squidlydeadly/projet-5-credits/Documents/Rapports/Rapport concepte/fichiers/echeancier1.JPG

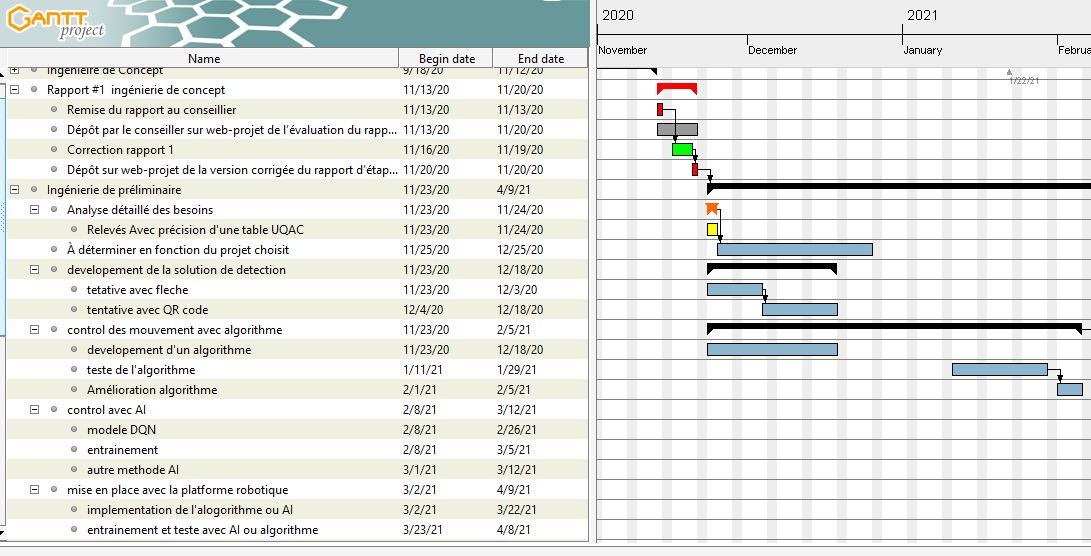
Documents/Rapports/Rapport concepte/fichiers/echeancier1.JPG
