squidlydeadly/projet-5-credits/Documents/Rapports/Rapport concepte/fichiers/echeancier.JPG

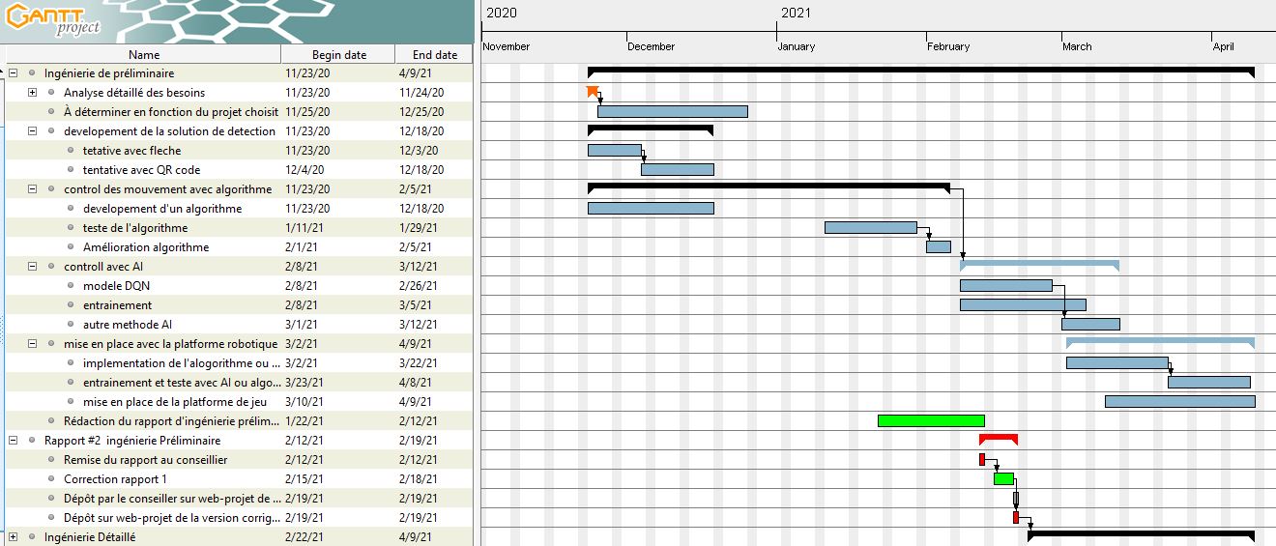
Documents/Rapports/Rapport concepte/fichiers/echeancier.JPG
