squidlydeadly/projet-5-credits/Documents/Estimations/estimation_concept.pdf

Achat de matériel | qte. | prix unitaire | total VAN($)
Plateforme robotique | 4.00 | 40.00 | 160.00
Camera | 1.00 | 150.00 | 150.00
Autres capteurs | 1.00 | 100.00 | 100.00
Impression des pièces | 4.00 | 25.00 | 100.00
Parcours | 1.00 | 200.00 | 200.00
Ordinateur serveur | 1.00 | 1500.00 | 1500.00
ESP32 | 4.00 | 15.00 | 60.00
Drive H-bridge | 4.00 | 5.00 | 20.00
servomoteur frappeur | 4.00 | 10.00 | 40.00
contrôleurs sans fil | 2.00 | 65.00 | 130.00
Pile LiPo | 4.00 | 25.00 | 100.00
quincaillerie | 1.00 | 200.00 | 200.00
support à caméra | 1.00 | 50.00 | 50.00
Router/commutateur de réseau | 1.00 | 100.00 | 100.00
| Sous total ($) | | 2910.00
Achat de logiciel et services | qte. | prix unitaire | total ($)
Éditeur de texte | 1 | 0 | 0
Open source M.L. API | 1 | 0 | 0
Simulateur de robotique | 1 | 0 | 0
| sous total ($) | | 0
Main d'œuvre et ing. | heures | taux horaire | total ($)
Recherche et documentation | 150 | 60 | 9000
Conception | 100 | 60 | 6000
Programmation et implémentation | 370 | 60 | 22200
Tests et améliorations | 100 | 60 | 6000
Fabrication des robots | 25 | 60 | 1500
Total des heures | 745
| sous total ($) | | 44700
| Grand total ($) | | 47610.00
Estimation de concepte | IA serveur local
