squidlydeadly/projet-5-credits/Documents/Rapports/Rapport concepte/fichiers/robot.pdf

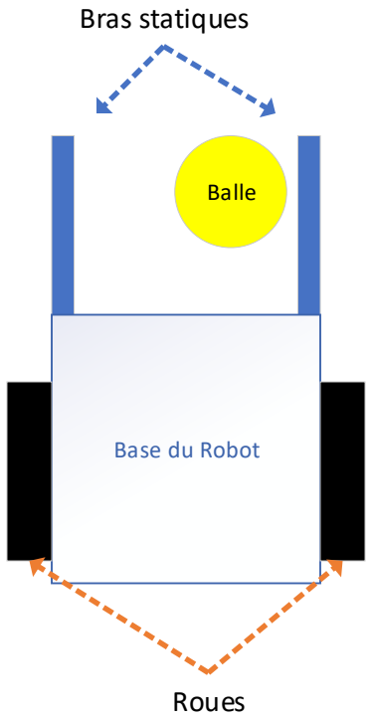
[picture p15: figure]
Base du Robot; Balle; Bras statiques; Roues
