squidlydeadly/projet-5-credits/Documents/Gantt/Échéanciers_détaillé.pdf

ID | Task Name | Duration | Start
1 | Proposition de services | 10 days | Thu 9/17/20
7 | Ingénieire de Concept | 40 days | Fri 9/18/20
26 Rapport #1 ingénierie de | concept | 6 days | Fri 11/13/20
31 | Ingénierie préliminaire | 86 days? | Mon 11/23/20
47 Rapport #2 ingénierie | Préliminaire | 6 days | Fri 2/12/21
52 | Ingénierie Détaillé | 31 days? | Mon 2/22/21
53 | Vision et controle | 41 days | Mon 2/8/21
54 Développement de | l'algorithme de vision sous sa forme actuelle | 26.5 days | Mon 2/8/21
55 | Monter le serveur MQTT | 6 days | Wed 3/3/21
56 Lier le contrôle des | robots avec le serveur | 3 days | Thu 3/11/21
57 Implémentation de | l'algorithme de vision | 4 days | Tue 3/16/21
58 Lier la vision avec la prise | de décision | 5 days | Sun 3/21/21
59 Rafiner l'algorithme de | vision | 8 days | Thu 3/25/21
60 Conception et réglage du | compensateur PID | 6 days | Thu 3/25/21
61 Dépoiement sur le Nvidia | Jeston | 4 days | Wed 3/31/21
13 | 16 | 19 | 22 | 25 | 28 | 3 | 6 | 9 | 12 | 15 | 18 | 21 | 24 | 27 | 30 | 2 | 5 | 8 | 11 | 14 | 17 | 20 | 23 | 26 | 29
March 2021 | April 2021

Task
Split
Milestone
Summary
Project Summary
Inactive Task
Inactive Milestone

Inactive Summary
Manual Task
Duration-only
Manual Summary Rollup
Manual Summary
Start-only
Finish-only

External Tasks
External Milestone
Deadline
Progress
Manual Progress

Page 1

Project: Project1
Date: Mon 4/5/21

62 | Parcours | 51 days | Fri 1/22/21
63 Achat et reception des | pièces du parcours | 21 days | Mon 3/1/21
64 Conception des pièces | imprimés pour le parcours | 20 days | Fri 1/22/21
65 Impression des pieces | imprimés 3D | 26.24 days | Fri 2/19/21
66 | Assemblage du parcours | 13 days | Tue 3/16/21
67 | Transport | 7 days | Thu 3/25/21
68 Achate de la valise de | transport | 2 days | Thu 3/25/21
69 Acquisition et | découpage de la mousse de trasnport | 1 day | Sat 3/27/21
70 Installation du support | à tige la valise de transport | 2 days | Thu 4/1/21
71 | Robots | 38 days | Thu 2/11/21
72 Programmation des | microcontroleurs | 23 days | Thu 2/18/21
73 Conception des pièces de | robot | 12 days | Wed 2/17/21
74 Impression des pièces de | robots | 2 days | Fri 3/5/21
75 | Assemblage des robots | 1 day | Sun 4/4/21

Project: Project1 Date: Mon 4/5/21

13 | 16 | 19 | 22 | 25 | 28 | 3 | 6 | 9 | 12 | 15 | 18 | 21 | 24 | 27 | 30 | 2 | 5 | 8 | 11 | 14 | 17 | 20 | 23 | 26 | 29

Task
Split
Milestone
Summary
Project Summary
Inactive Task
Inactive Milestone

Inactive Summary
Manual Task
Duration-only
Manual Summary Rollup
Manual Summary
Start-only
Finish-only

External Tasks
External Milestone
Deadline
Progress
Manual Progress

Page 2

76 Tester les robots | assemblés | 1 day | Mon 4/5/21
77 | Piles | 38 days | Thu 2/11/21
78 Évaluation de la pile à | acheter | 10 days | Thu 2/11/21
79 Achat des piles et | chargeurs | 26 days | Thu 2/25/21
80 Rédaction de la | procédure de recharge sécuritaire des piles | 4 days | Wed 3/31/21
81 Tester l'ensemble des | composantes | 2 days | Sat 4/3/21
82 Rapport #3 ingénierie | Détaillée | 7 days | Fri 3/26/21
83 Rédaction du rapport | détaillé | 24 days | Wed 3/3/21
84 Remise du rapport au | conseillier | 1 day | Fri 3/26/21
85 | Correction rapport 3 | 4 days | Mon 3/29/21
86 Dépôt par le conseiller | sur web-projet de l’évaluation du rapport d’étape 3; ingénierie | 1 day | Fri 4/2/21
13 | 16 | 19 | 22 | 25 | 28 | 3 | 6 | 9 | 12 | 15 | 18 | 21 | 24 | 27 | 30 | 2 | 5 | 8 | 11 | 14 | 17 | 20 | 23 | 26 | 29

Task
Split
Milestone
Summary
Project Summary
Inactive Task
Inactive Milestone

Inactive Summary
Manual Task
Duration-only
Manual Summary Rollup
Manual Summary
Start-only
Finish-only

External Tasks
External Milestone
Deadline
Progress
Manual Progress

Page 3

Project: Project1
Date: Mon 4/5/21

87 Dépôt sur web-projet de | la version corrigée du rapport d’étape #3 | 1 day | Fri 4/2/21
88 | Présentation du projet | 15 days | Fri 4/9/21
89 Préparation de la | présentation | 11 days | Mon 4/5/21
90 Péresentation devant les | conseilliers | 1 day | Sat 4/17/21
91 Dépot sur web-projet du | résumé de projet | 1 day | Fri 4/9/21
92 Présentations publiques des | projets devant jury | 1 day | Tue 4/20/21
93 Rencontre du | comité-aviseur – revue des évaluations de projets | 1 day | Thu 4/29/21
13 | 16 | 19 | 22 | 25 | 28 | 3 | 6 | 9 | 12 | 15 | 18 | 21 | 24 | 27 | 30 | 2 | 5 | 8 | 11 | 14 | 17 | 20 | 23 | 26 | 29

Task
Split
Milestone
Summary
Project Summary
Inactive Task
Inactive Milestone

Inactive Summary
Manual Task
Duration-only
Manual Summary Rollup
Manual Summary
Start-only
Finish-only

External Tasks
External Milestone
Deadline
Progress
Manual Progress

Page 4

Project: Project1
Date: Mon 4/5/21
