squidlydeadly/projet-5-credits/Documents/Estimations/comparaisonDesAlgo.pdf

Algorithme | Facilité d'implémentation relatives | Performances relatives | Total
Simple | 4 | 2 | 6
Q-learning en profondeur | 3 | 4 | 7
IA avancés | 1 | 5 | 6

Comparaison des Algorithmes
