squidlydeadly/projet-5-credits/Documents/Estimations/comparaisonDesAlgo2.pdf

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
Simple | Q-learning en profondeur | IA avancés

## Comparaison des algorithmes

Facilité d'implémentation relatives Performances relatives
