squidlydeadly/projet-5-credits/Documents/Estimations/matrice-de-descision-1.pdf

Gestion de projet général
Respet des échéanciers | 5 | 2 | 10 | 4 | 20 | 5 | 25
cout d'acquisition | 3 | 3 | 9 | 2 | 6 | 5 | 15
Cout d'utilisation | 2 | 5 | 10 | 5 | 10 | 3 | 6

Santé-sécurité et environnement
sécurité machine | 5 | 3 | 15 | 5 | 25 | 5 | 25
Transportabilité (sst) | 5 | 4 | 20 | 4 | 20 | 5 | 25
Environnement (piles, achats) | 4 | 3 | 12 | 4 | 16 | 4 | 16

Informatique et réseaux
dépendance au réseau | 4 | 5 | 20 | 3 | 12 | 1 | 4
dépendance au service | 4 | 5 | 20 | 5 | 20 | 1 | 4
possibilité de co-opération | 2 | 2 | 4 | 5 | 10 | 5 | 10
Possibilité d'expansion | 2 | 2 | 4 | 5 | 10 | 5 | 10
fiabilité réseau | 5 | 5 | 25 | 4 | 20 | 3 | 15
sécurité réseau | 4 | 5 | 20 | 3 | 12 | 2 | 8
capacité de calcul | 4 | 2 | 8 | 4 | 16 | 5 | 20

Utilisation en présentation
respet des dimensions | 3 | 1 | 3 | 5 | 15 | 5 | 15
Temps de déploiement (en présentation) | 5 | 5 | 25 | 4 | 20 | 4 | 20
facilité de déploiement | 4 | 5 | 20 | 3 | 12 | 3 | 12
Total | | | 225 | | 244 | | 230

### Solution

Aspect analysé | Ponderation (1 - 5) | Edge | Local | Cloud
Cote 1-5 | Total | Cote 1-5 | Total | Cote 1-5 | Total
