squidlydeadly/projet-5-credits/$_10.jpg

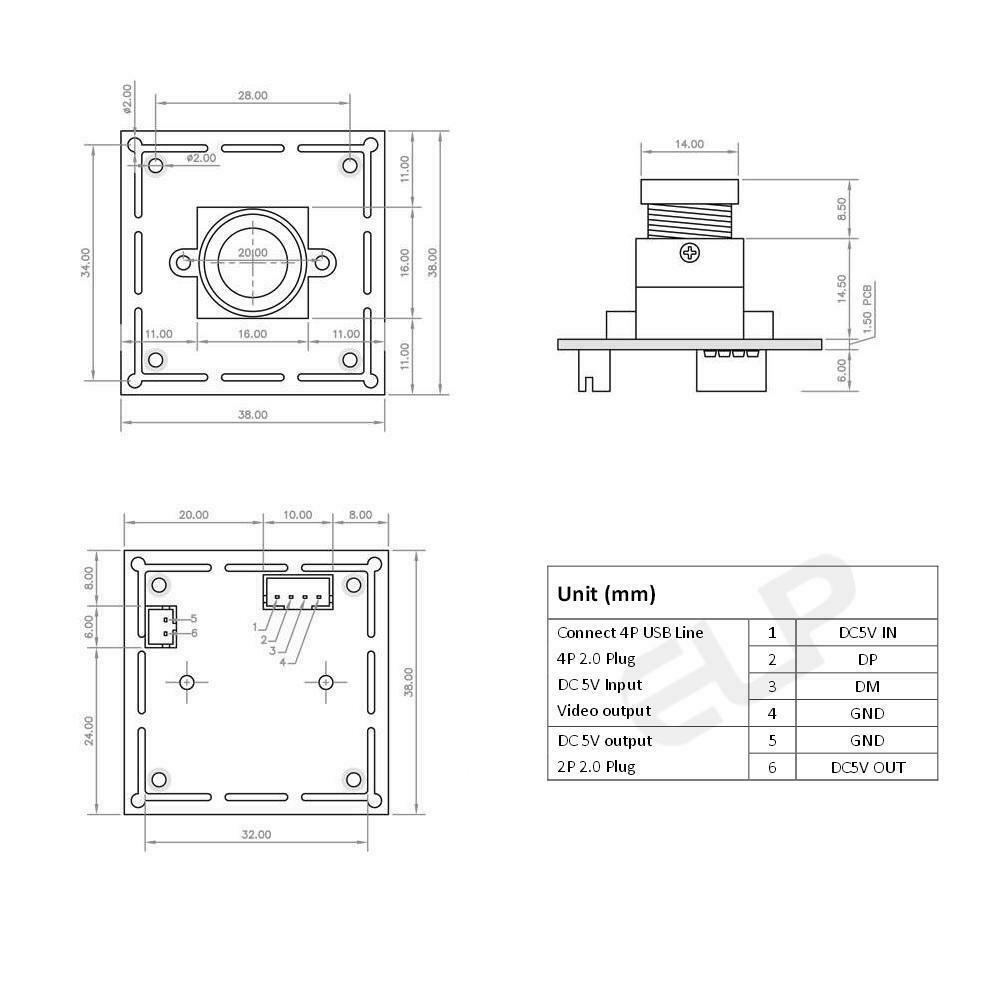
$_10.jpg
