squidlydeadly/projet-5-credits/CAD_and_drawing/img/cam.png

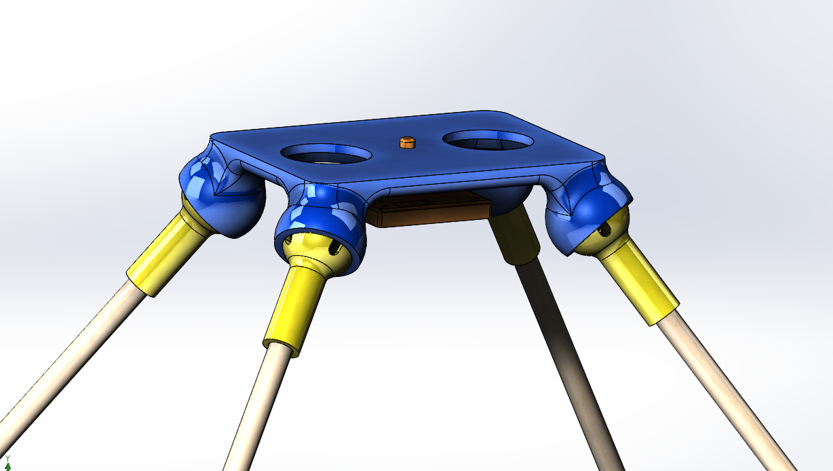
CAD_and_drawing/img/cam.png
