squidlydeadly/projet-5-credits/CAD_and_drawing/img/corner.png

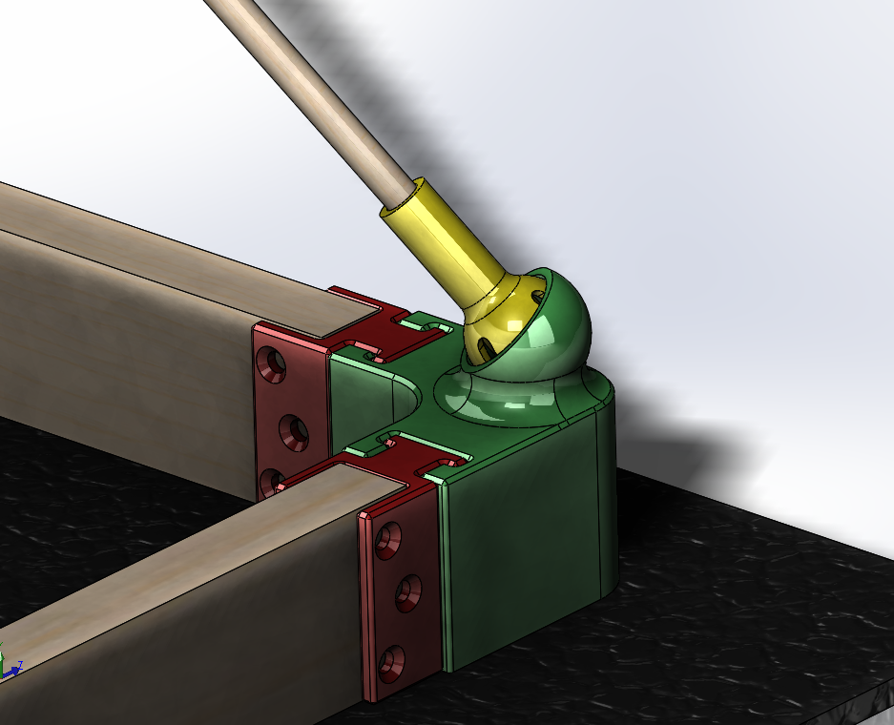
CAD_and_drawing/img/corner.png
