squidlydeadly/projet-5-credits/CAD_and_drawing/img/goal.png

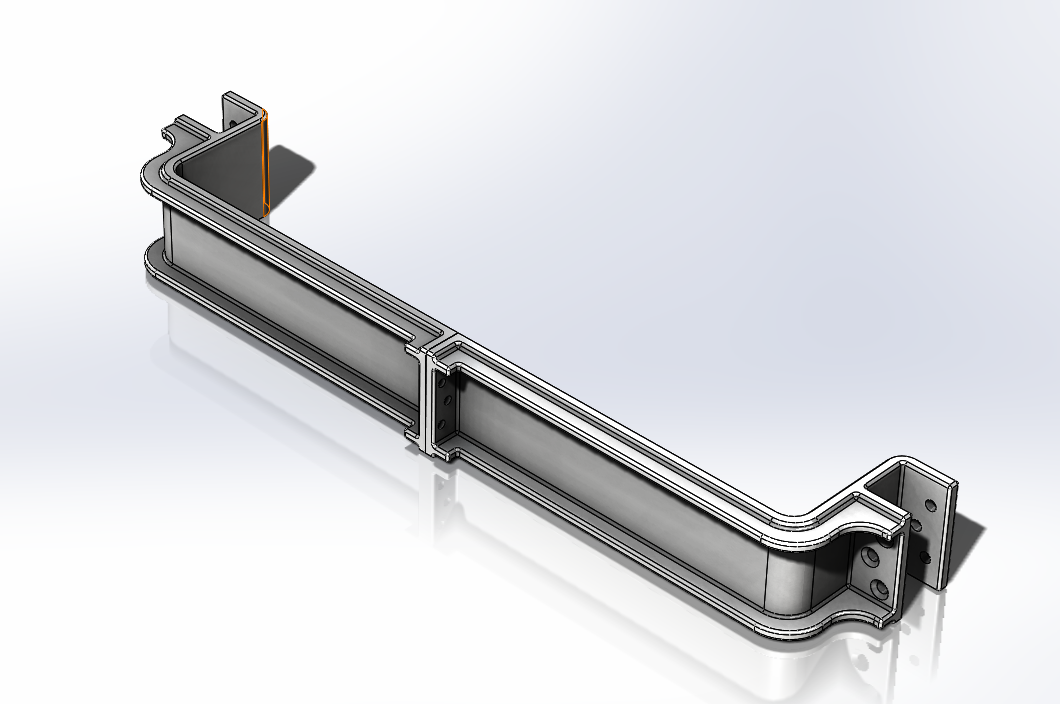
CAD_and_drawing/img/goal.png
