squidlydeadly/projet-5-credits/CAD_and_drawing/img/robot_CAD.png

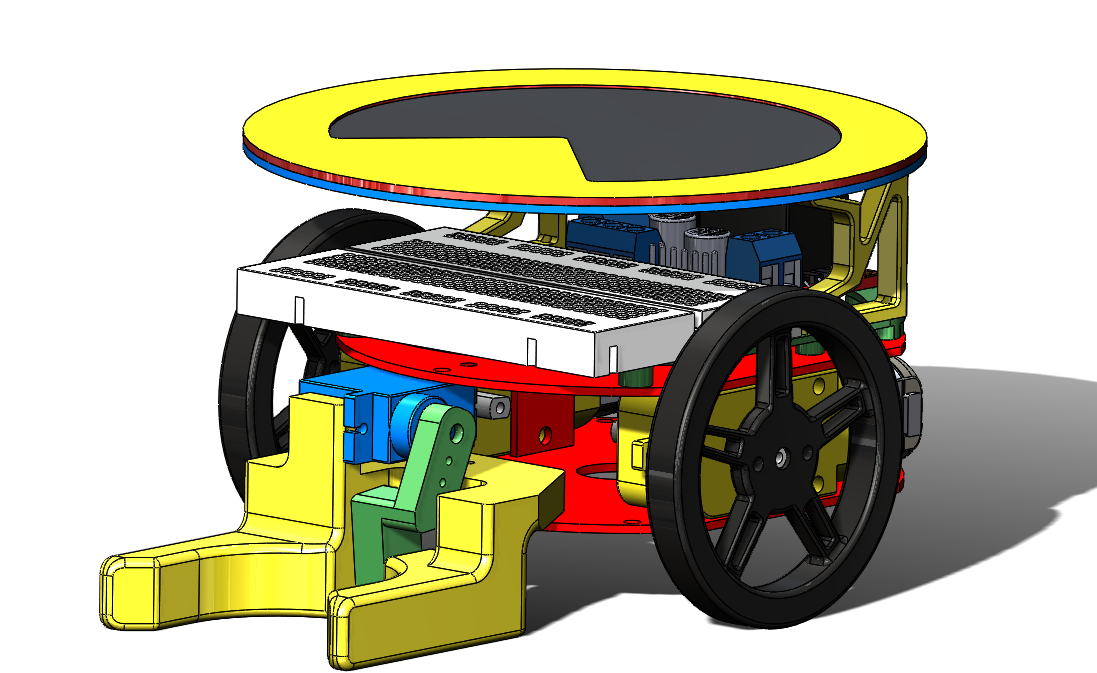
CAD_and_drawing/img/robot_CAD.png
