squidlydeadly/projet-5-credits/CAD_and_drawing/img/Screenshot 2021-03-29 090037.png

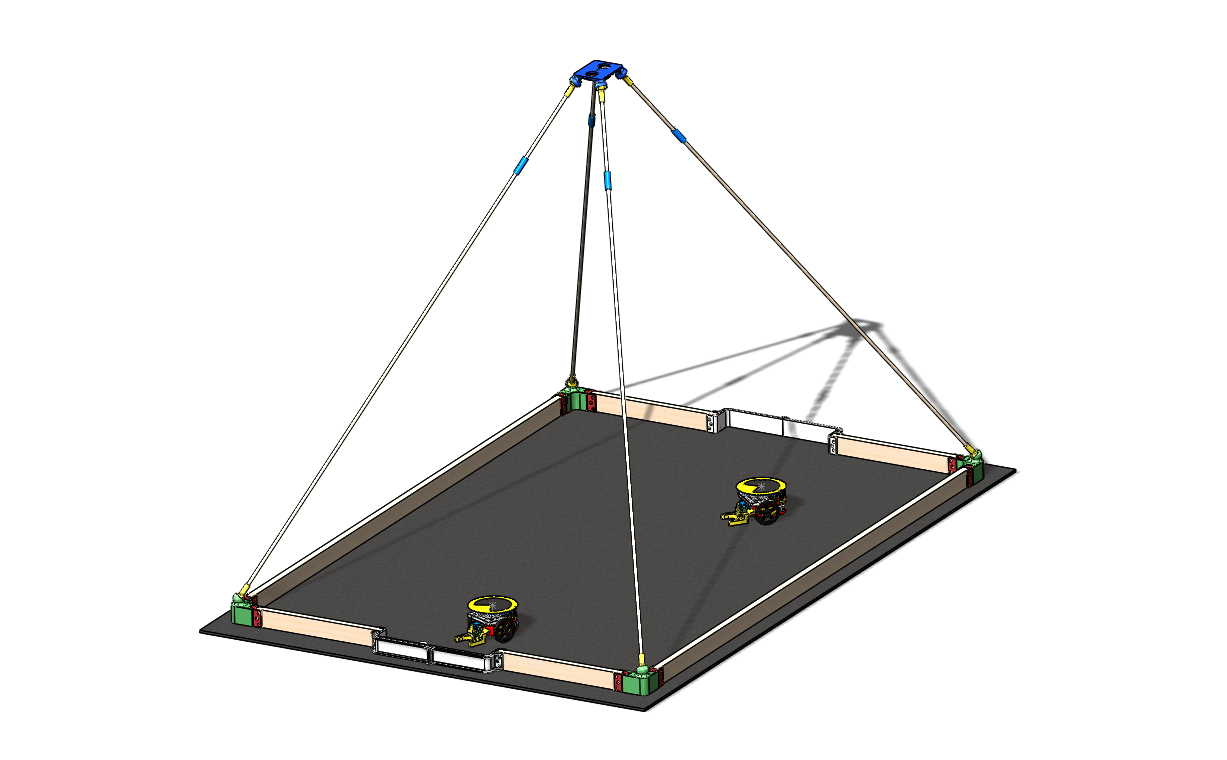
CAD_and_drawing/img/Screenshot 2021-03-29 090037.png
