squidlydeadly/projet-5-credits/CAD_and_drawing/img/Screenshot 2021-03-29 091518.png

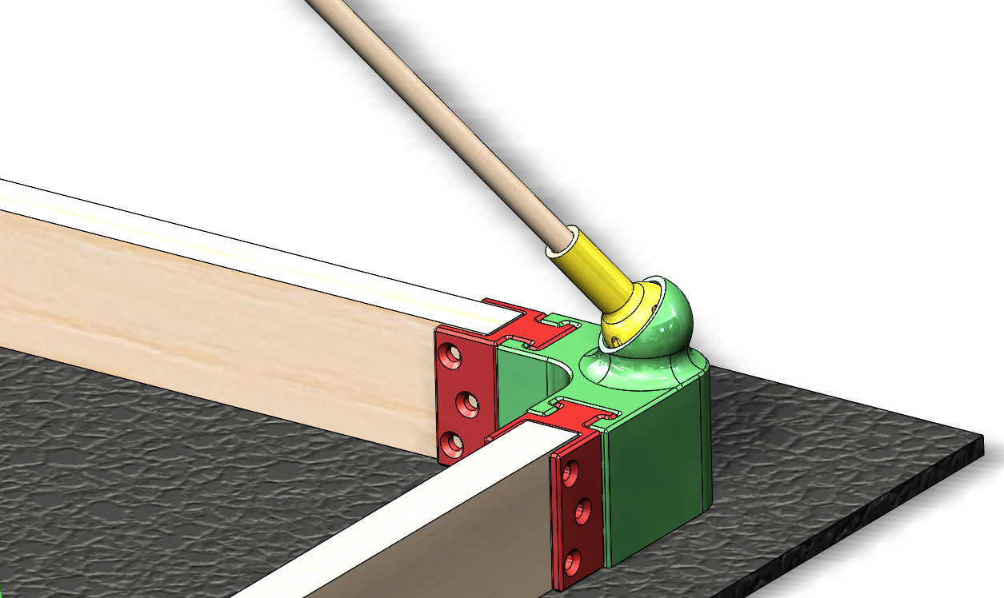
CAD_and_drawing/img/Screenshot 2021-03-29 091518.png
