squidlydeadly/projet-5-credits/CAD_and_drawing/img/Screenshot 2021-03-31 142544.png

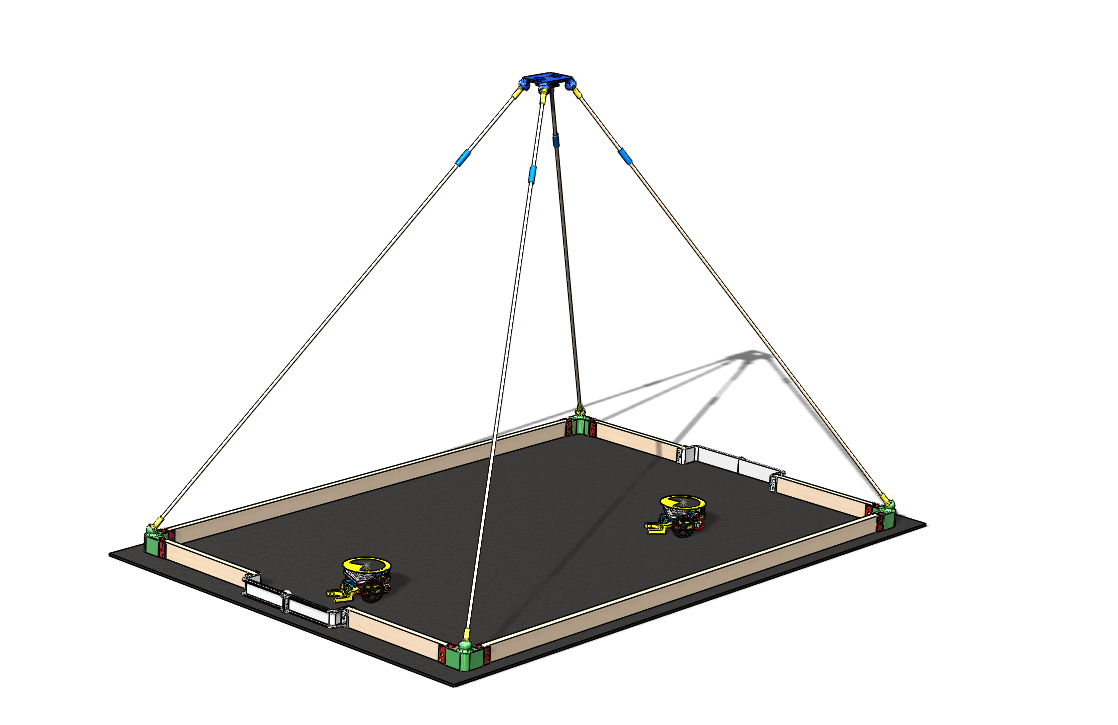
CAD_and_drawing/img/Screenshot 2021-03-31 142544.png
