squidlydeadly/projet-5-credits/CAD_and_drawing/img/terrsin.png

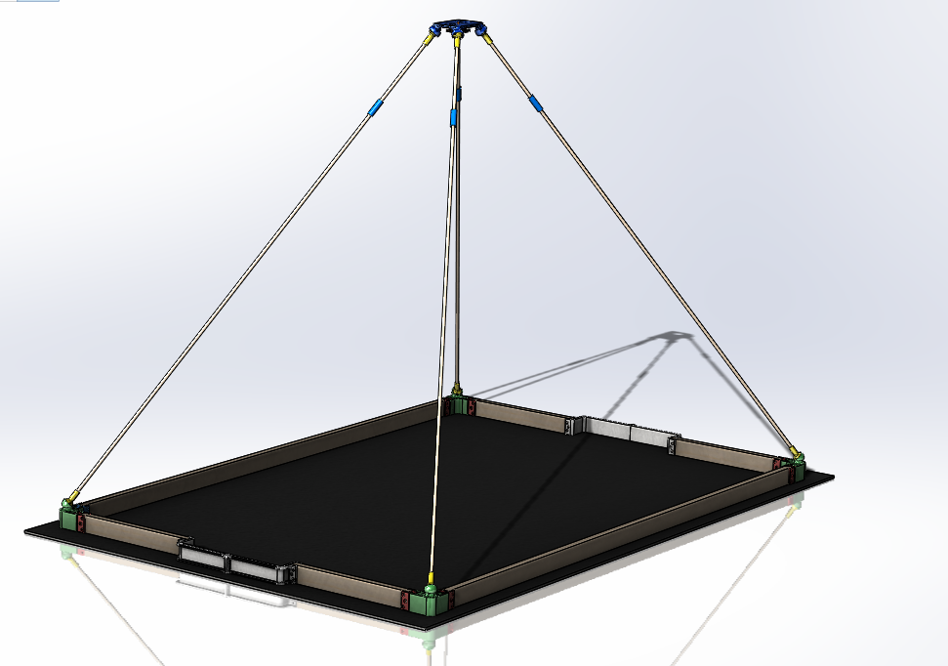
CAD_and_drawing/img/terrsin.png
