squidlydeadly/projet-5-credits/CAD_and_drawing/ROBOT/Assem1.PNG

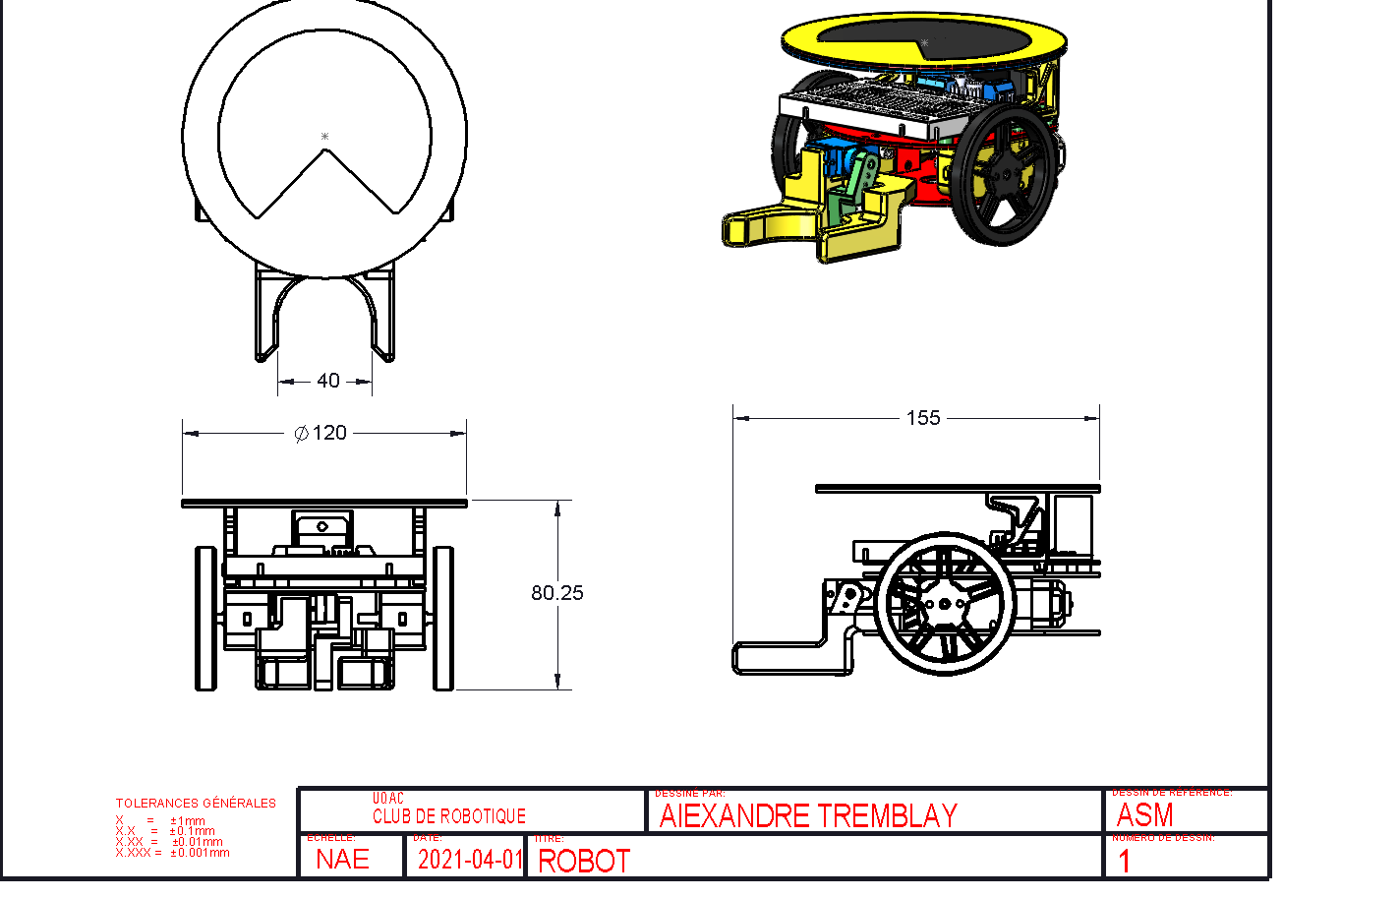
CAD_and_drawing/ROBOT/Assem1.PNG
