squidlydeadly/projet-5-credits/CAD_and_drawing/ROBOT/robot.png

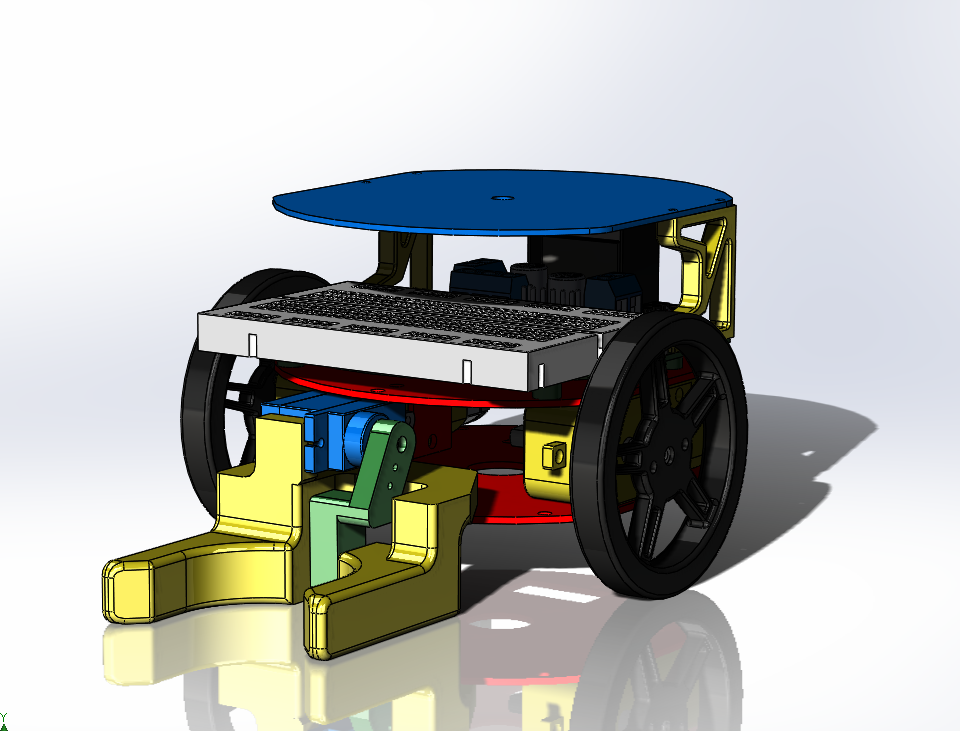
CAD_and_drawing/ROBOT/robot.png
