squidlydeadly/projet-5-credits/CAD_and_drawing/ROBOT/Screenshot 2020-12-28 092606.png

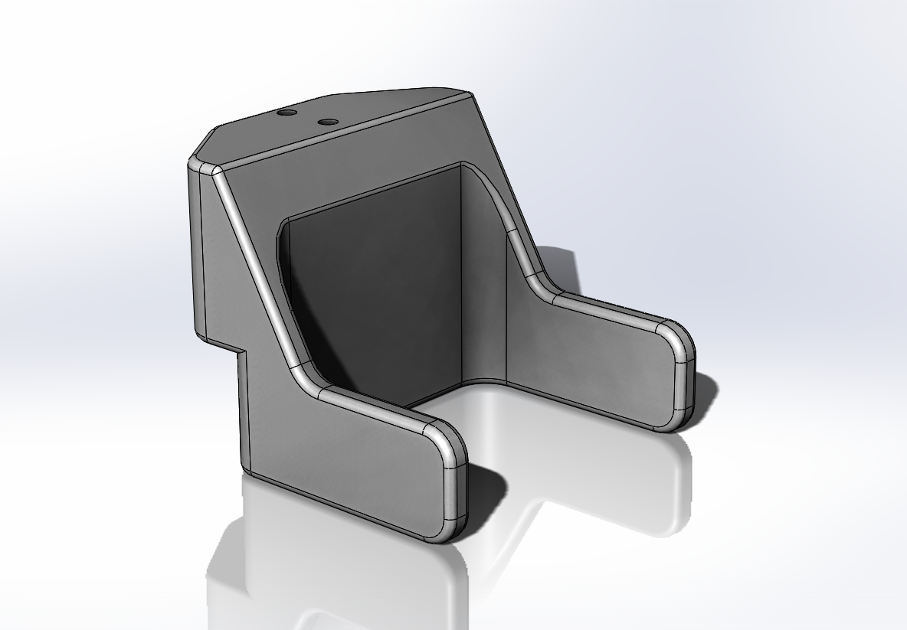
CAD_and_drawing/ROBOT/Screenshot 2020-12-28 092606.png
