squidlydeadly/projet-5-credits/CAD_and_drawing/ROBOT/Screenshot 2021-02-18 114827.png

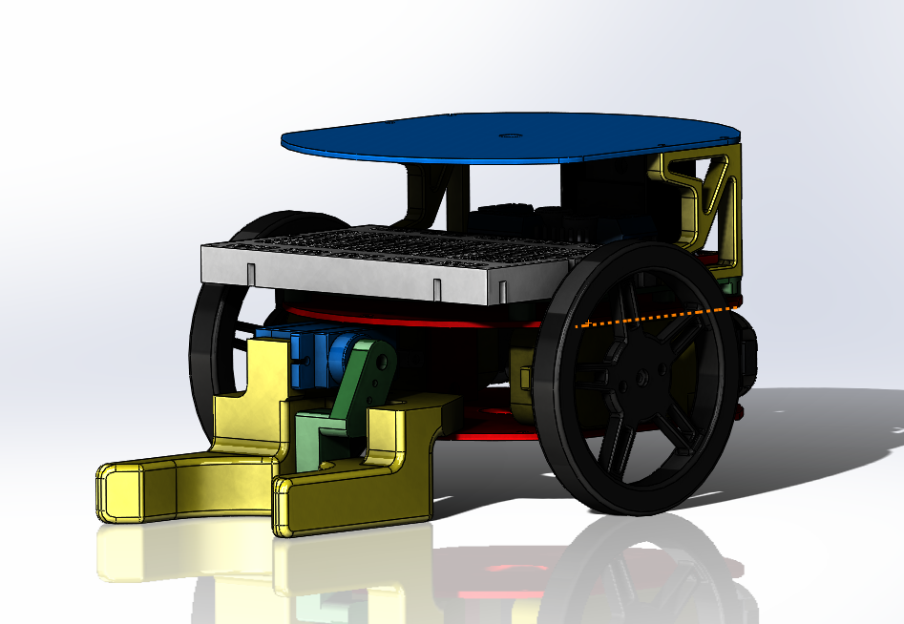
CAD_and_drawing/ROBOT/Screenshot 2021-02-18 114827.png
