squidlydeadly/projet-5-credits/CAD_and_drawing/ROBOT/Screenshot 2021-02-18 115133.png

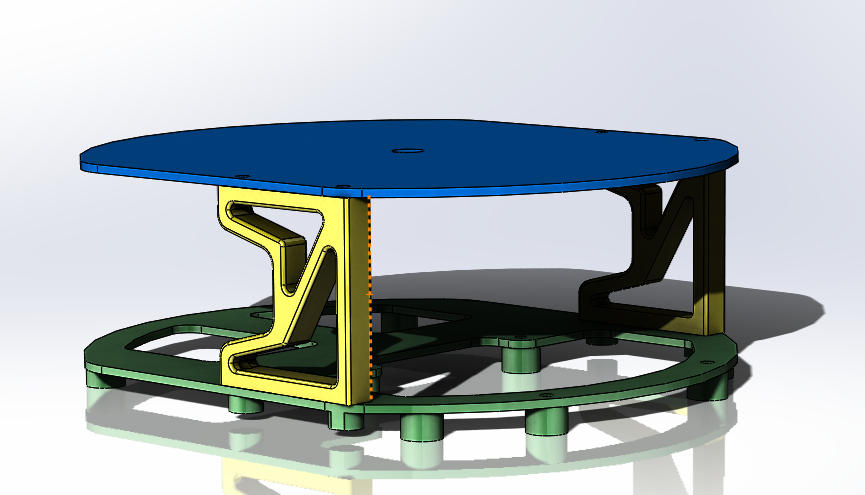
CAD_and_drawing/ROBOT/Screenshot 2021-02-18 115133.png
