squidlydeadly/projet-5-credits/CAD_and_drawing/ROBOT/support.png

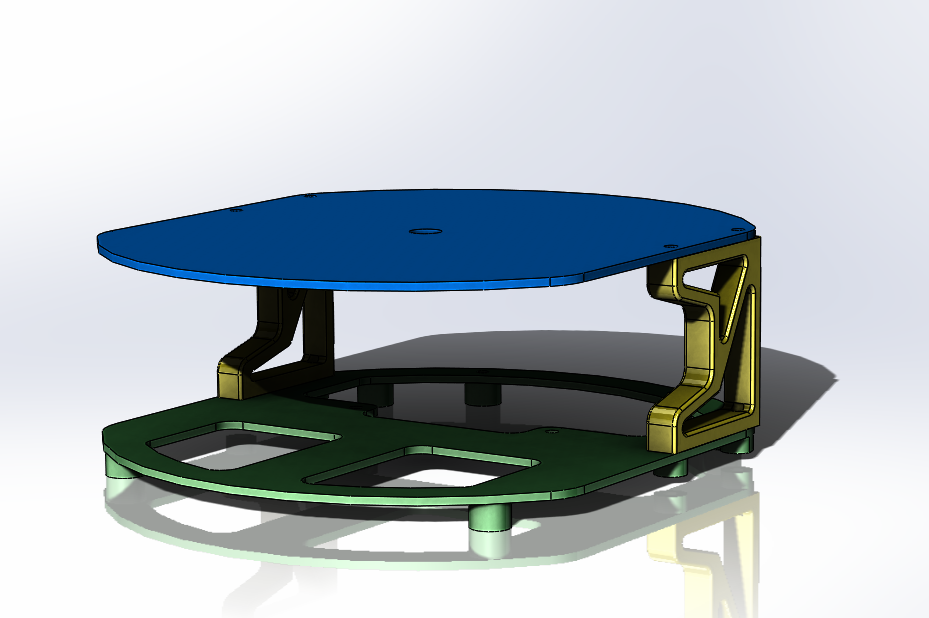
CAD_and_drawing/ROBOT/support.png
