squidlydeadly/projet-5-credits/CAD_and_drawing/TERRAIN/TERRAIN.PNG

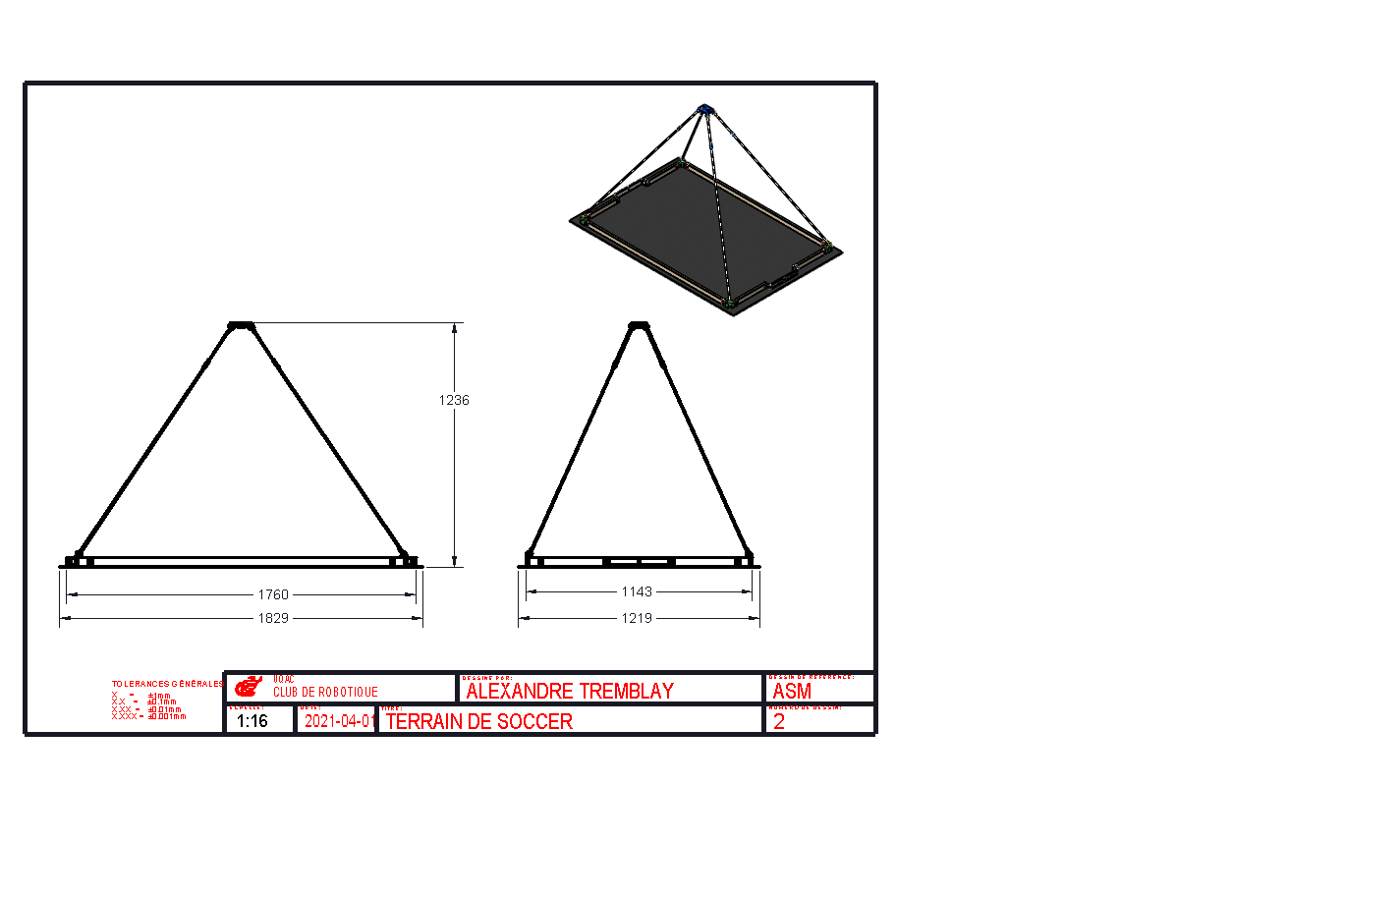
CAD_and_drawing/TERRAIN/TERRAIN.PNG
