squidlydeadly/projet-5-credits/Documents/Gantt/Projet1.jpg

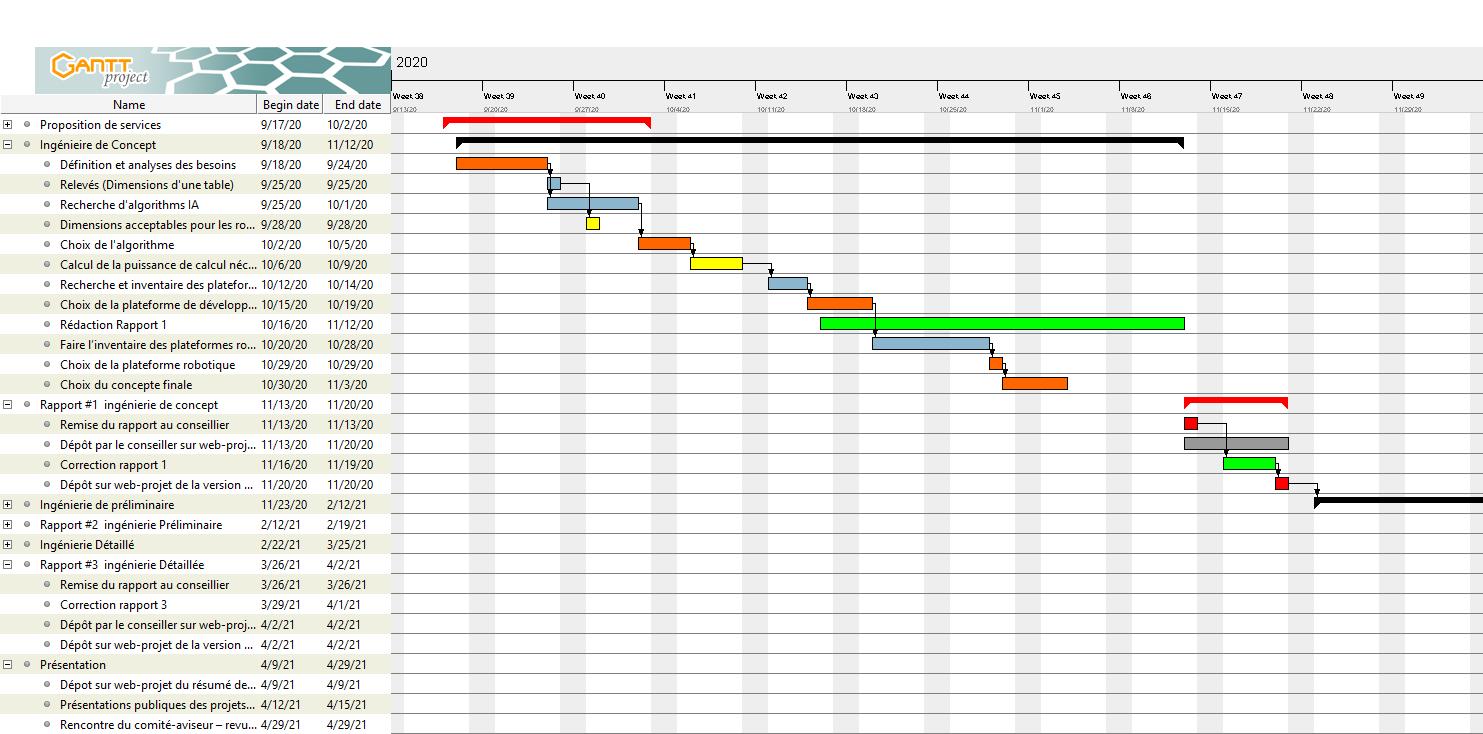
Documents/Gantt/Projet1.jpg
