squidlydeadly/projet-5-credits/Documents/Gantt/Projet2.jpg

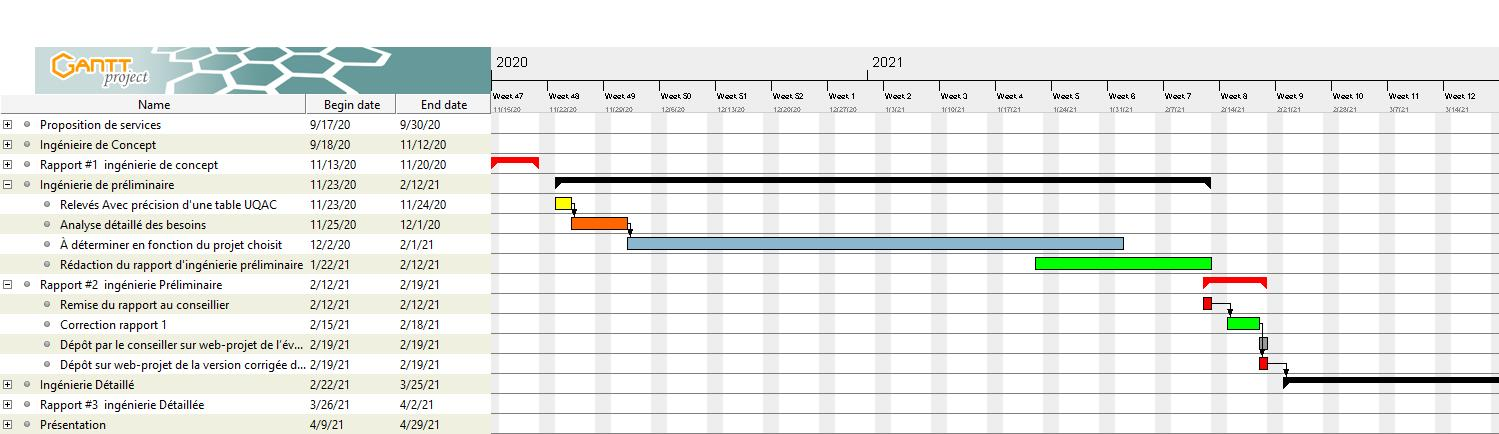
Documents/Gantt/Projet2.jpg
