squidlydeadly/projet-5-credits/Documents/Gantt/Projet3.jpg

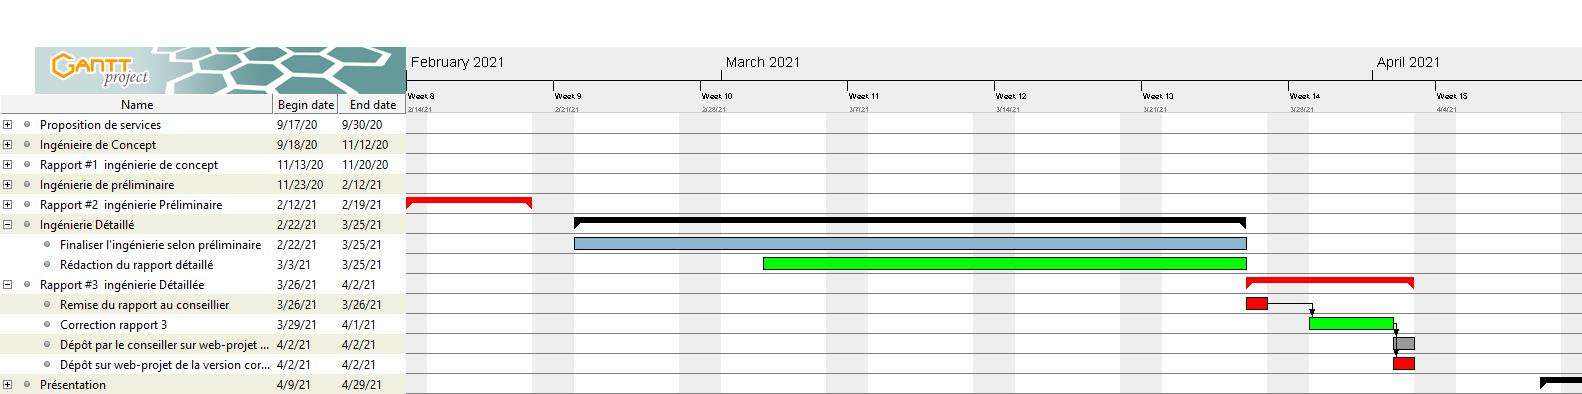
Documents/Gantt/Projet3.jpg
