squidlydeadly/projet-5-credits/Documents/Gantt/Projet4.jpg

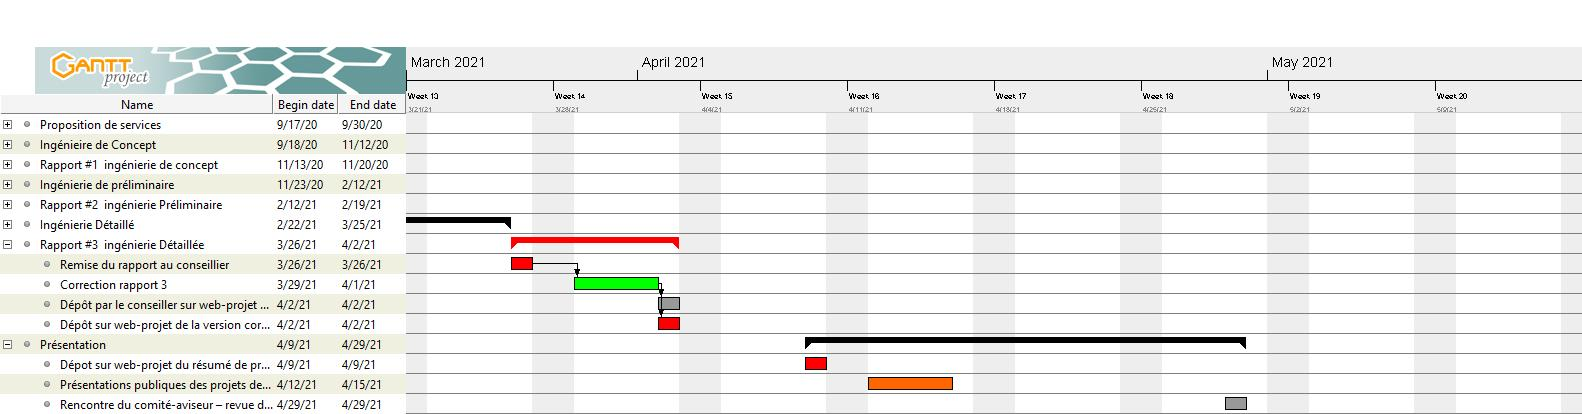
Documents/Gantt/Projet4.jpg
