squidlydeadly/projet-5-credits/Documents/Rapports/Rapport concepte/fichiers/echeancier2.JPG

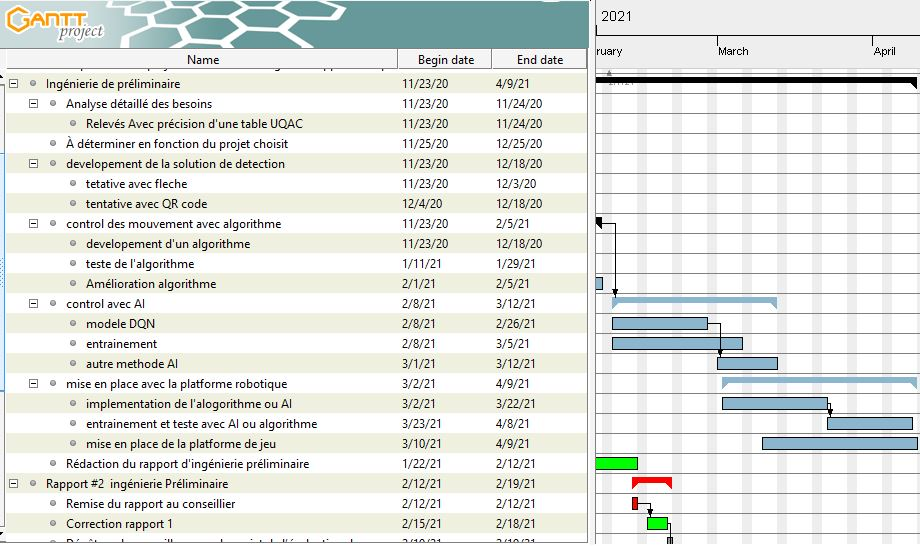
Documents/Rapports/Rapport concepte/fichiers/echeancier2.JPG
