squidlydeadly/projet-5-credits/Documents/Rapports/Rapport concepte/fichiers/images estimations/cloud.PNG

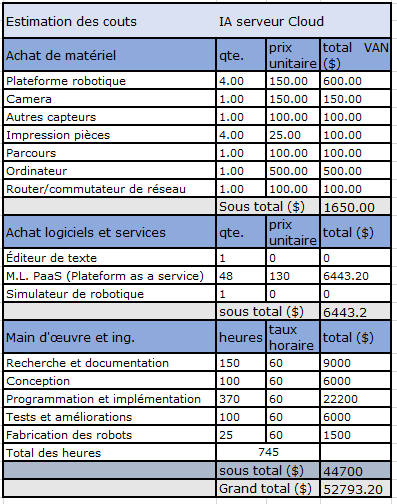
Documents/Rapports/Rapport concepte/fichiers/images estimations/cloud.PNG
