squidlydeadly/projet-5-credits/Documents/Rapports/Rapport concepte/fichiers/images estimations/embarque.PNG

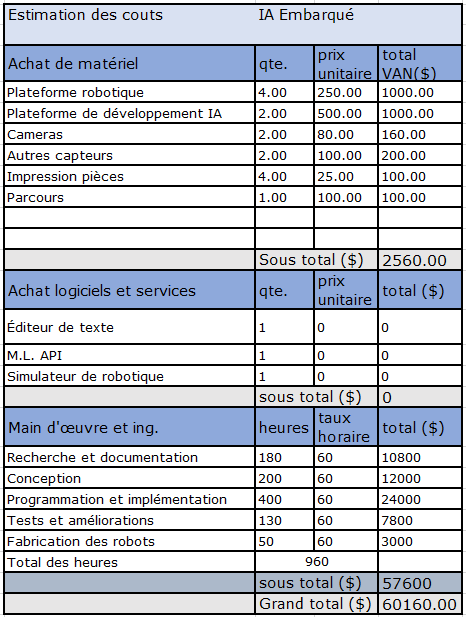
Documents/Rapports/Rapport concepte/fichiers/images estimations/embarque.PNG
