squidlydeadly/projet-5-credits/Documents/Rapports/Rapport concepte/fichiers/images estimations/Estimation final.JPG

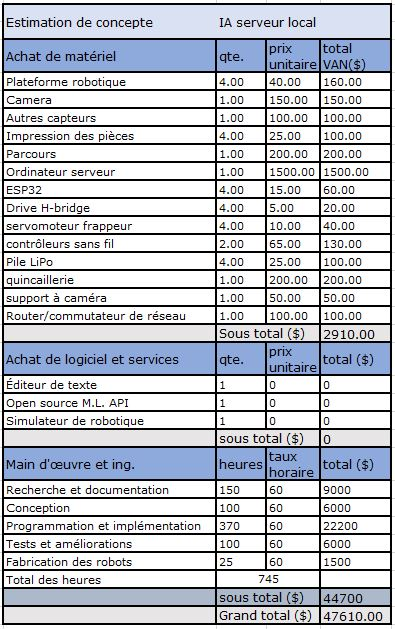
Documents/Rapports/Rapport concepte/fichiers/images estimations/Estimation final.JPG
