squidlydeadly/projet-5-credits/Documents/Rapports/Rapport concepte/fichiers/images estimations/local.PNG

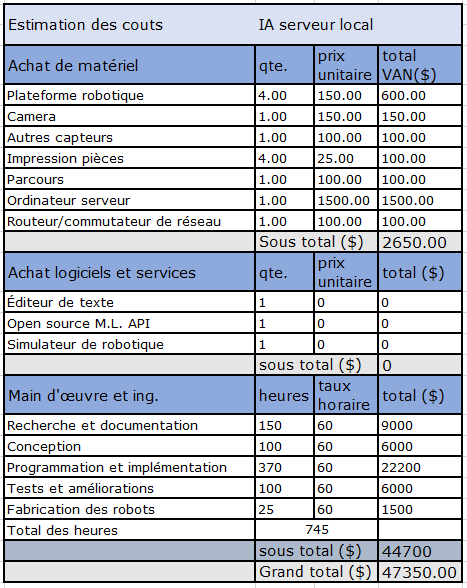
Documents/Rapports/Rapport concepte/fichiers/images estimations/local.PNG
