squidlydeadly/projet-5-credits/Documents/Rapports/Rapport concepte/fichiers/Matrices de décisions/solution.JPG

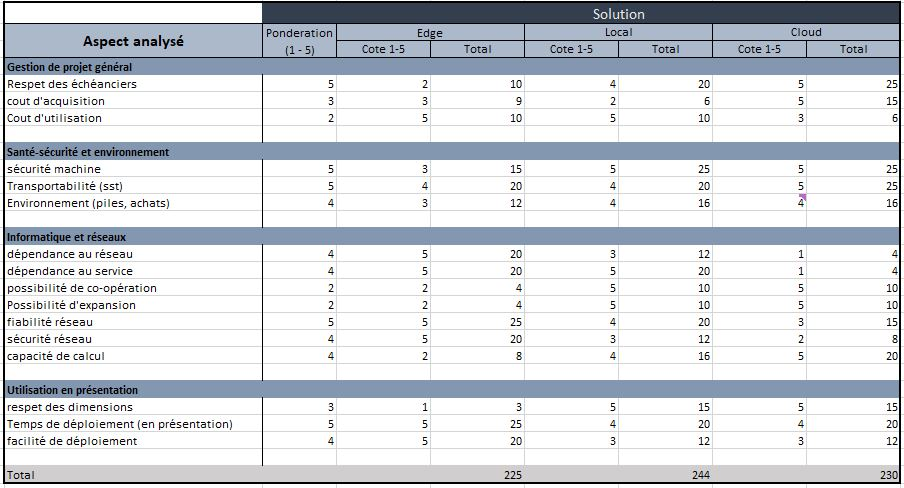
Documents/Rapports/Rapport concepte/fichiers/Matrices de décisions/solution.JPG
