squidlydeadly/projet-5-credits/Documents/Rapports/Rapport concepte/fichiers/mcu.JPG

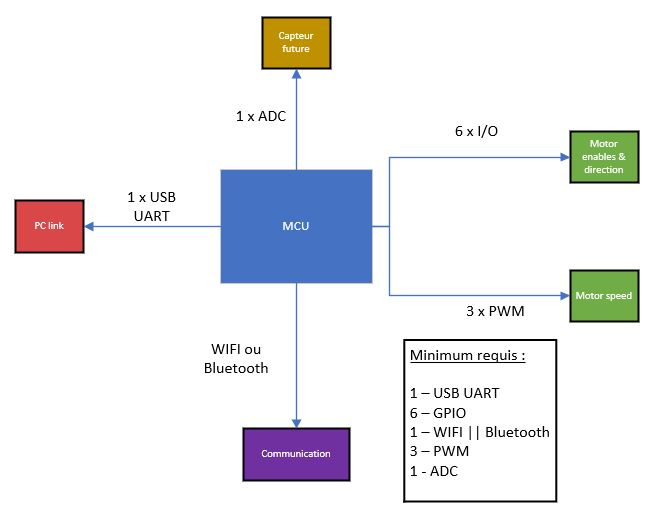
Documents/Rapports/Rapport concepte/fichiers/mcu.JPG
