squidlydeadly/projet-5-credits/Documents/Rapports/Rapport concepte/fichiers/schemas/cloud.JPG

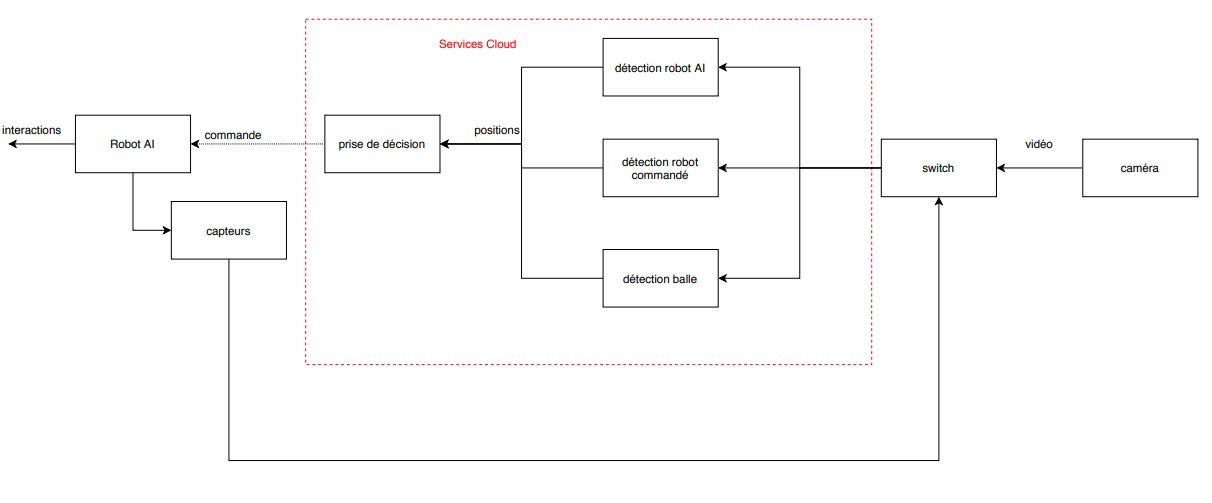
Documents/Rapports/Rapport concepte/fichiers/schemas/cloud.JPG
