squidlydeadly/projet-5-credits/Documents/Rapports/Rapport concepte/fichiers/schemas/edge.JPG

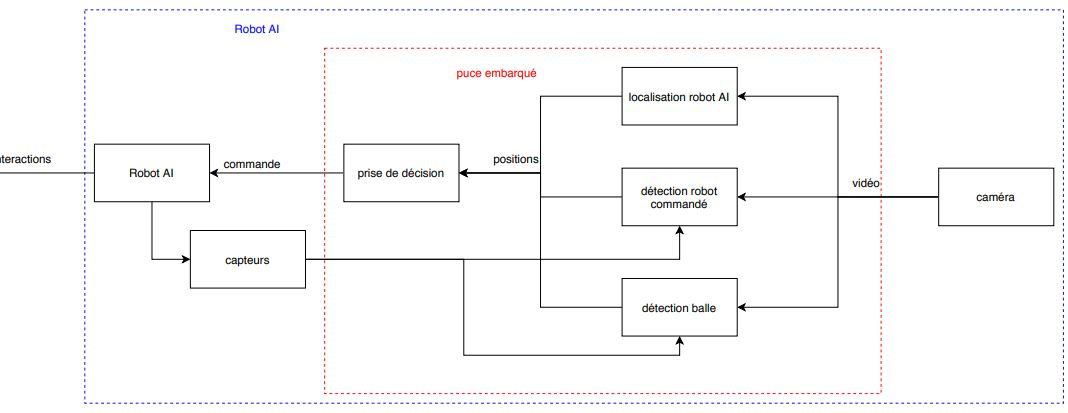
Documents/Rapports/Rapport concepte/fichiers/schemas/edge.JPG
