squidlydeadly/projet-5-credits/Documents/Rapports/Rapport concepte/fichiers/schemas/local.JPG

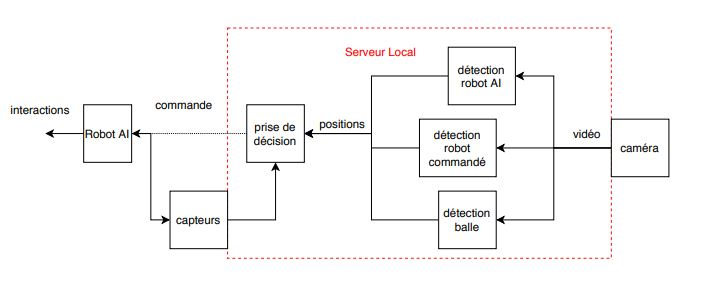
Documents/Rapports/Rapport concepte/fichiers/schemas/local.JPG
