squidlydeadly/projet-5-credits/Gestion/Factures/Alexandre Tremblay/2021_03_08 08_55.jpg

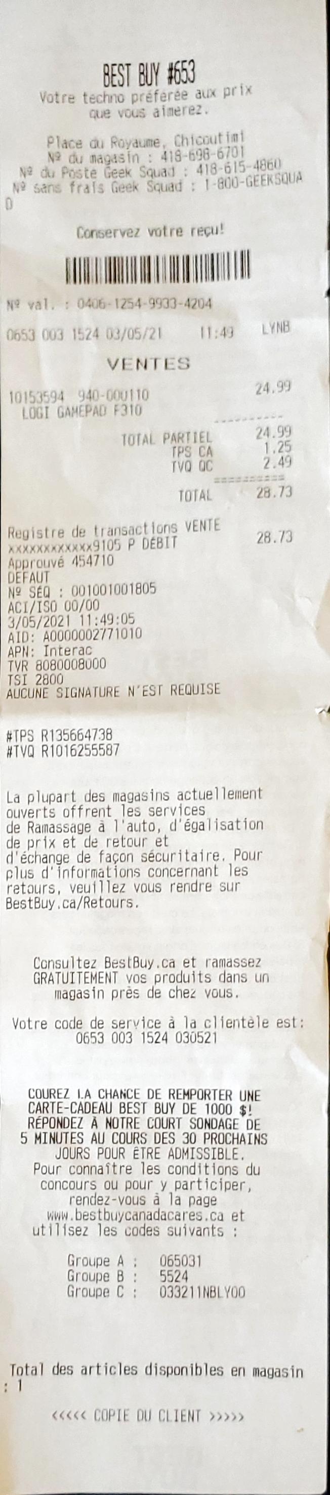
Gestion/Factures/Alexandre Tremblay/2021_03_08 08_55.jpg
