squidlydeadly/projet-5-credits/PCB/PCB_PCB_2021-03-02_13-19-38_2021-03-27_08-49-23.png

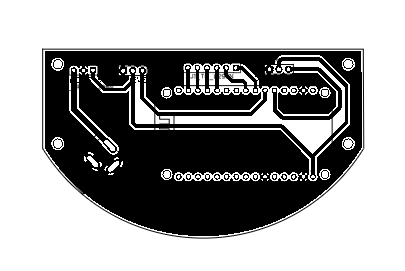
PCB/PCB_PCB_2021-03-02_13-19-38_2021-03-27_08-49-23.png
