squidlydeadly/projet-5-credits/PCB/Screenshot 2021-03-27 084953.png

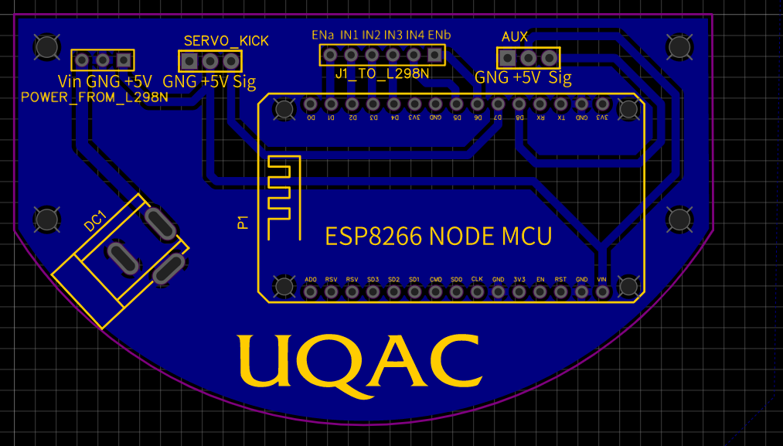
PCB/Screenshot 2021-03-27 084953.png
