squidlydeadly/projet-5-credits/PCB/Screenshot 2021-03-31 143029.png

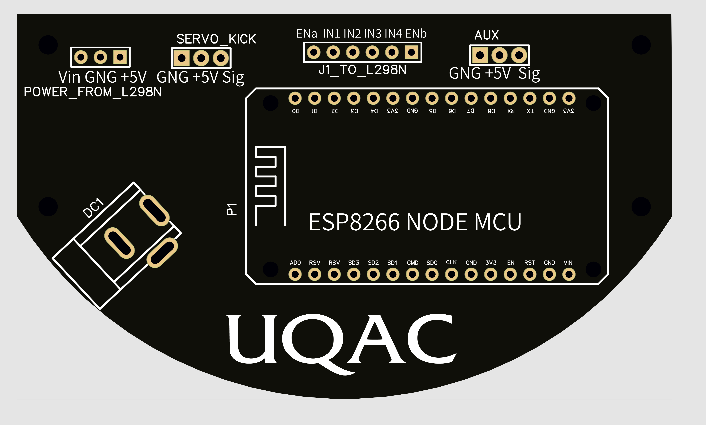
PCB/Screenshot 2021-03-31 143029.png
