squidlydeadly/projet-5-credits/PCB/Screenshot 2021-03-31 143052.png

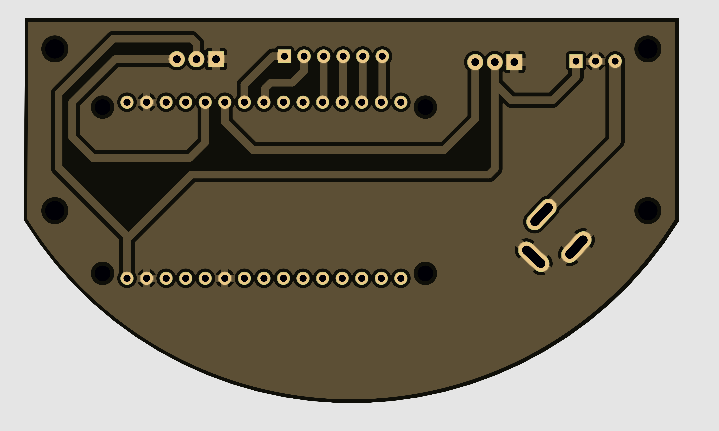
PCB/Screenshot 2021-03-31 143052.png
