squidlydeadly/projet-5-credits/PCB/Screenshot 2021-04-01 092254.png

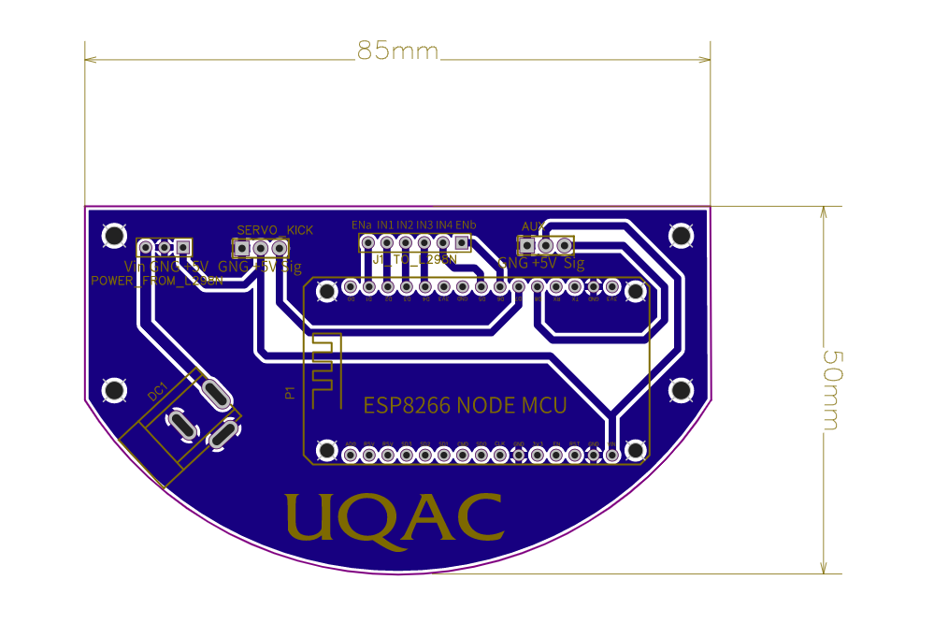
PCB/Screenshot 2021-04-01 092254.png
