squidlydeadly/projet-5-credits/Documents/Estimations/Estimations_architecture.xlsx

Sheet: Sheet1
 |  |  |  | nombres de robots total | 4
Estimation des couts | IA Embarqué
 |  |  |  | mois de vie | 48
Achat de matériel | qte. | prix unitaire | total VAN($)
Plateforme robotique | 4.00 | 250.00 | 1000.00
Plateforme de développement IA | 2.00 | 500.00 | 1000.00
Cameras | 2.00 | 80.00 | 160.00
Autres capteurs | 2.00 | 100.00 | 200.00
Impression pièces | 4.00 | 25.00 | 100.00
Parcours | 1.00 | 100.00 | 100.00
 | Sous total ($) |  | 2560.00
Achat logiciels et services | qte. | prix unitaire | total ($)
Éditeur de texte | 1 | 0 | 0
M.L. API | 1 | 0 | 0
Simulateur de robotique | 1 | 0 | 0
 | sous total ($) |  | 0
Main d'œuvre et ing. | heures | taux horaire | total ($)
Recherche et documentation | 180 | 60 | 10800
Conception | 200 | 60 | 12000
Programmation et implémentation | 400 | 60 | 24000
Tests et améliorations | 130 | 60 | 7800
Fabrication des robots | 50 | 60 | 3000 | temps en conception ++ et ++ cout par robot AI
Total des heures | 960
 | sous total ($) |  | 57600
 | Grand total ($) |  | 60160.00
Estimation des couts | IA serveur local
Achat de matériel | qte. | prix unitaire | total VAN($)
Plateforme robotique | 4.00 | 150.00 | 600.00
Camera | 1.00 | 150.00 | 150.00
Autres capteurs | 1.00 | 100.00 | 100.00
Impression pièces | 4.00 | 25.00 | 100.00
Parcours | 1.00 | 100.00 | 100.00
Ordinateur serveur | 1.00 | 1500.00 | 1500.00
Router/commutateur de réseau | 1.00 | 100.00 | 100.00
 | Sous total ($) |  | 2650.00
Achat logiciels et services | qte. | prix unitaire | total ($)
Éditeur de texte | 1 | 0 | 0
Open source M.L. API | 1 | 0 | 0
Simulateur de robotique | 1 | 0 | 0
 | sous total ($) |  | 0
Main d'œuvre et ing. | heures | taux horaire | total ($) | prix à l'achat ++ mais plus standard avec n plus grand
Recherche et documentation | 150 | 60 | 9000
Conception | 100 | 60 | 6000
Programmation et implémentation | 370 | 60 | 22200
Tests et améliorations | 100 | 60 | 6000
Fabrication des robots | 25 | 60 | 1500
Total des heures | 745
 | sous total ($) |  | 44700
 | Grand total ($) |  | 47350.00
Estimation des couts | IA serveur Cloud
Achat de matériel | qte. | prix unitaire | total VAN ($)
Plateforme robotique | 4.00 | 150.00 | 600.00
Camera | 1.00 | 150.00 | 150.00
Autres capteurs | 1.00 | 100.00 | 100.00
Impression pièces | 4.00 | 25.00 | 100.00
Parcours | 1.00 | 100.00 | 100.00
Ordinateur | 1.00 | 500.00 | 500.00
Router/commutateur de réseau | 1.00 | 100.00 | 100.00
 | Sous total ($) |  | 1650.00
Achat logiciels et services | qte. | prix unitaire | total ($)
Éditeur de texte | 1 | 0 | 0
M.L. PaaS (Plateform as a service) | 48 | 130 | 8730.97 | Trouver le prix PAAS/mois
Simulateur de robotique | 1 | 0 | 0
 | sous total ($) |  | 8730.968727 | pas chere à L'acquisition mais chere ++ au long term
Main d'œuvre et ing. | heures | taux horaire | total ($)
Recherche et documentation | 150 | 60 | 9000
Conception | 100 | 60 | 6000
Programmation et implémentation | 370 | 60 | 22200
Tests et améliorations | 100 | 60 | 6000
Fabrication des robots | 25 | 60 | 1500 | apres 8 mois local est plus rentable
Total des heures | 745
 | sous total ($) |  | 44700
 | Grand total ($) |  | 55080.97
 |  |  |  | VAN | #VALUE!
Estimation de concepte | IA serveur local
Achat de matériel | qte. | prix unitaire | total VAN($)
Plateforme robotique | 4.00 | 40.00 | 160.00
Camera | 1.00 | 150.00 | 150.00
Autres capteurs | 1.00 | 100.00 | 100.00
Impression des pièces | 4.00 | 25.00 | 100.00
Parcours | 1.00 | 200.00 | 200.00
Ordinateur serveur | 1.00 | 1500.00 | 1500.00
ESP32 | 4.00 | 15.00 | 60.00
Drive H-bridge | 4.00 | 5.00 | 20.00
servomoteur frappeur | 4.00 | 10.00 | 40.00
contrôleurs sans fil | 2.00 | 65.00 | 130.00
Pile LiPo | 4.00 | 25.00 | 100.00
quincaillerie | 1.00 | 200.00 | 200.00
support à caméra | 1.00 | 50.00 | 50.00
Router/commutateur de réseau | 1.00 | 100.00 | 100.00
 | Sous total ($) |  | 2910.00
Achat de logiciel et services | qte. | prix unitaire | total ($)
Éditeur de texte | 1 | 0 | 0
Open source M.L. API | 1 | 0 | 0
Simulateur de robotique | 1 | 0 | 0
 | sous total ($) |  | 0
Main d'œuvre et ing. | heures | taux horaire | total ($)
Recherche et documentation | 150 | 60 | 9000
Conception | 100 | 60 | 6000
Programmation et implémentation | 370 | 60 | 22200
Tests et améliorations | 100 | 60 | 6000
Fabrication des robots | 25 | 60 | 1500
Total des heures | 745
 | sous total ($) |  | 44700
 | Grand total ($) |  | 47610.00

Sheet: Sheet2
VAN cloud
 | 0 | 1 | 2 | 3 | 4 | 5 | 6 | 7 | 8 | 9 | 10 | 11 | 12 | 13 | 14 | 15 | 16 | 17 | 18 | 19 | 20 | 21 | 22 | 23 | 24 | 25 | 26 | 27 | 28 | 29 | 30 | 31 | 32 | 33 | 34 | 35 | 36 | 37 | 38 | 39 | 40 | 41 | 42 | 43 | 44 | 45 | 46 | 47 | 48
 | -8730.97 | -130 | -130 | -130 | -130 | -130 | -130 | -130 | -130 | -130 | -130 | -130 | -130 | -130 | -130 | -130 | -130 | -130 | -130 | -130 | -130 | -130 | -130 | -130 | -130 | -130 | -130 | -130 | -130 | -130 | -130 | -130 | -130 | -130 | -130 | -130 | -130 | -130 | -130 | -130 | -130 | -130 | -130 | -130 | -130 | -130 | -130 | -130 | -130
 | 1650.00
VAN | -$8730.97
 | -$8730.97
