squidlydeadly/projet-5-credits/CAD_and_drawing/fabriquation piece.xlsx

Sheet: impression
impression pieces
part No. | des. | note | color | qte. | état
corner | a chaque coins | layer 0.3 , mat ABS | blk | 4 | fabriqué
camera_holder | au dessus au centre | layer 0.3 , mat ABS | blk | 1 | à imprimer
ball_end | au bout des tige | layer 0.3 , mat ABS | blk | 8 | fabriqué
plank_end | au bout des planche | layer 0.3 , mat ABS | blk | 8 | fabriqué
5-16_TO5-16_adapt | entre les goujon | layer 0.3 , mat ABS | blk | 4 | Standby
1-4_TO5-16_adapt | entre les goujon | layer 0.3 , mat ABS | blk | 8 | Standby
Goal | but du terrain | carbon fiber | blk | 4 | a imprimer
BALL_END_5_16 | à chaque coin | layer 0.3, mat ABS | blk | 8 | à imprimer

Sheet: decoupe
decoupe pieces bois
part No. | des. | note | color | qte. | etat
plaque 1 | planche en longueur | mat bois contreplaqué 3/4 40mm X 1535mm |  | 2 | fabrique
paque 2 | planche en largeur | mat bois contreplaqué 3/4 40mm X 340mm |  | 4 | fabrique
tige | tige au 4 coins en deux section 8 goujont | mat bois tige 1/4 long 1445mm aprox, essaiyé au plus long et reduire selon la camera |  | 8 | a decoupé au bonne longue
