squidlydeadly/projet-5-credits/Documents/Estimations/Coût2.xlsx

concepte |  |  |  | préliminaire
Achat de materiel | Qte. | Prix/unit | Prix | Achat de materiel | Qte. | Prix/unit | Prix
Robots |  |  |  | Robots
Platforme robotique | 4 | 40.00 | 160.00 | Platforme robotique | 4 | 27.00 | 108.00
Camera | 1 | 150.00 | 150.00 | Camera ELP 2.1 mm | 1 | 68.00 | 68.00
 |  |  |  | PCB | 10 | 10.00 | 100.00
Pont en H | 4 | 5.00 | 20.00 | L298N motor Drive | 5 | 5.07 | 25.37
autre capteur vision | 1 | 100.00 | 100.00
Systeme de manutention de la balle | 4 | 40.00 | 160.00 | Systeme de manutention de la balle
 |  |  |  | Vis et écrous m2.5 mm | 1 | 16.10 | 16.10
 |  |  |  | servomoteurs MG90S | 10 | 4.69 | 46.90
Impression des pièces | 4 | 25.00 | 100.00 | PLA 1.75 mm noir 1 Kg | 1 | 35.65 | 35.65
 |  |  |  | Ensemble breadboards avec cables | 1 | 17.25 | 17.25
Piles Lipo | 4 | 25.00 | 100.00 | Piles Lipo | 4 | 25.00 | 100.00
Autres capteurs | 4 | 40.00 | 160.00
Microcontrolleur ESP32-S2 | 4 | 10.00 | 40.00 | Microcontrolleur ESP32-S2 | 4 | 11.75 | 47.00
 |  |  |  | Microcontrolleur ESP32-WROOM pack 4 | 1 | 43.98 | 43.98
 |  |  |  | Feather NRF52 MCU | 4 | 38.35 | 153.40
Sout-total Robots |  |  | 990.00 | Sout-total Robots |  |  | 761.65
Server local et ses composant | 1 | 1500.00 | 1500.00 | Server local et ses composant
 |  |  |  | Nvidia Jetson Xavier nx | 1 | 524.90 | 524.90
 |  |  |  | SSD samsung evo 970 250 GB | 1 | 91.98 | 91.98
routeur/commutateur | 1 | 100.00 | 100.00 | TP-Link AC1900 | 1 | 115.00 | 115.00
 |  |  |  | Câble connecteur RJ45 | 1 | 10.32 | 10.32
Manettes de controle | 2 | 80.00 | 160.00 | Manette de controle logitech F310 | 2 | 30.11 | 60.22
Sout-total Serveur et composantes |  |  | 1760.00 | Sout-total Serveur et composantes |  |  | 802.42
Terrain | 1 | 200.00 | 200.00 | Terrain
 |  |  |  | Balles de foosball pack 4 | 1 | 10.60 | 10.60
 |  |  |  | tapis de Yoga noir | 1 | 98.90 | 98.90
 |  |  |  | Bois de contour | 10 | 10.00 | 100.00
 |  |  |  | Ensemble d'éclairage | 1 | 100.00 | 100.00
 |  |  |  | Tiges de support pour caméra | 4 | 15.00 | 60.00
 |  |  |  | Valise de transport | 1 | 430.00 | 430.00
Sout-total Terrain |  |  | 200.00 | Sout-total Terrain |  |  | 799.50
Sous-total ($) Matériel |  |  | 2950.00 | Sous-total ($) Matériel |  |  | 2363.57
Achat de logiciel et outil informatique | Qte. | Prix/unit | Prix | Achat de logiciel et outil informatique | Qte. | Prix/unit | Prix
Logiciels | 1 | 0.00 | 0.00 | Logiciels | 1 | 0.00 | 0.00
Open source M.L. API | 1 | 0.00 | 0.00 | Google Colab premium | 2 | 14.00 | 28.00
Simulateur de robotique | 1 | 0.00 | 0.00 | Simulateur de robotique | 1 | 0.00 | 0.00
Sous-total ($) |  |  | 0.00 | Sous-total ($) |  |  | 28.00
Main d'oeuvre et ing. | Qte. | Prix/unit | Prix | Main d'oeuvre et ing. | Qte. | Prix/unit | Prix
Recherche et documentation | 150 | 60.00 | 9000.00 | Recherche et documentation | 150 | 60.00 | 9000.00
Conception | 100 | 60.00 | 6000.00 | Conception | 100 | 60.00 | 6000.00
Programation et implementation | 370 | 60.00 | 22200.00 | Programation et implementation | 370 | 60.00 | 22200.00
Test et amelioration | 100 | 60.00 | 6000.00 | Test et amelioration | 100 | 60.00 | 6000.00
Fabrication des robots | 25 | 60.00 | 1500.00 | Fabrication des robots | 25 | 60.00 | 1500.00
Sous-total des heures ($) |  |  | 44700.00 | Sous-total des heures ($) |  |  | 44700.00
Grand total |  |  | 47650.00 | Grand total |  |  | 47091.57
