squidlydeadly/projet-5-credits/Gestion/Factures/Alexandre Tremblay/facture Alexandre Tremblay.xlsx

Achat | Date | Comerce | Montant ($ CAD) | Statue | facture
Robot et micro controleur | 2020-11-04 | Digi-Key | 277.2 |  | faxture 1 | non remboursé et sans cheque
Télécommande logithec | 2020-12-20 | Bureau en Gros | 30.11 |  |  | non remboursé mais avec cheque
Piece pour Robots, 3D printer fillament, servo | 2021-01-04 | Amazon | 94.71 |  |  | remboursé
Vis et Bread Board | 2021-01-27 | Amazon | 28.98
frais importation Fedex | 2021-01-13 | Fedex | 25.41
esp8266 | 2021-03-05 | Amazon | 34.99
Télécommande logithec #2 | 2021-03-05 | Best Buy | 28.73
goujon bois
PCB | 2021-03-25 | JLCPCB | 31.96
 |  | total | 520.13
