squidlydeadly/projet-5-credits/Gestion/Estimations/Coût - Copy.xlsx

Achat de materiel | Qte. | Prix/unit | Prix
Platforme robotique | 4 | 120.00 | 480.00
Camera | 1 | 100.00 | 100.00
Systeme de manutention de la balle | 4 | 40.00 | 160.00
Autre capteur | 4 | 40.00 | 160.00
Microcontrolleur ESP32 | 4 | 10.00 | 40.00
Server local et ses composant | 1 | 1500.00 | 1500.00
Manette de controlle | 2 | 80.00 | 160.00
Terrain | 1 | 150.00 | 150.00
Sous-total ($) |  |  | 2750.00
Achat de logiciel et outil informatique | Qte. | Prix/unit | Prix
Logiciel d'inteligence artificiel | 1 | 0.00 | 0.00
Logiciel de simulation | 1 | 0.00 | 0.00
Logiciel instlaler sur le serveur | 1 | 0.00 | 0.00
Sous-total ($) |  |  | 0.00
Main d'oeuvre et ing. | Qte. | Prix/unit | Prix
Recherche et documentation | 150 | 60.00 | 9000.00
Conception | 100 | 60.00 | 6000.00
Programation et implementation | 370 | 60.00 | 22200.00
Test et amelioration | 100 | 60.00 | 6000.00
Fabrication des robots | 25 | 60.00 | 1500.00
Sous-total des heures ($) |  |  | 44700.00
Grand total |  |  | 47450.00
