squidlydeadly/projet-5-credits/CAD_and_drawing/ROBOT/Assem1.SLDASM

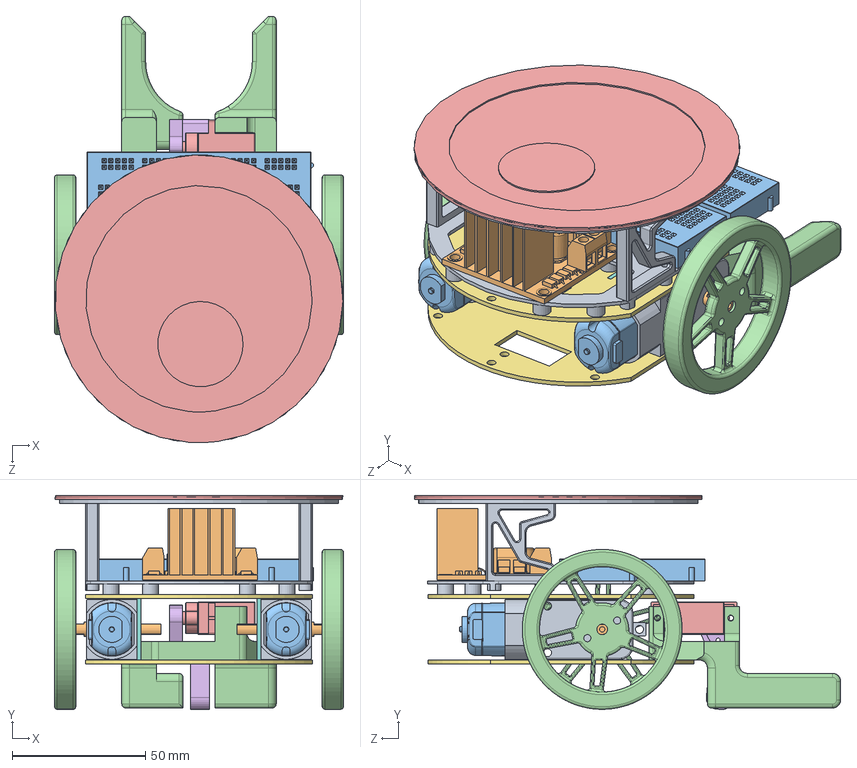
[picture p68: CAD file, 2021-04-10]
CAD_and_drawing/ROBOT/Assem1.SLDASM
108.4 x 80.3 x 160.0 mm
top_1
L298N Stepper Motor Driver (Red)
MiniBreadboard
Kick_manipulator_base
sg90
Kicker
plaque x 2
plaque_mot x 2
Gearbox x 2
output shaft x 2
motor x 2
wheel x 2
FORME_DESSUS
