squidlydeadly/projet-5-credits/CAD_and_drawing/PFE_ASS.SLDASM

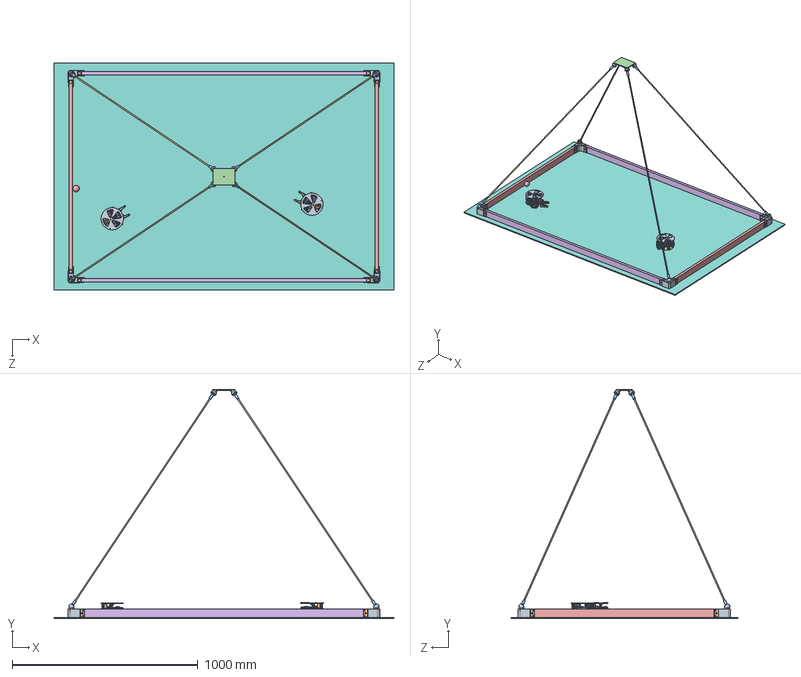
[picture p69: CAD file, 2021-03-08]
CAD_and_drawing/PFE_ASS.SLDASM
1828.8 x 1232.6 x 1219.2 mm
CORNER x 4
PLANK_END x 8
BALL_END x 8
CAMERA_HOLDER
PLANCHE_LARGEUR x 2
PLANCHE_LONGUEUR x 2
TIGE x 4
TAPIS
top_1 x 2
L298N Stepper Motor Driver (Red) x 2
MiniBreadboard x 2
Kick_manipulator_base x 2
sg90 x 2
Kicker x 2
plaque x 4
plaque_mot x 4
Gearbox x 4
output shaft x 4
motor x 4
wheel x 4
ball
