squidlydeadly/projet-5-credits/CAD_and_drawing/TERRAIN/TERRAIN.SLDASM

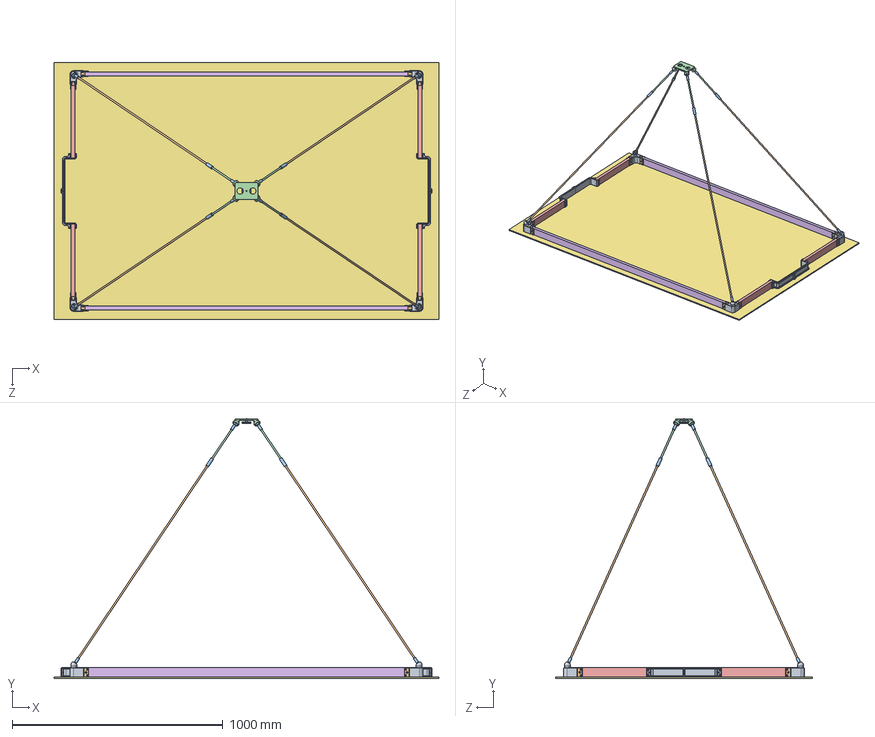
[picture p70: CAD file, 2021-04-09]
CAD_and_drawing/TERRAIN/TERRAIN.SLDASM
1828.8 x 1235.6 x 1219.2 mm
CORNER x 4
PLANK_END x 8
BALL_END x 8
CAMERA_HOLDER
PLANCHE_LARGEUR x 4
PLANCHE_LONGUEUR x 2
TAPIS
cam_holder
Goal x 2
goujont_5-16 x 4
5-16_TO_5-16-adapt x 4
goujont_5-16_court x 4
