squidlydeadly/projet-5-credits/CAD_and_drawing/ROBOT/Kick_manipulator.SLDASM

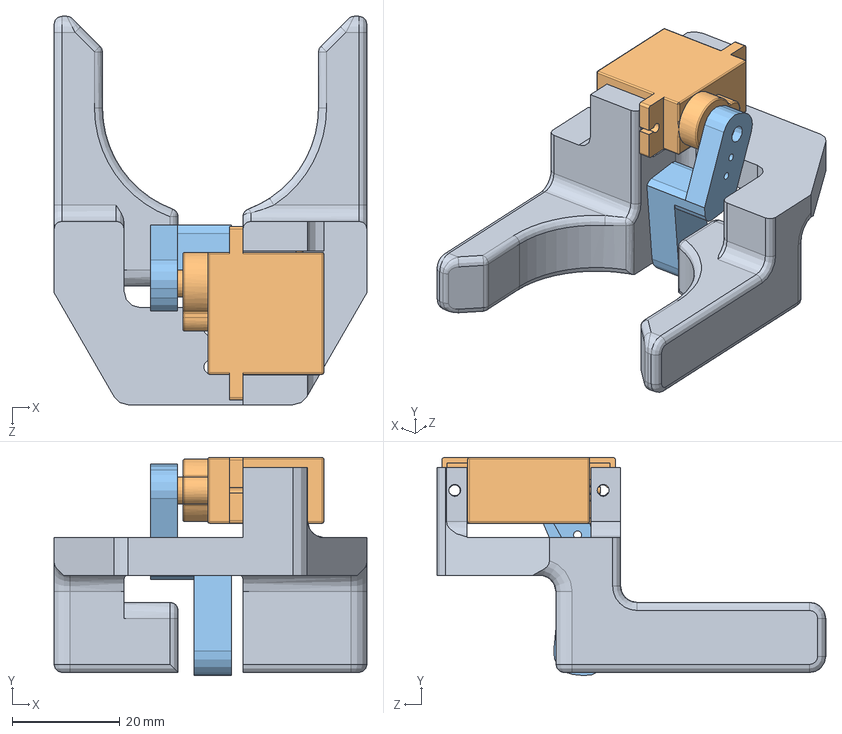
[picture p71: CAD file, 2021-03-17]
CAD_and_drawing/ROBOT/Kick_manipulator.SLDASM
58.0 x 40.4 x 72.0 mm
Kick_manipulator_base
sg90
Kicker
