squidlydeadly/projet-5-credits/CAD_and_drawing/ball.SLDPRT

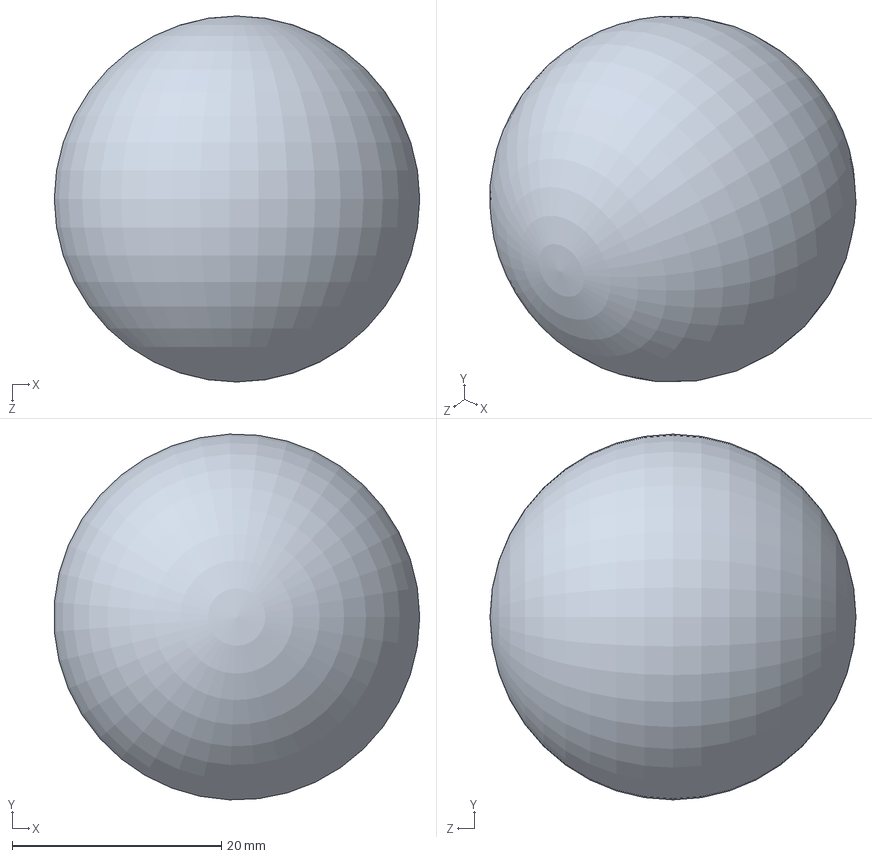
[picture p72: CAD file, 2021-03-08]
CAD_and_drawing/ball.SLDPRT
34.9 x 35.0 x 35.0 mm
