squidlydeadly/projet-5-credits/CAD_and_drawing/TERRAIN/PLANCHE_LONGUEUR.SLDPRT

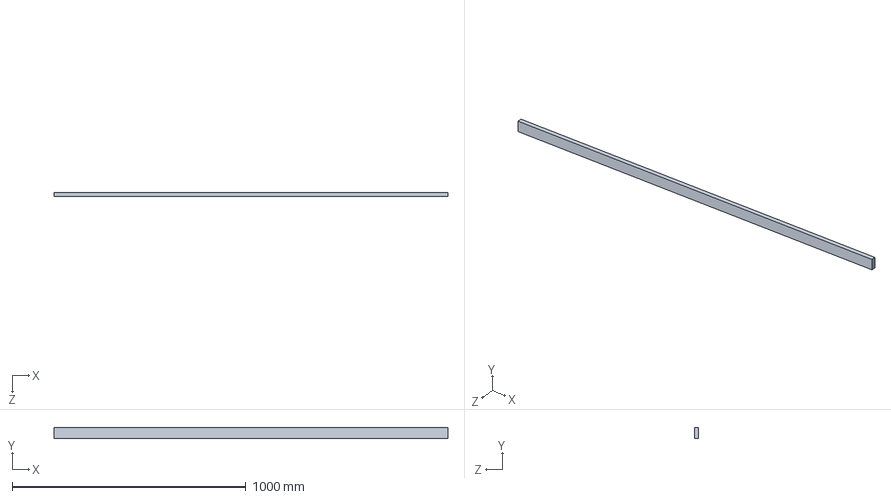
[picture p73: CAD file, 2021-04-09]
CAD_and_drawing/TERRAIN/PLANCHE_LONGUEUR.SLDPRT
1686.3 x 45.0 x 19.0 mm
