squidlydeadly/projet-5-credits/CAD_and_drawing/TERRAIN/STL/BALL_END_5_16.STL

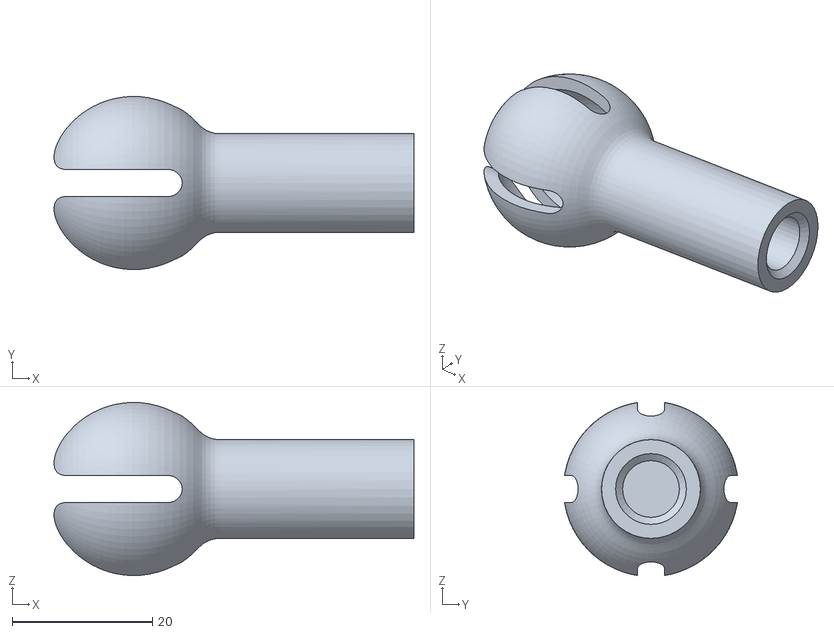
[picture p74: CAD file, 2021-03-19]
CAD_and_drawing/TERRAIN/STL/BALL_END_5_16.STL
51.4 x 24.7 x 24.7
