squidlydeadly/projet-5-credits/CAD_and_drawing/ROBOT/top_1.SLDPRT

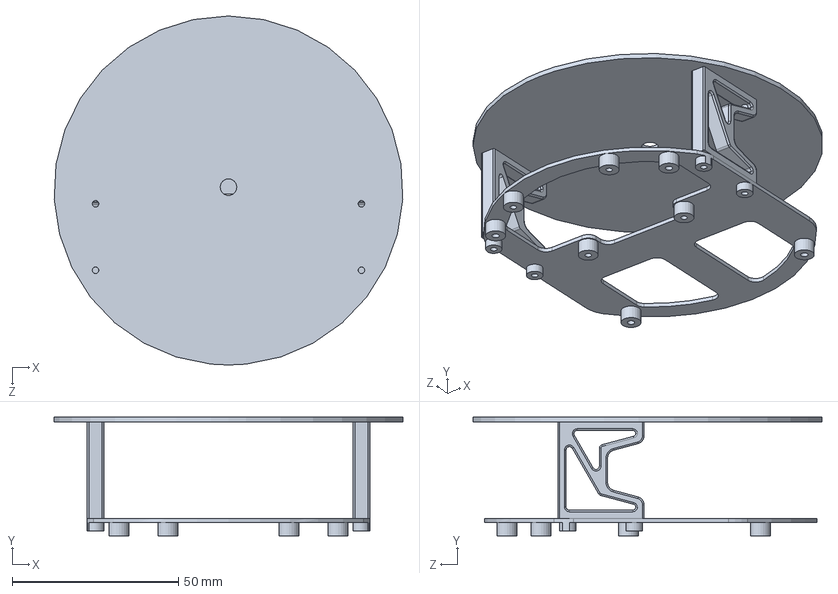
[picture p75: CAD file, 2021-04-09]
CAD_and_drawing/ROBOT/top_1.SLDPRT
104.9 x 35.8 x 105.0 mm
