squidlydeadly/projet-5-credits/CAD_and_drawing/TERRAIN/PLANCHE_LARGEUR.SLDPRT

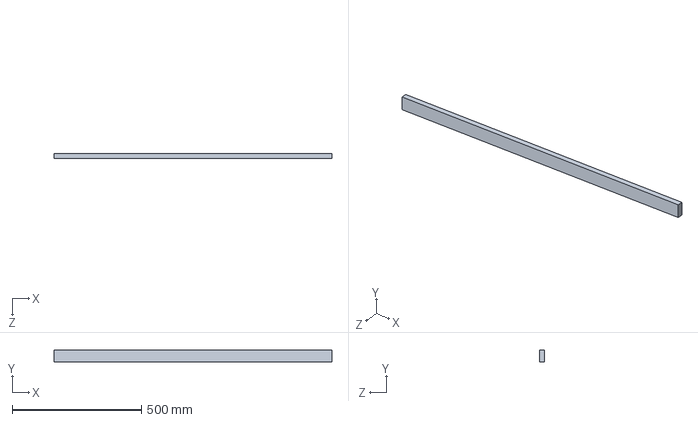
[picture p76: CAD file, 2021-04-09]
CAD_and_drawing/TERRAIN/PLANCHE_LARGEUR.SLDPRT
1076.7 x 45.0 x 19.0 mm
