squidlydeadly/projet-5-credits/CAD_and_drawing/Kick_manipulator_base.STL

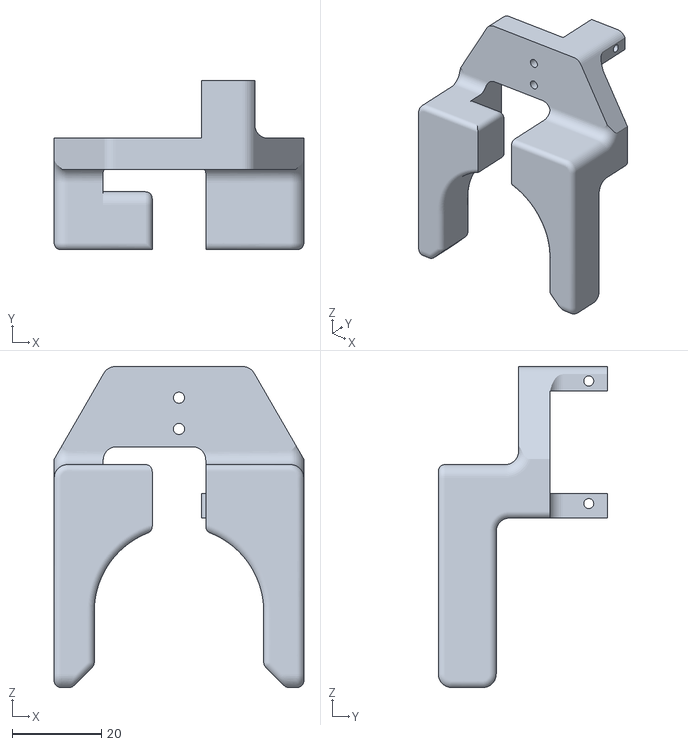
[picture p77: CAD file, 2021-01-28]
CAD_and_drawing/Kick_manipulator_base.STL
56.0 x 38.0 x 72.0
