squidlydeadly/projet-5-credits/CAD_and_drawing/ROBOT/FORME_DESSUS.SLDPRT

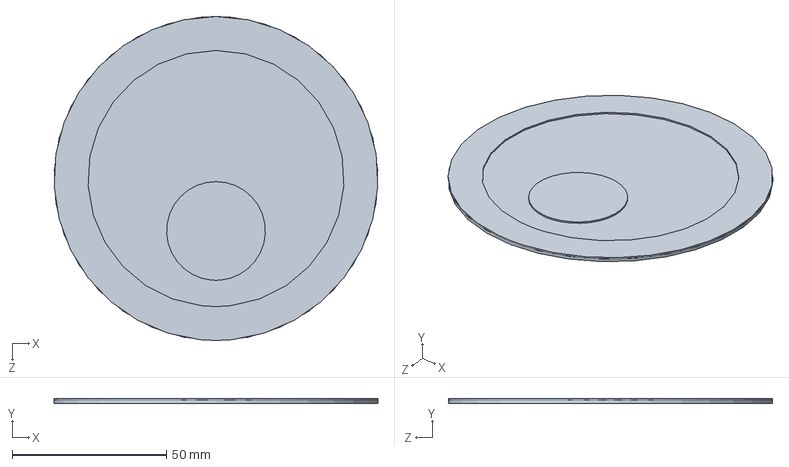
[picture p78: CAD file, 2021-04-09]
CAD_and_drawing/ROBOT/FORME_DESSUS.SLDPRT
104.9 x 1.50 x 105.0 mm
