squidlydeadly/projet-5-credits/CAD_and_drawing/ROBOT/top_backlight.SLDPRT

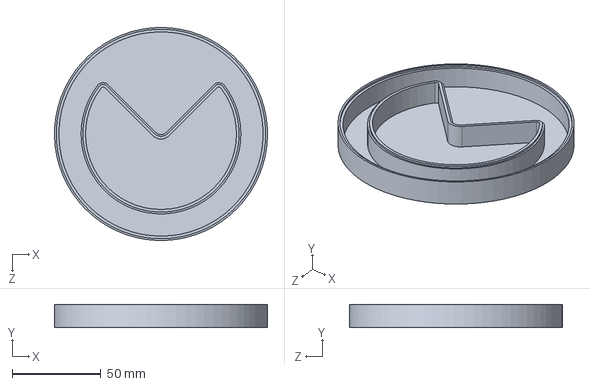
[picture p79: CAD file, 2021-03-21]
CAD_and_drawing/ROBOT/top_backlight.SLDPRT
120.0 x 13.0 x 120.0 mm
