squidlydeadly/projet-5-credits/CAD_and_drawing/TERRAIN/goujont_5-16_court.SLDPRT

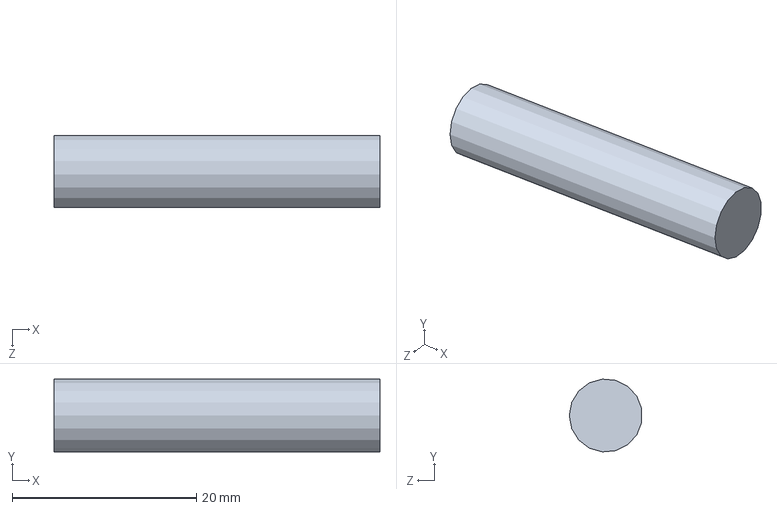
[picture p80: CAD file, 2021-03-28]
CAD_and_drawing/TERRAIN/goujont_5-16_court.SLDPRT
35.4 x 7.90 x 7.87 mm
