squidlydeadly/projet-5-credits/CAD_and_drawing/ROBOT/Gearbox.SLDPRT

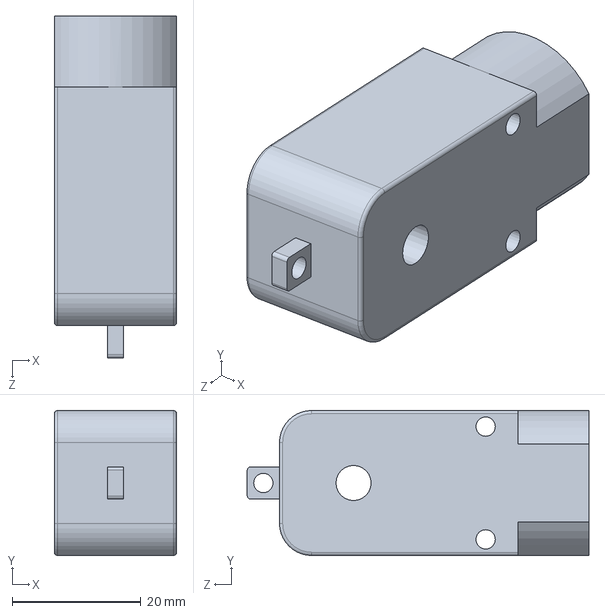
[picture p81: CAD file, 2021-03-17]
CAD_and_drawing/ROBOT/Gearbox.SLDPRT
19.0 x 22.5 x 53.0 mm
