squidlydeadly/projet-5-credits/CAD_and_drawing/TERRAIN/goujont_5-16.SLDPRT

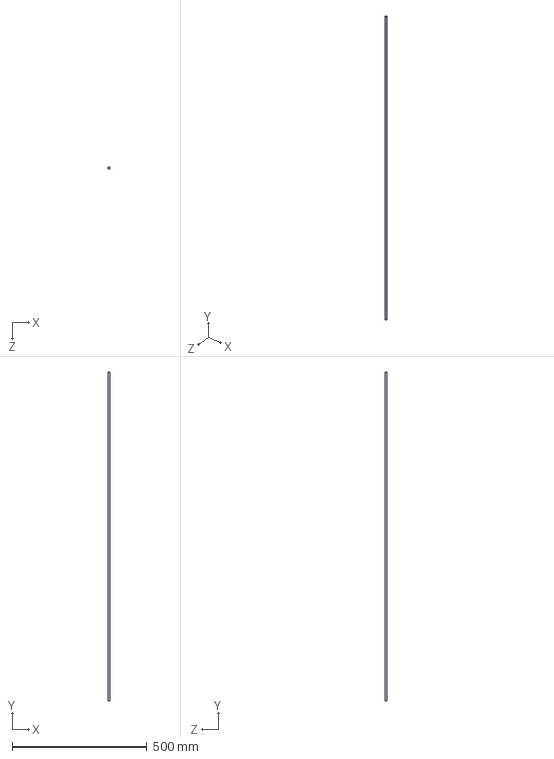
[picture p82: CAD file, 2021-03-28]
CAD_and_drawing/TERRAIN/goujont_5-16.SLDPRT
7.94 x 1219.2 x 7.94 mm
