squidlydeadly/projet-5-credits/CAD_and_drawing/ROBOT/output shaft.SLDPRT

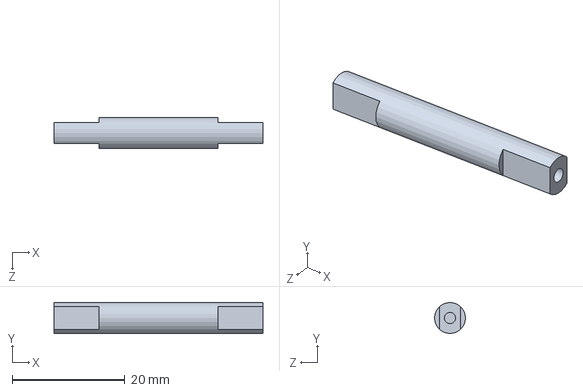
[picture p83: CAD file, 2021-03-17]
CAD_and_drawing/ROBOT/output shaft.SLDPRT
37.0 x 5.50 x 5.50 mm
