squidlydeadly/projet-5-credits/CAD_and_drawing/ROBOT/sg90.SLDPRT

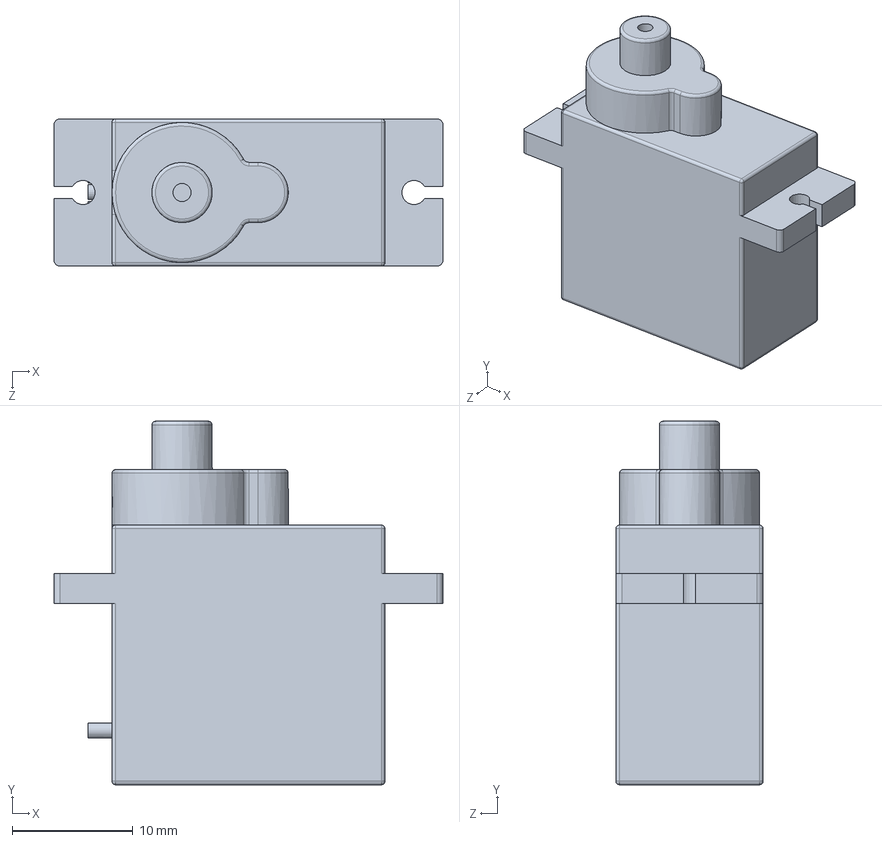
[picture p84: CAD file, 2021-03-17]
CAD_and_drawing/ROBOT/sg90.SLDPRT
32.2 x 30.1 x 12.2 mm
