squidlydeadly/projet-5-credits/CAD_and_drawing/TERRAIN/PLANK_END.SLDPRT

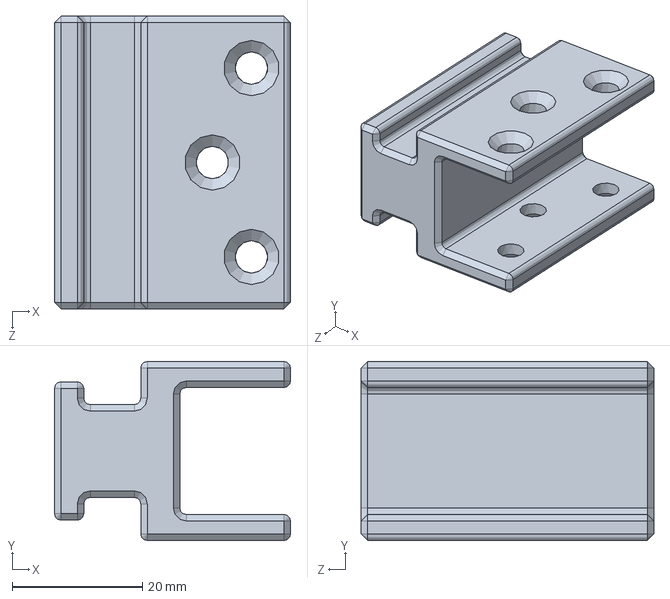
[picture p85: CAD file, 2021-03-19]
CAD_and_drawing/TERRAIN/PLANK_END.SLDPRT
36.2 x 27.5 x 45.0 mm
