squidlydeadly/projet-5-credits/CAD_and_drawing/ROBOT/plaque_mot.SLDPRT

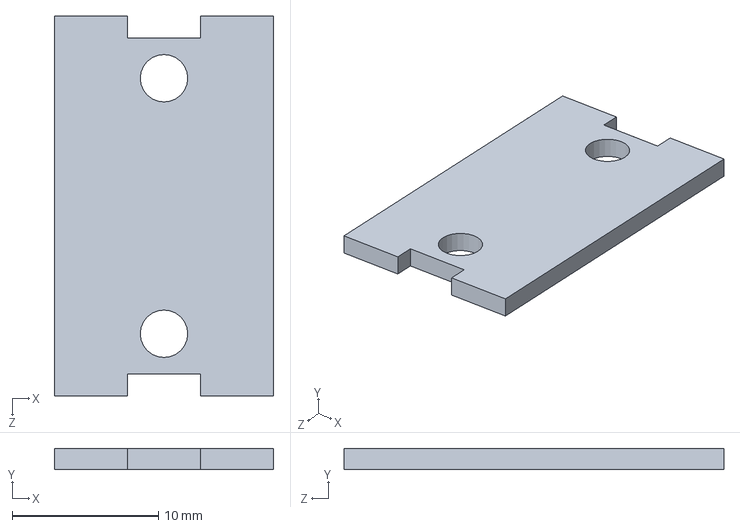
[picture p86: CAD file, 2021-03-17]
CAD_and_drawing/ROBOT/plaque_mot.SLDPRT
15.0 x 1.45 x 26.0 mm
