squidlydeadly/projet-5-credits/CAD_and_drawing/TERRAIN/5-16_TO_5-16-adapt.SLDPRT

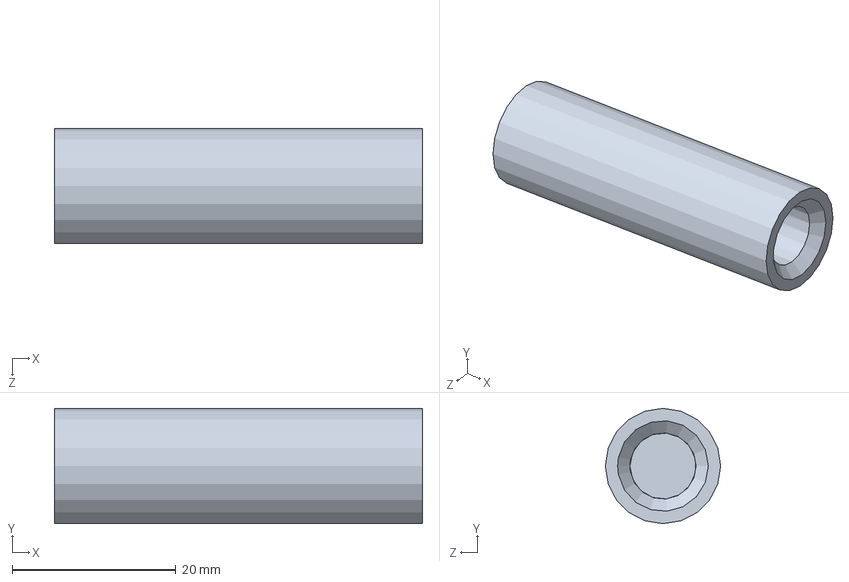
[picture p87: CAD file, 2021-03-19]
CAD_and_drawing/TERRAIN/5-16_TO_5-16-adapt.SLDPRT
45.0 x 14.1 x 14.1 mm
