squidlydeadly/projet-5-credits/CAD_and_drawing/TERRAIN/1-4_TO_5-16-adapt.SLDPRT

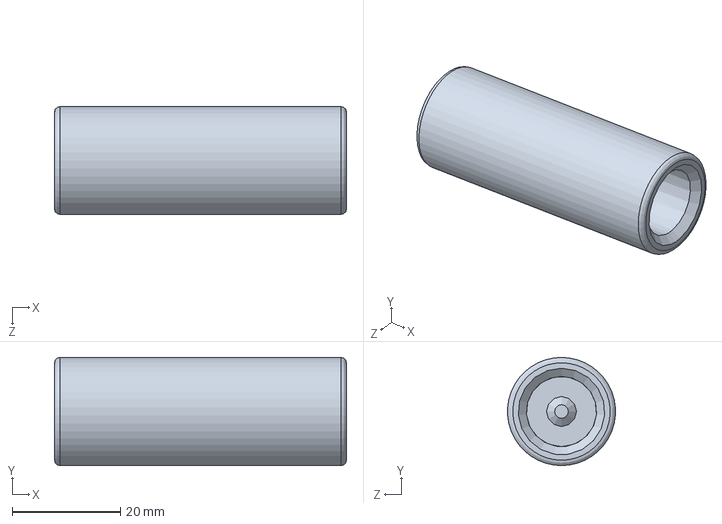
[picture p88: CAD file, 2021-03-19]
CAD_and_drawing/TERRAIN/1-4_TO_5-16-adapt.SLDPRT
54.0 x 20.0 x 19.9 mm
