squidlydeadly/projet-5-credits/CAD_and_drawing/ROBOT/Kick_manipulator_base.SLDPRT

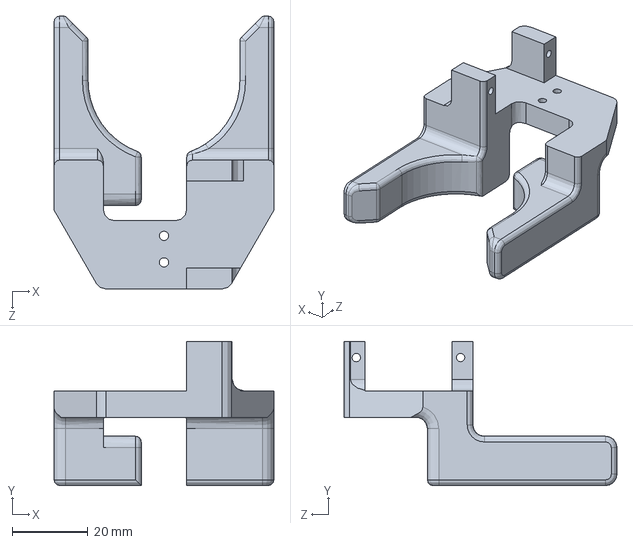
[picture p89: CAD file, 2021-03-07]
CAD_and_drawing/ROBOT/Kick_manipulator_base.SLDPRT
58.0 x 38.0 x 72.0 mm
