squidlydeadly/projet-5-credits/CAD_and_drawing/TERRAIN/cam_holder.SLDPRT

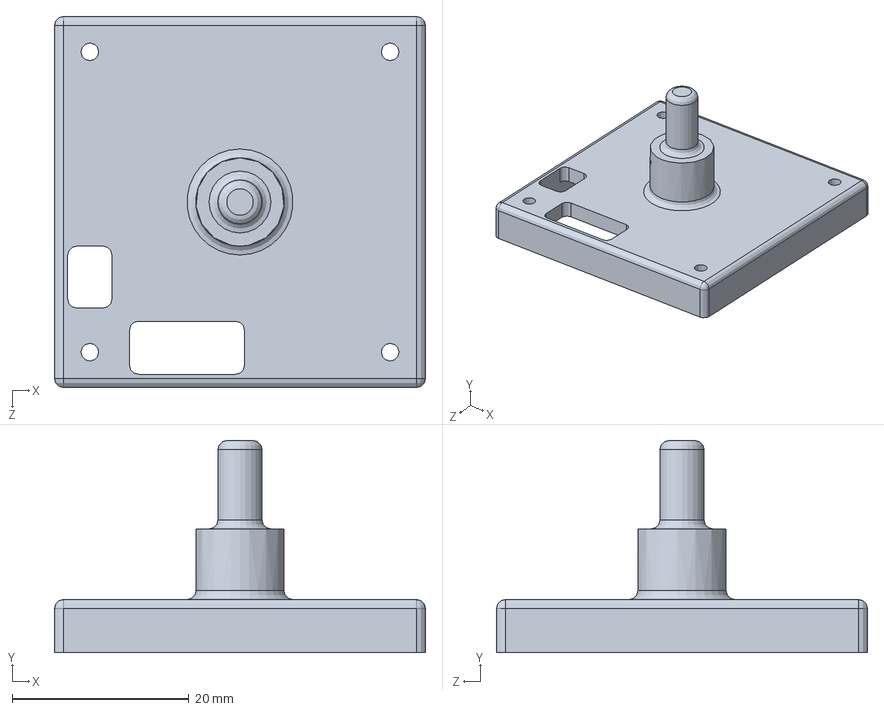
[picture p90: CAD file, 2021-03-19]
CAD_and_drawing/TERRAIN/cam_holder.SLDPRT
42.0 x 24.0 x 42.0 mm
