squidlydeadly/projet-5-credits/CAD_and_drawing/ROBOT/wheel.SLDPRT

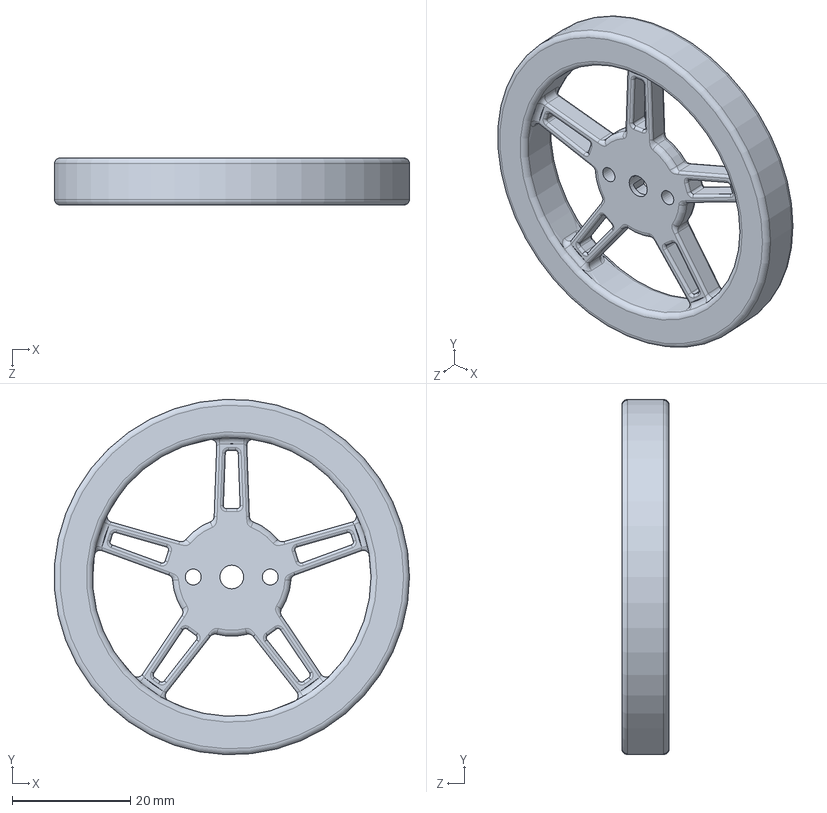
[picture p91: CAD file, 2021-02-19]
CAD_and_drawing/ROBOT/wheel.SLDPRT
59.9 x 60.0 x 8.00 mm
