squidlydeadly/projet-5-credits/CAD_and_drawing/TERRAIN/Goal.SLDPRT

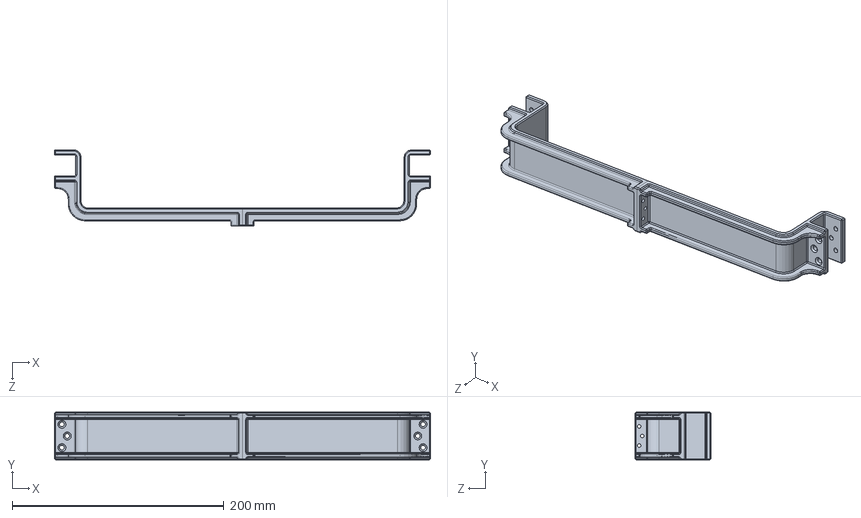
[picture p92: CAD file, 2021-03-19]
CAD_and_drawing/TERRAIN/Goal.SLDPRT
354.8 x 45.0 x 72.0 mm
