squidlydeadly/projet-5-credits/CAD_and_drawing/ROBOT/plaque.SLDPRT

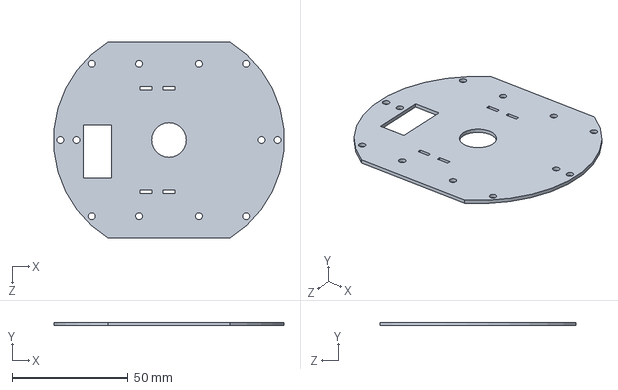
[picture p93: CAD file, 2021-02-19]
CAD_and_drawing/ROBOT/plaque.SLDPRT
99.6 x 1.50 x 85.0 mm
