squidlydeadly/projet-5-credits/CAD_and_drawing/TERRAIN/CAMERA_HOLDER.SLDPRT

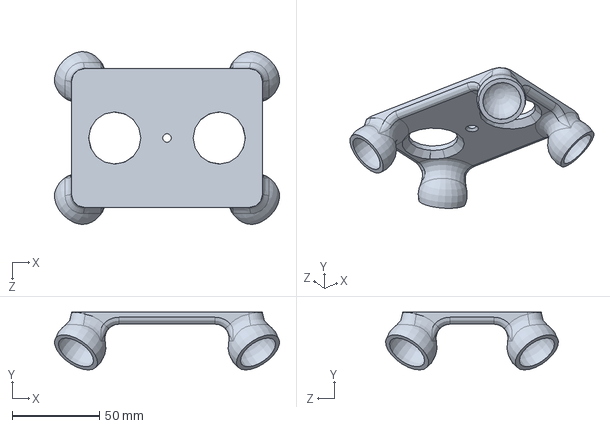
[picture p94: CAD file, 2021-03-18]
CAD_and_drawing/TERRAIN/CAMERA_HOLDER.SLDPRT
129.3 x 33.3 x 99.3 mm
