squidlydeadly/projet-5-credits/CAD_and_drawing/ROBOT/motor.SLDPRT

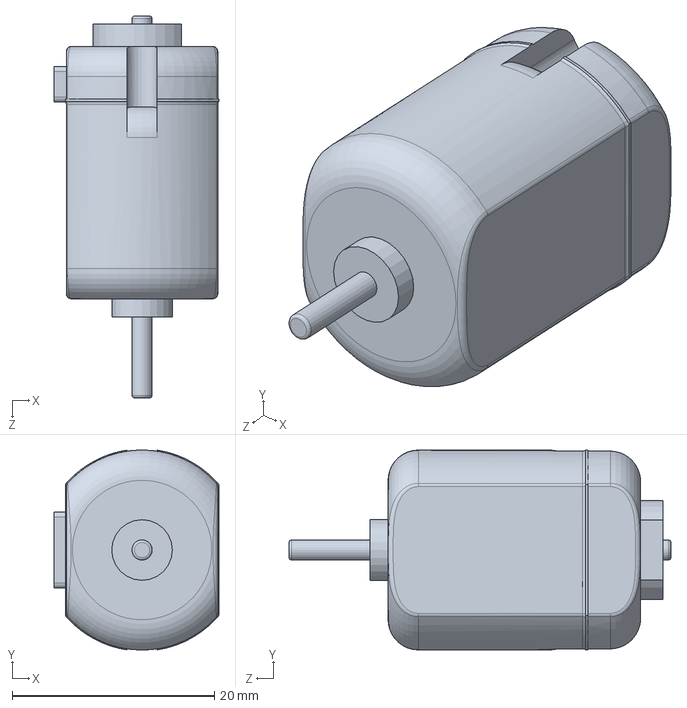
[picture p95: CAD file, 2021-02-19]
CAD_and_drawing/ROBOT/motor.SLDPRT
16.3 x 19.8 x 37.8 mm
