squidlydeadly/projet-5-credits/CAD_and_drawing/TERRAIN/CORNER.SLDPRT

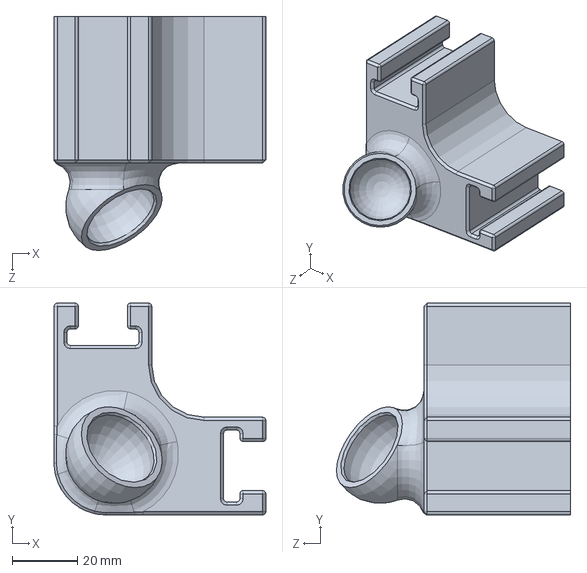
[picture p96: CAD file, 2021-03-13]
CAD_and_drawing/TERRAIN/CORNER.SLDPRT
65.0 x 65.0 x 71.8 mm
