squidlydeadly/projet-5-credits/CAD_and_drawing/ROBOT/DC Motor Gearbox.STEP

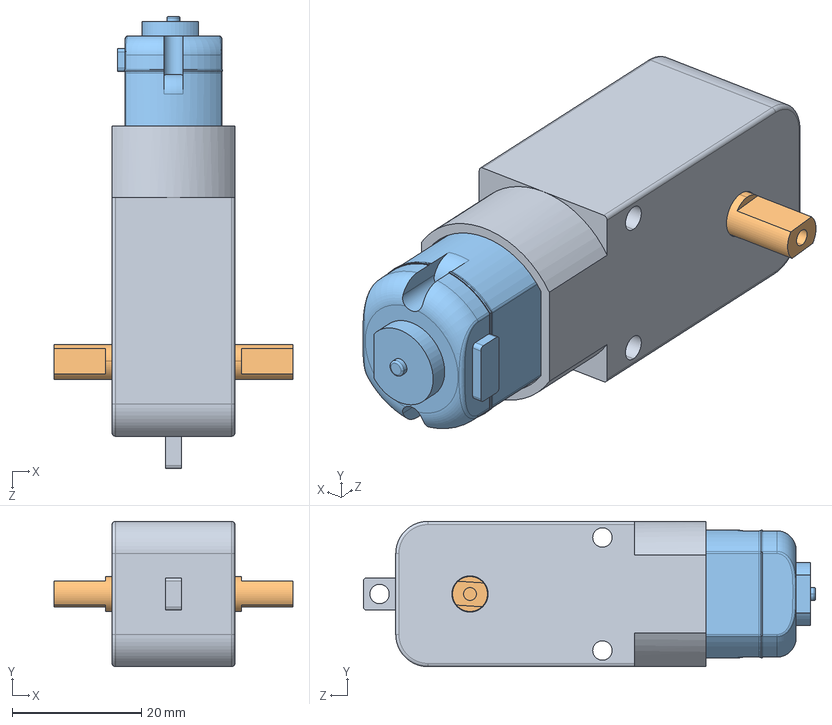
[picture p97: CAD file, 2021-02-19]
CAD_and_drawing/ROBOT/DC Motor Gearbox.STEP
37.0 x 22.5 x 70.0 mm
Gearbox
output shaft
motor
