squidlydeadly/projet-5-credits/CAD_and_drawing/TERRAIN/TIGE.SLDPRT

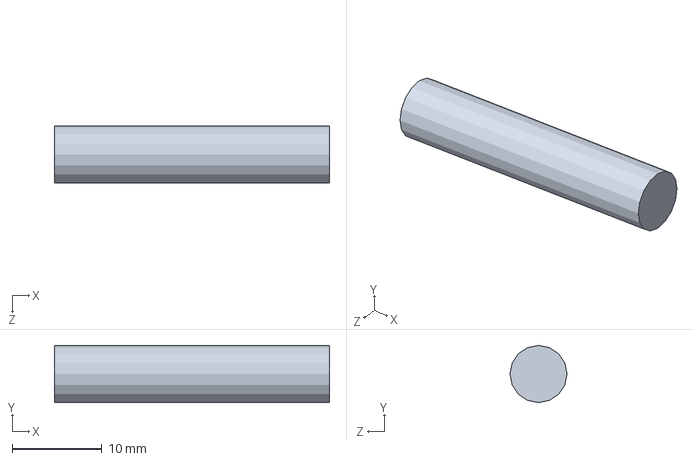
[picture p98: CAD file, 2021-03-10]
CAD_and_drawing/TERRAIN/TIGE.SLDPRT
30.6 x 6.35 x 6.35 mm
