squidlydeadly/projet-5-credits/CAD_and_drawing/ROBOT/Kicker.SLDPRT

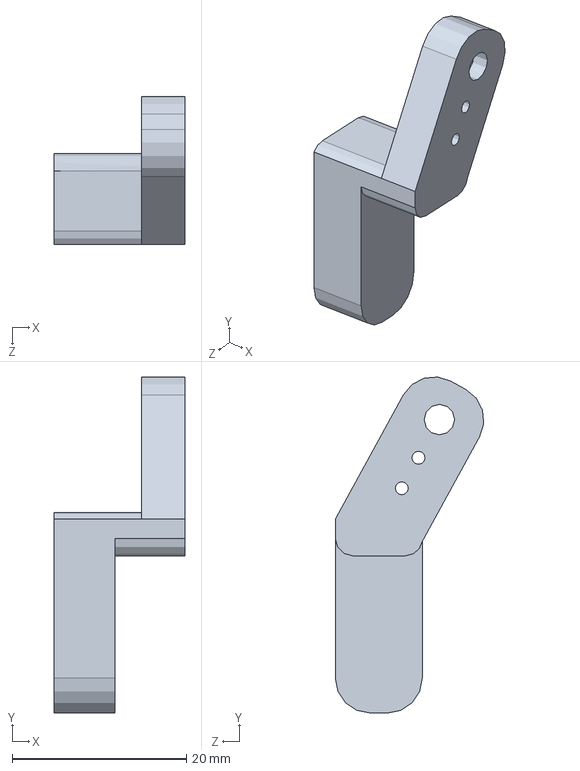
[picture p99: CAD file, 2021-01-28]
CAD_and_drawing/ROBOT/Kicker.SLDPRT
15.0 x 38.6 x 17.1 mm
