squidlydeadly/projet-5-credits/CAD_and_drawing/TERRAIN/ball_fit.SLDPRT

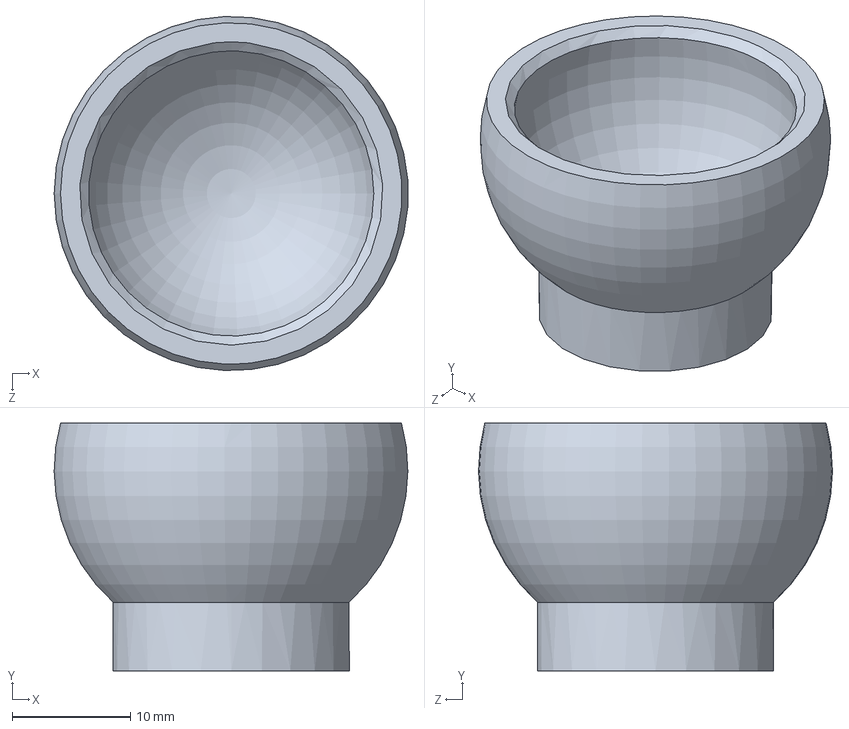
[picture p100: CAD file, 2021-03-08]
CAD_and_drawing/TERRAIN/ball_fit.SLDPRT
30.0 x 21.0 x 30.0 mm
