squidlydeadly/projet-5-credits/CAD_and_drawing/ROBOT/top_1+base.STL

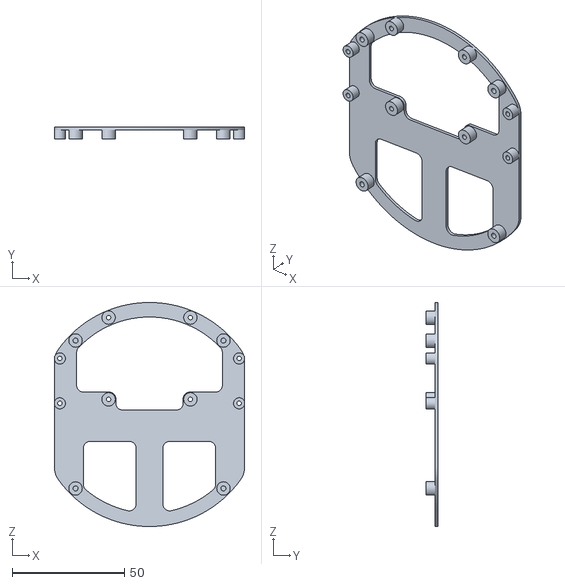
[picture p101: CAD file, 2021-01-28]
CAD_and_drawing/ROBOT/top_1+base.STL
85.0 x 5.25 x 100.0
