squidlydeadly/projet-5-credits/CAD_and_drawing/TERRAIN/TAPIS.SLDPRT

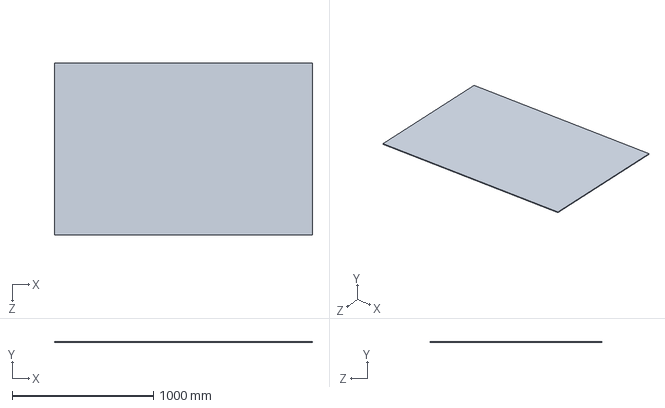
[picture p102: CAD file, 2021-03-04]
CAD_and_drawing/TERRAIN/TAPIS.SLDPRT
1828.8 x 6.35 x 1219.2 mm
