squidlydeadly/projet-5-credits/CAD_and_drawing/ROBOT/MiniBreadboard.SLDPRT

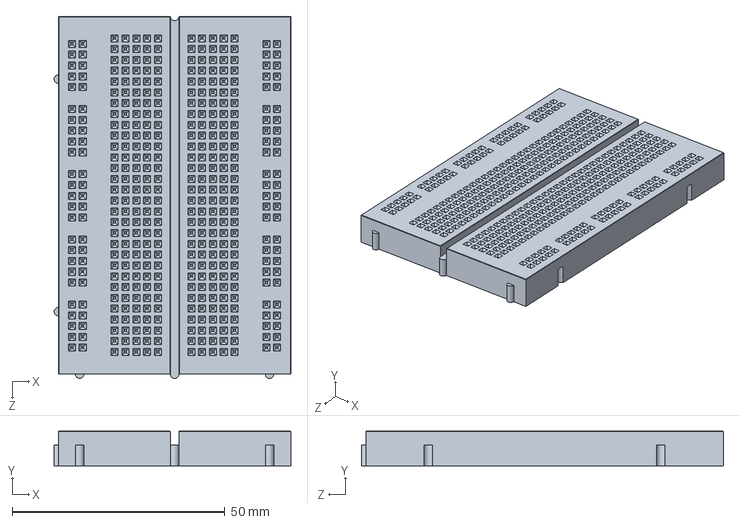
[picture p103: CAD file, 2021-01-25]
CAD_and_drawing/ROBOT/MiniBreadboard.SLDPRT
55.6 x 8.15 x 85.0 mm
