squidlydeadly/projet-5-credits/CAD_and_drawing/ROBOT/L298N Stepper Motor Driver (Red).SLDPRT

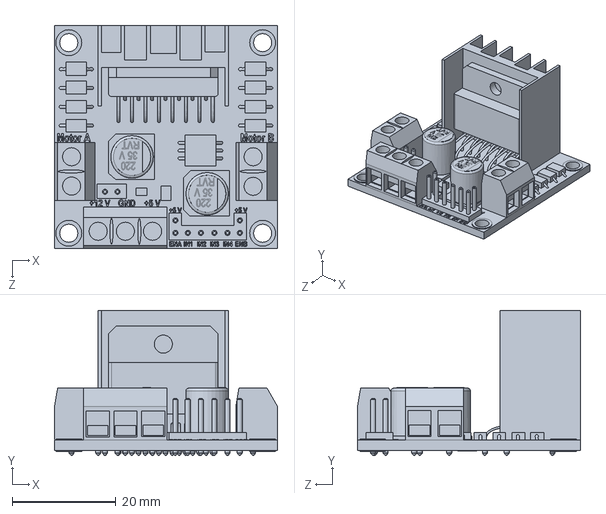
[picture p104: CAD file, 2021-01-21]
CAD_and_drawing/ROBOT/L298N Stepper Motor Driver (Red).SLDPRT
43.0 x 28.0 x 43.0 mm
