squidlydeadly/projet-5-credits/CAD_and_drawing/ROBOT/Static_Ball_manipulator.SLDPRT

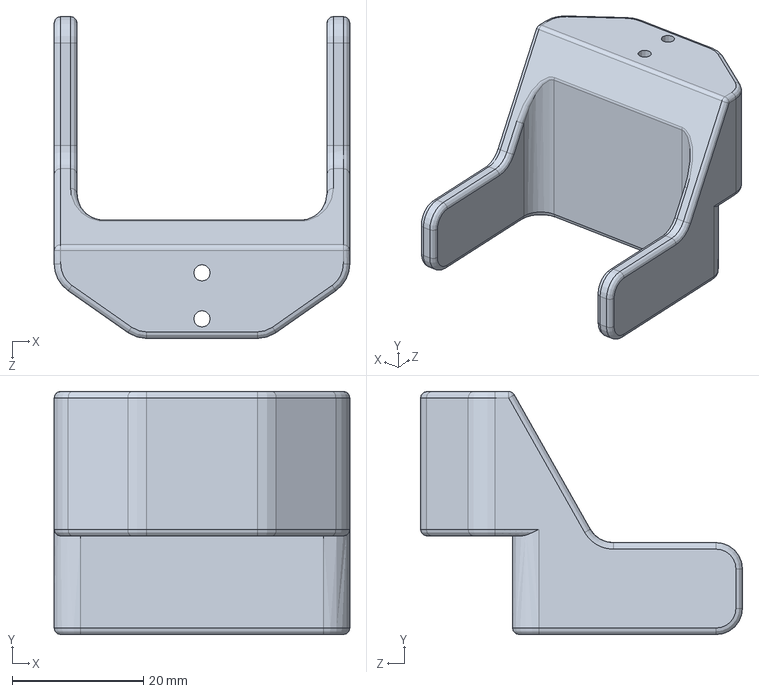
[picture p105: CAD file, 2020-12-30]
CAD_and_drawing/ROBOT/Static_Ball_manipulator.SLDPRT
45.0 x 37.0 x 49.0 mm
