squidlydeadly/projet-5-credits/(list of files, cad)

Other CAD files:
CAD_and_drawing/TERRAIN/BALL_END.SLDPRT
CAD_and_drawing/ROBOT/Assem1.STL
CAD_and_drawing/ROBOT/DC Motor Gearbox.SLDASM
CAD_and_drawing/ROBOT/FORME_DESSUS.SLDDRW
CAD_and_drawing/TERRAIN/STL/1-4_TO_5-16-adapt.STL
CAD_and_drawing/TERRAIN/STL/5-16_TO_5-16-adapt.STL
CAD_and_drawing/TERRAIN/STL/BALL_END.STL
CAD_and_drawing/TERRAIN/STL/CAMERA_HOLDER.STL
CAD_and_drawing/TERRAIN/STL/CORNER.STL
CAD_and_drawing/TERRAIN/STL/Goal.STL
CAD_and_drawing/TERRAIN/STL/PLANK_END.STL
CAD_and_drawing/TERRAIN/STL/cam_holder.STL
CAD_and_drawing/TERRAIN/TERRAIN.SLDDRW
