squidlydeadly/projet-5-credits/CAD_and_drawing/TERRAIN/assemblage terrain.docx

1. Placer le tapis au sol.

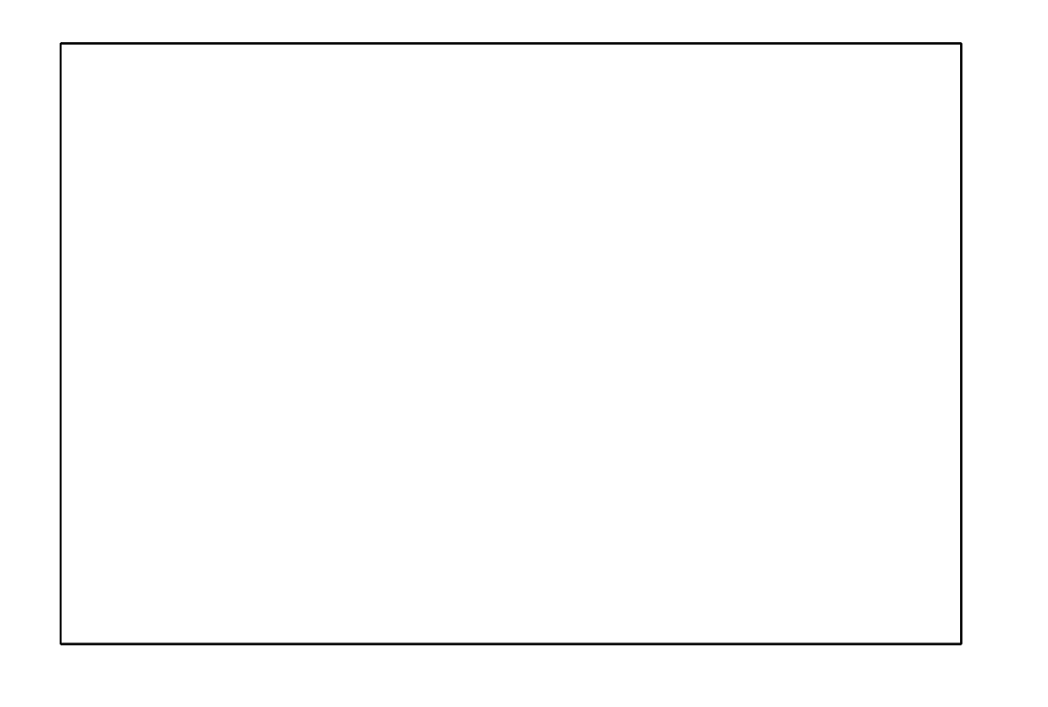
[picture p106: figure]

2. Placer les quatre coins sur le tapis comme le montre la figure suivante.

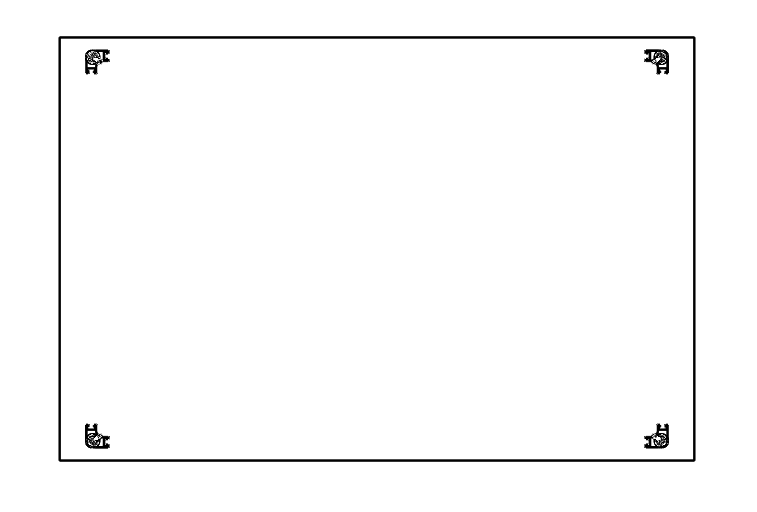
[picture p107: figure]

3. Glisser les montants latéraux en les insérant dans les coins comme le montre les figures suivantes.

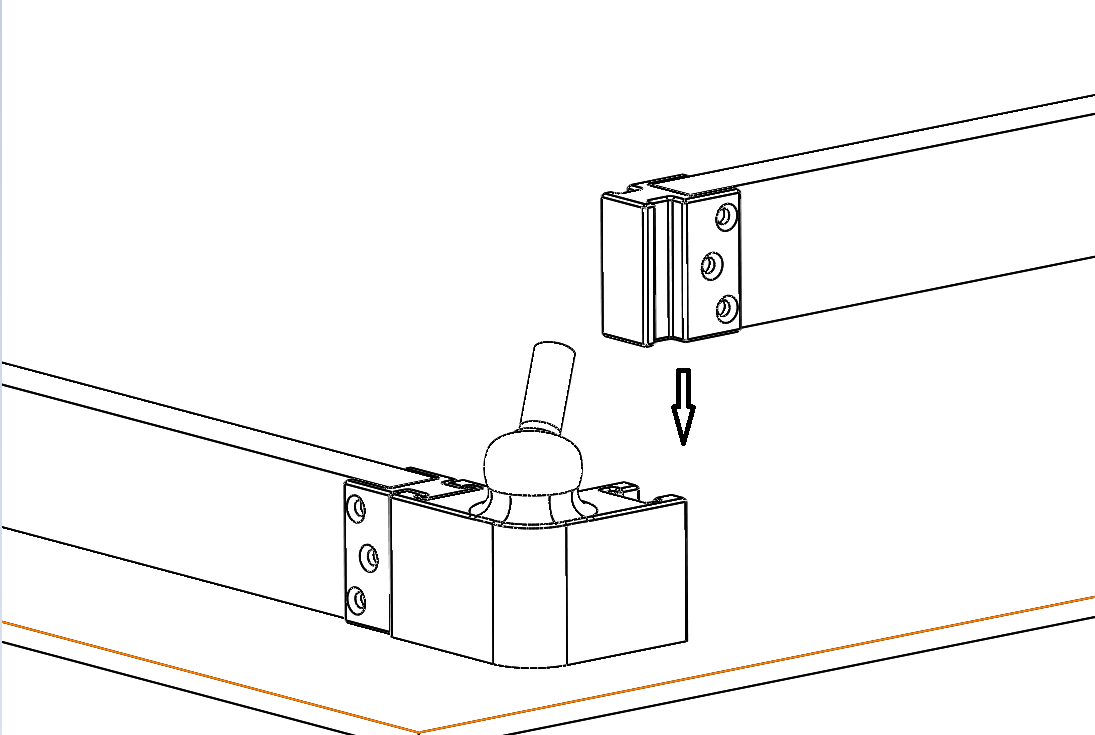
[picture p108: figure]
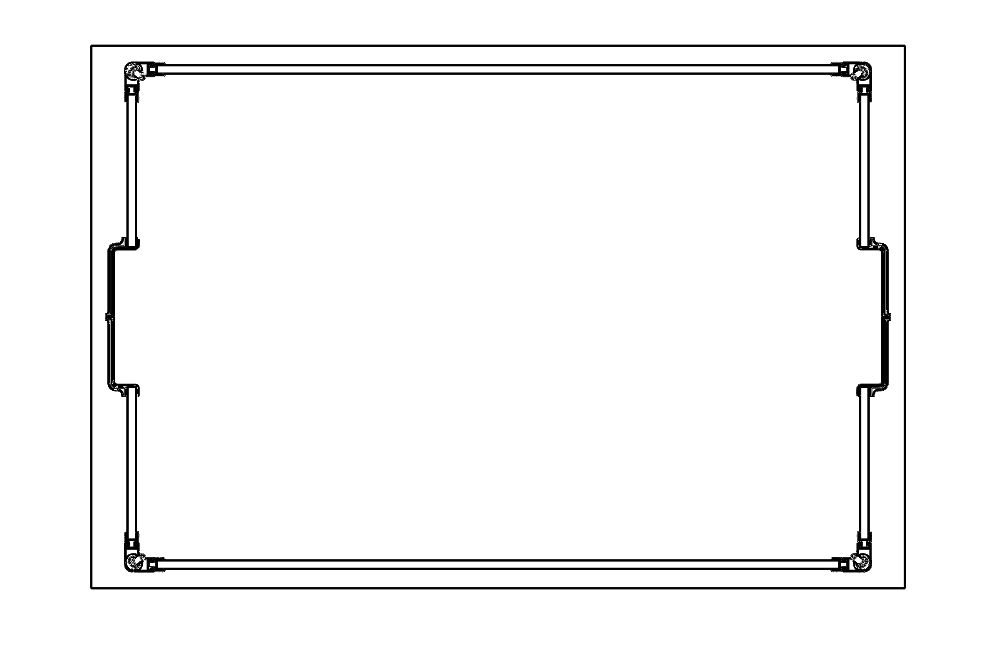
[picture p109: figure]

4. Inséré les goujons dans les coins

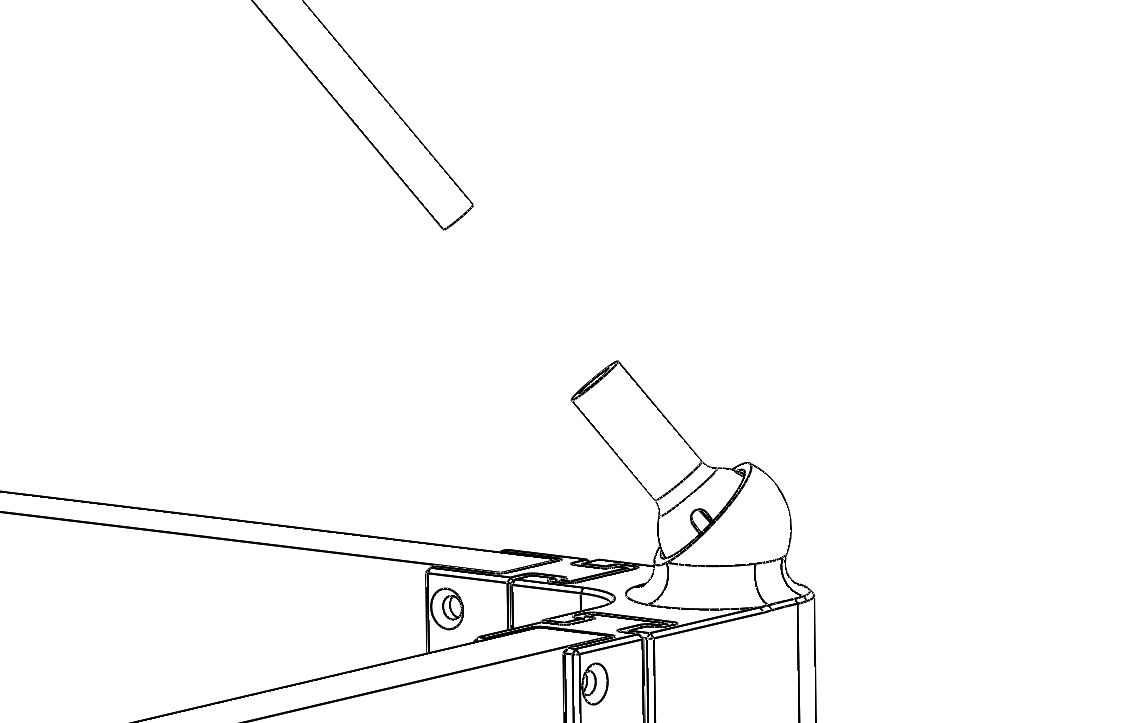
[picture p110: figure]

5. Centre l’autre extrémité des goujons au-dessus du terrain

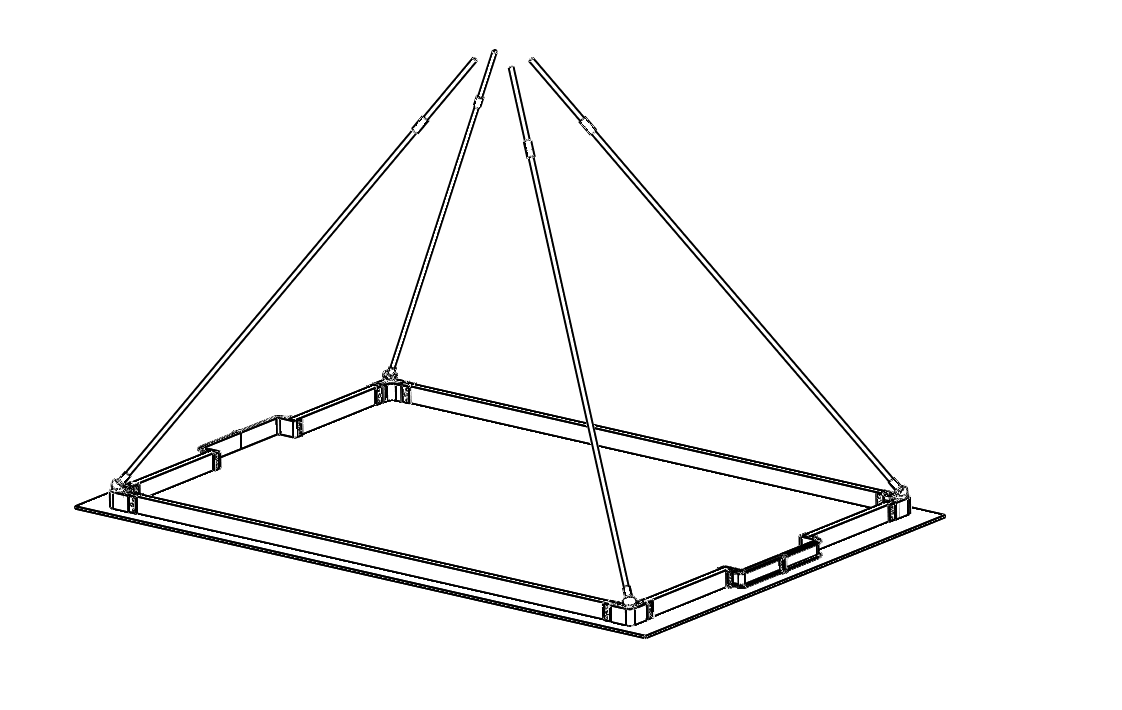
[picture p111: figure]

6. Placer le support a camera sur les quatre goujons au-dessus du terrain.

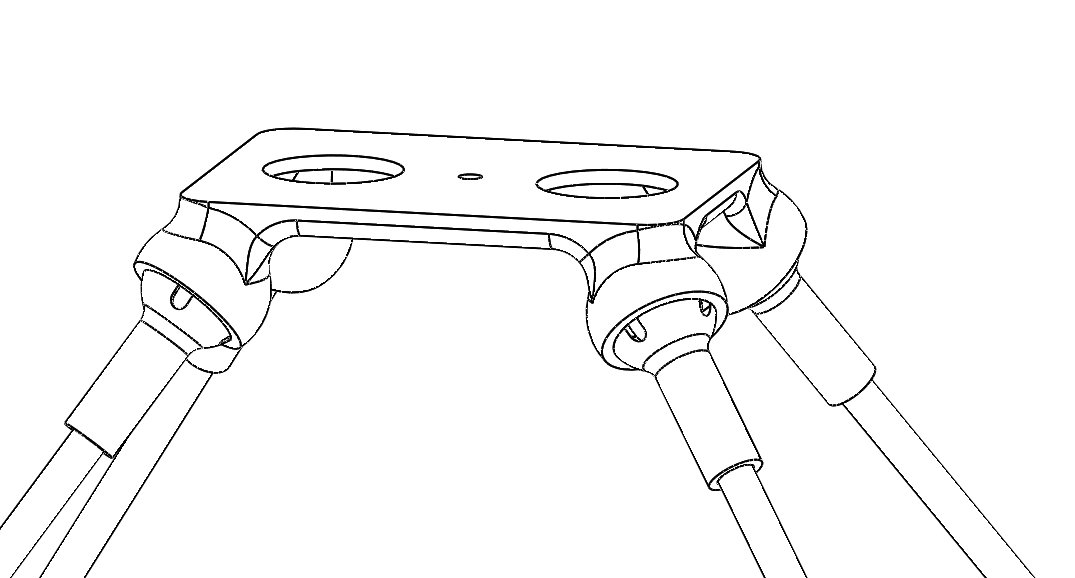
[picture p112: figure]

7. Inséré la caméra dans le support a camera.

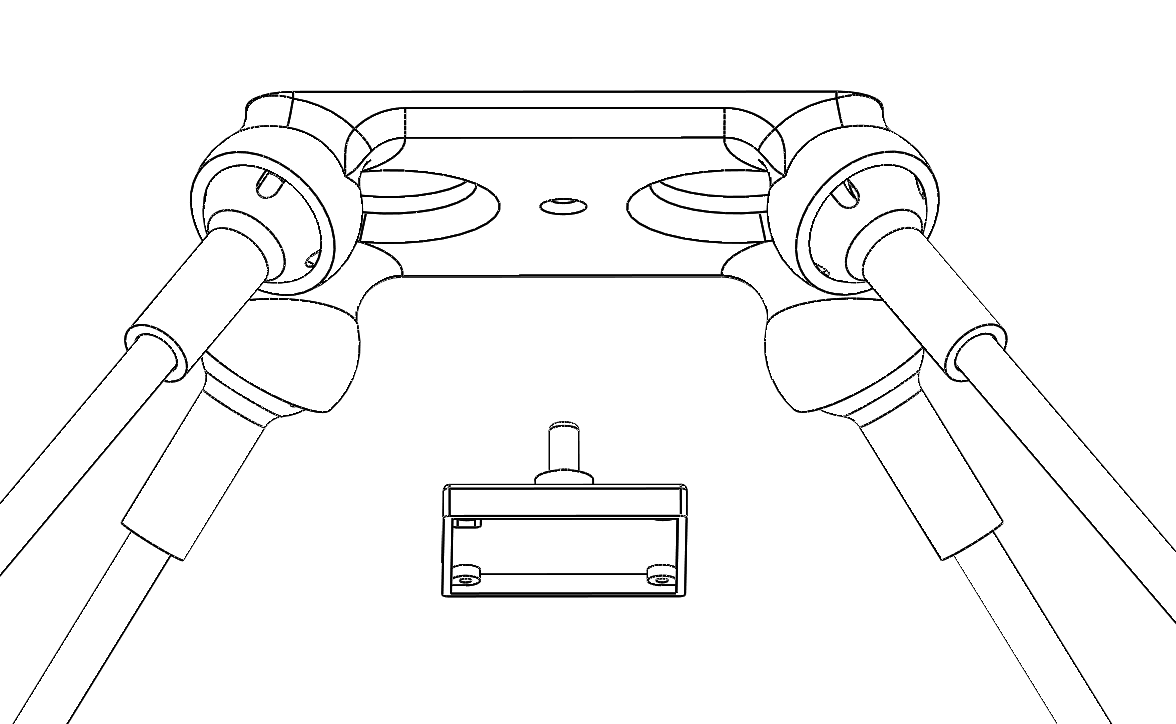
[picture p113: figure]

8. Ajuster la position de la caméra afin de cadre le terrain
