squidlydeadly/projet-5-credits/Code/code_antoine/images/terrain_test.png

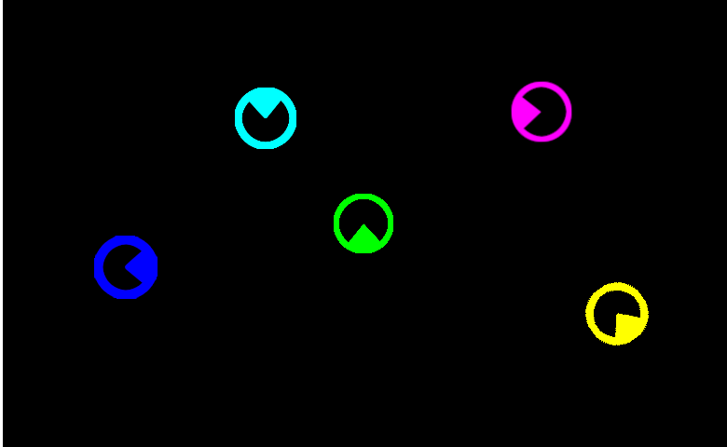
Code/code_antoine/images/terrain_test.png
