squidlydeadly/projet-5-credits/CAD_and_drawing/TERRAIN/TERRAIN.pdf

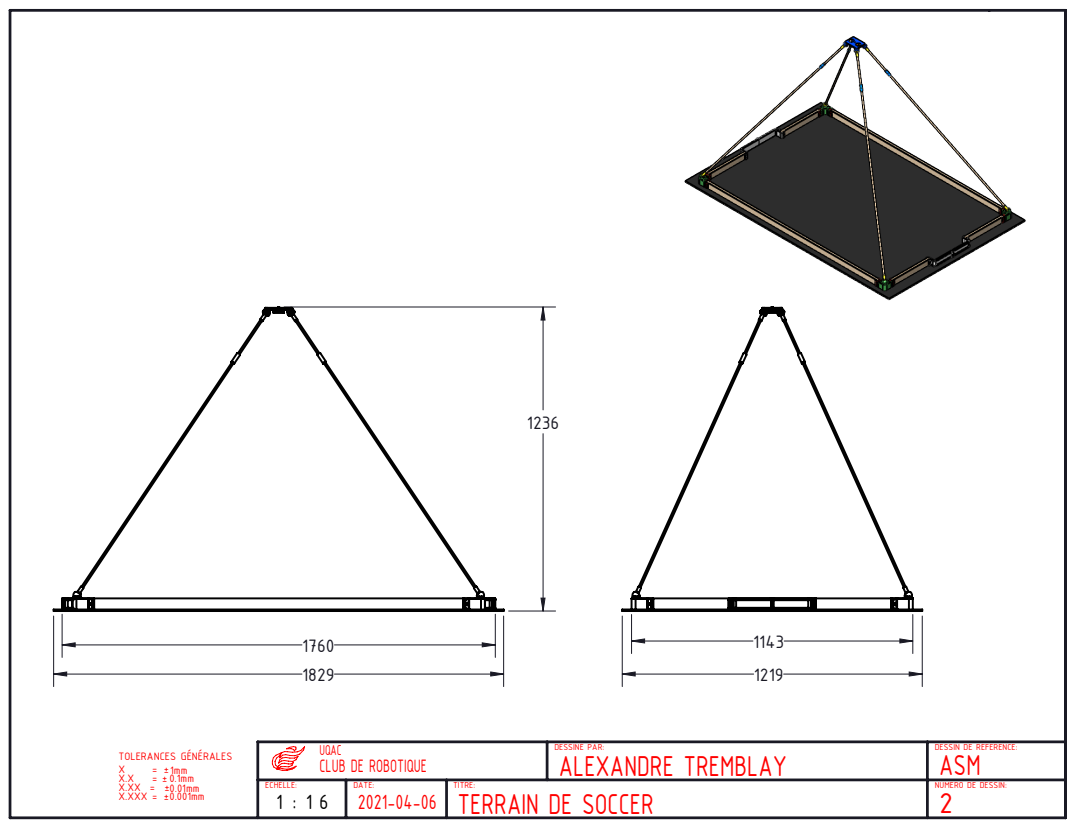
[picture p117: page 1]
TOLERANCES GÉNÉRALES; = ± X.XX = ± X.XXX = ±

UQAC CLUB DE ROBOTIQUE ECHELLE: DATE: TITRE: | DESSINÉ PAR: ALEXANDRE TREMBLAY | DESSIN DE RÉFÉRENCE: ASM
1:16 | 2021-04-06 | TERRAIN DE SOCCER | NUMERO DE DESSIN: 2

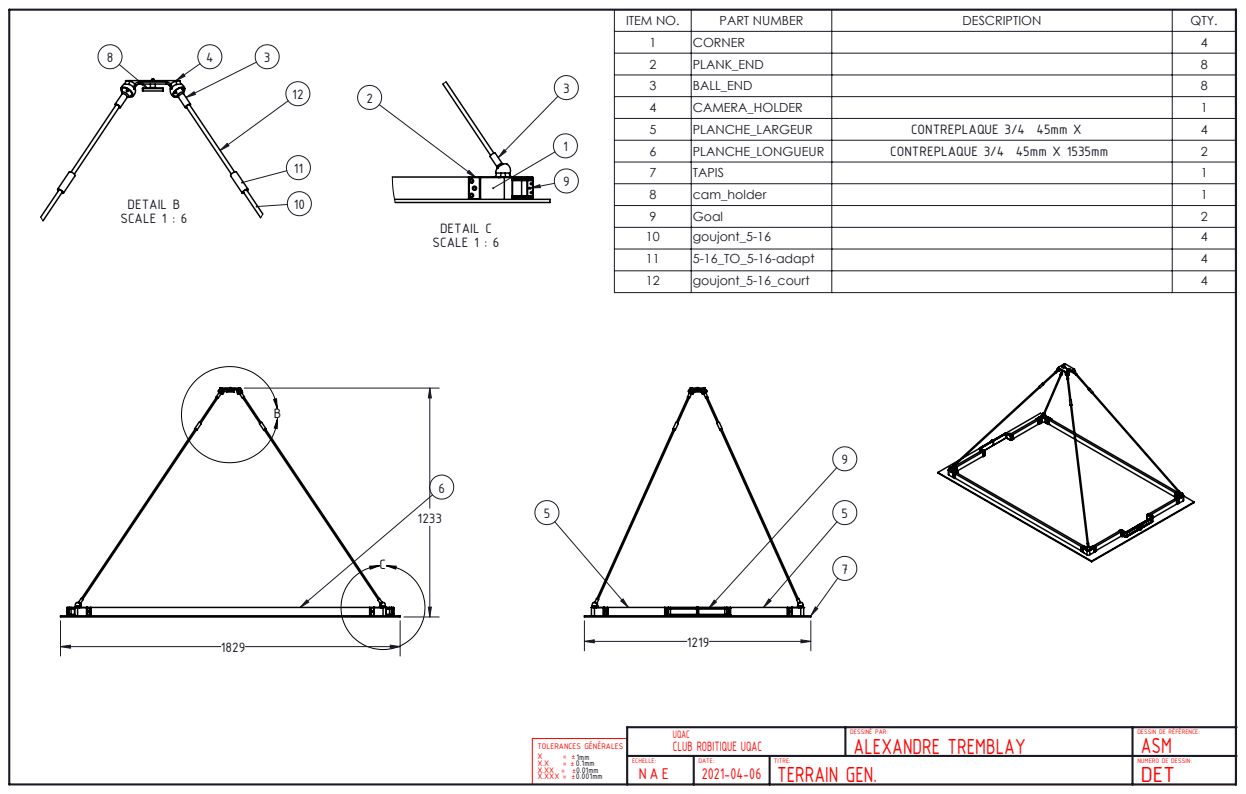
[picture p118: page 2]
TOLERANCES GÉNÉRALES; = ± X.XX = ± X.XXX = ±; DETAIL B SCALE 1 : 6; DETAIL C SCALE 1 : 6

ITEM NO. | PART NUMBER | DESCRIPTION | QTY.
1 | CORNER | | 4
2 | PLANK_END | | 8
3 | BALL_END | | 8
4 | CAMERA_HOLDER | | 1
5 | PLANCHE_LARGEUR | CONTREPLAQUE 3/4 45mm X | 4
6 | PLANCHE_LONGUEUR | CONTREPLAQUE 3/4 45mm X 1535mm | 2
7 | TAPIS | | 1
8 | cam_holder | | 1
9 | Goal | | 2
10 | goujont_5-16 | | 4
11 | 5-16_TO_5-16-adapt | | 4
12 | goujont_5-16_court | | 4

UQAC CLUB ROBITIQUE UQAC | DESSINÉ PAR: ALEXANDRE TREMBLAY | DESSIN DE RÉFÉRENCE: ASM
ECHELLE: NAE | DATE: 2021-04-06 | TITRE: TERRAIN GEN. | NUMERO DE DESSIN: DET
