squidlydeadly/projet-5-credits/PCB/Schematic_pfe_diagram_2021-03-25_09-39-54.pdf

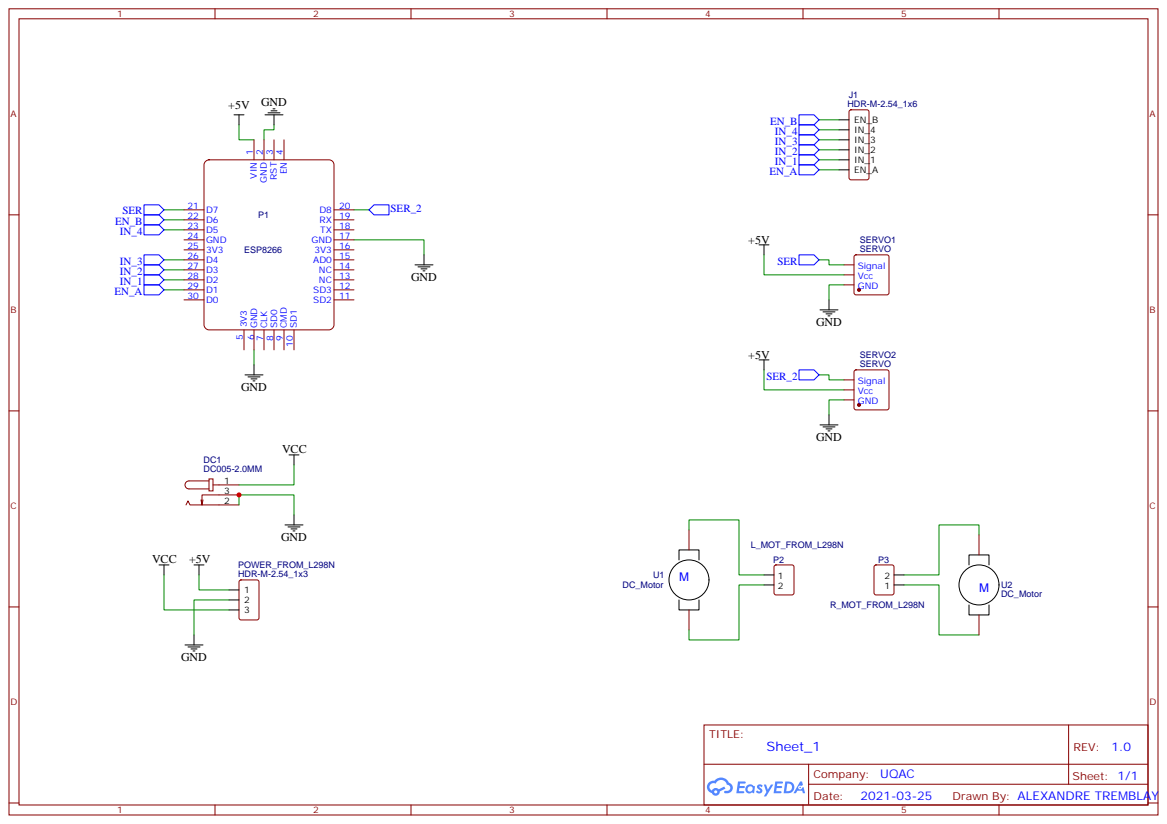
[picture p119: page 1]

Drawn By: ALEXANDRE TREMBLAY
