squidlydeadly/projet-5-credits/PCB/PCB_PCB_2021-03-02_13-19-38_2021-03-25_11-27-58.pdf

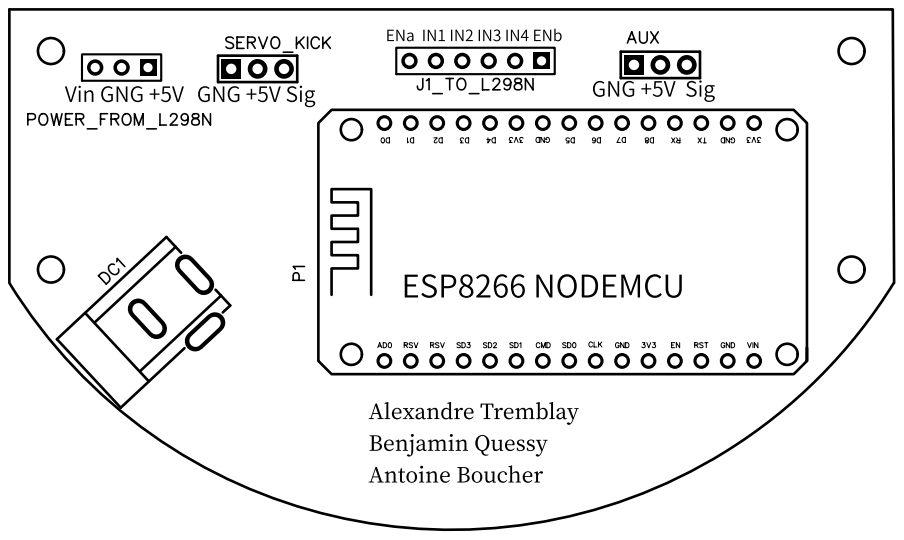
[picture p120: page 1]
