squidlydeadly/projet-5-credits/CAD_and_drawing/FORME_DESSUS.pdf

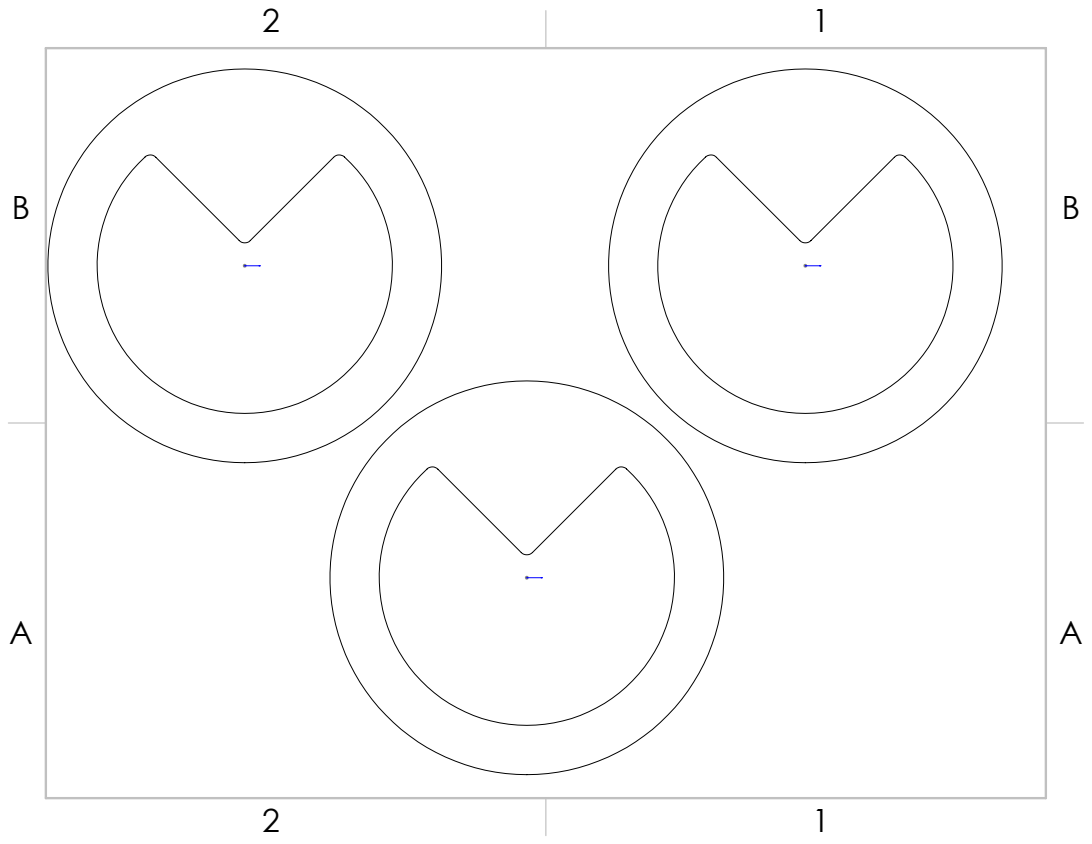
[picture p121: page 1]
