squidlydeadly/projet-5-credits/CAD_and_drawing/ROBOT/FORME_DESSUS_O_B_A.PDF

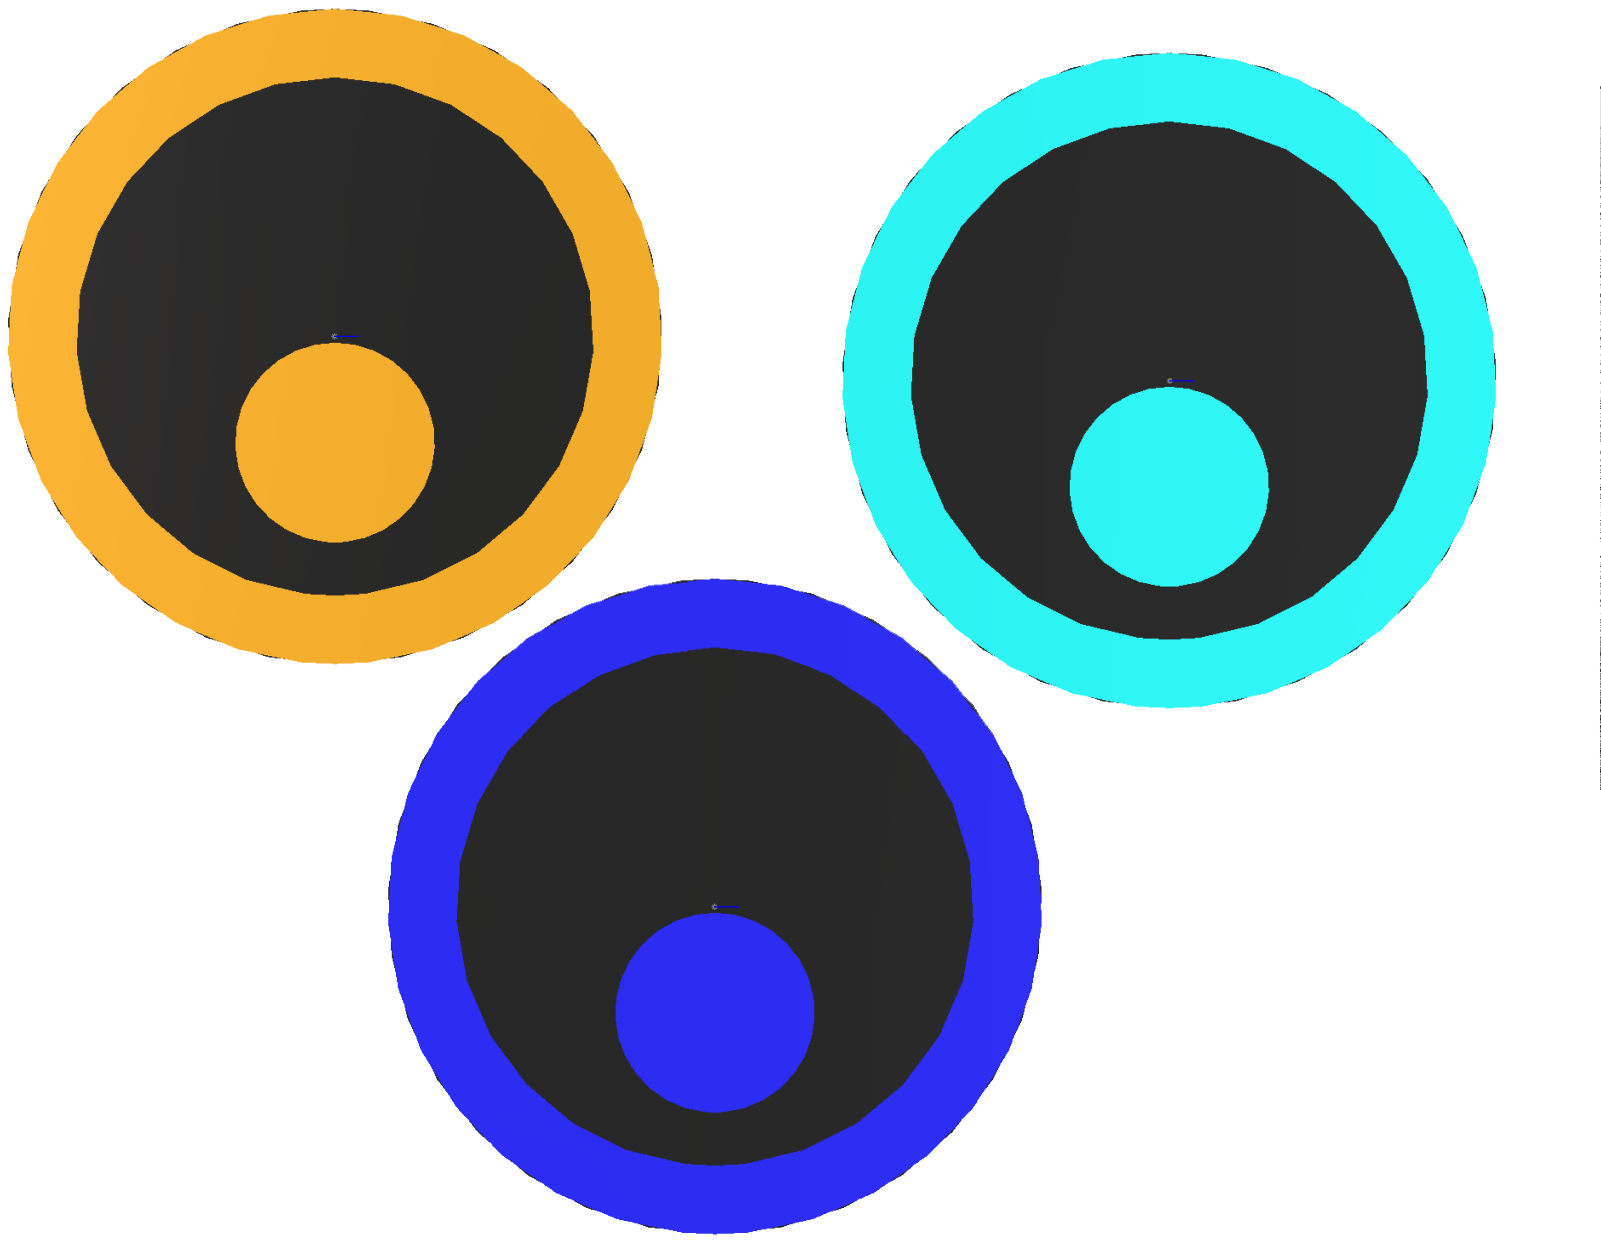
[picture p122: page 1]
