squidlydeadly/projet-5-credits/CAD_and_drawing/ROBOT/FORME_DESSUS_V_J_R.PDF

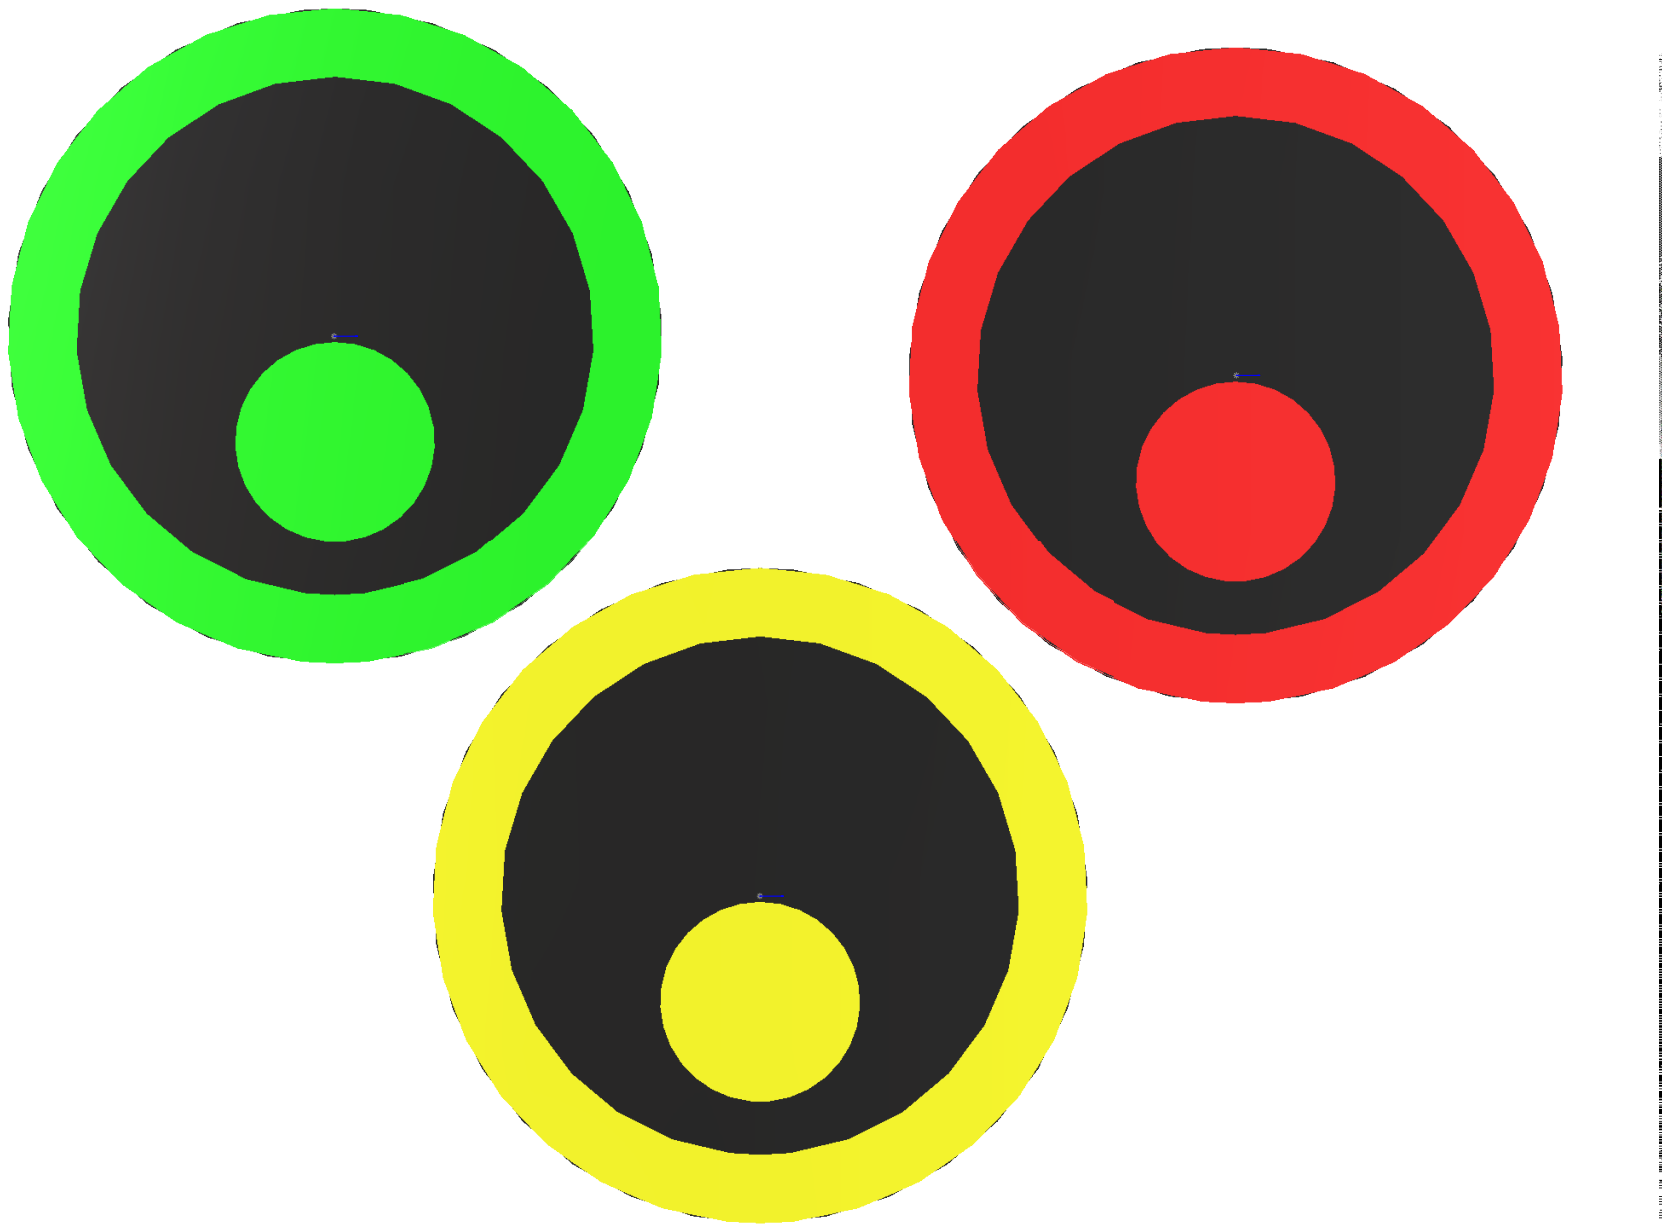
[picture p123: page 1]
