squidlydeadly/projet-5-credits/CAD_and_drawing/ROBOT/FORME_DESSUS.pdf

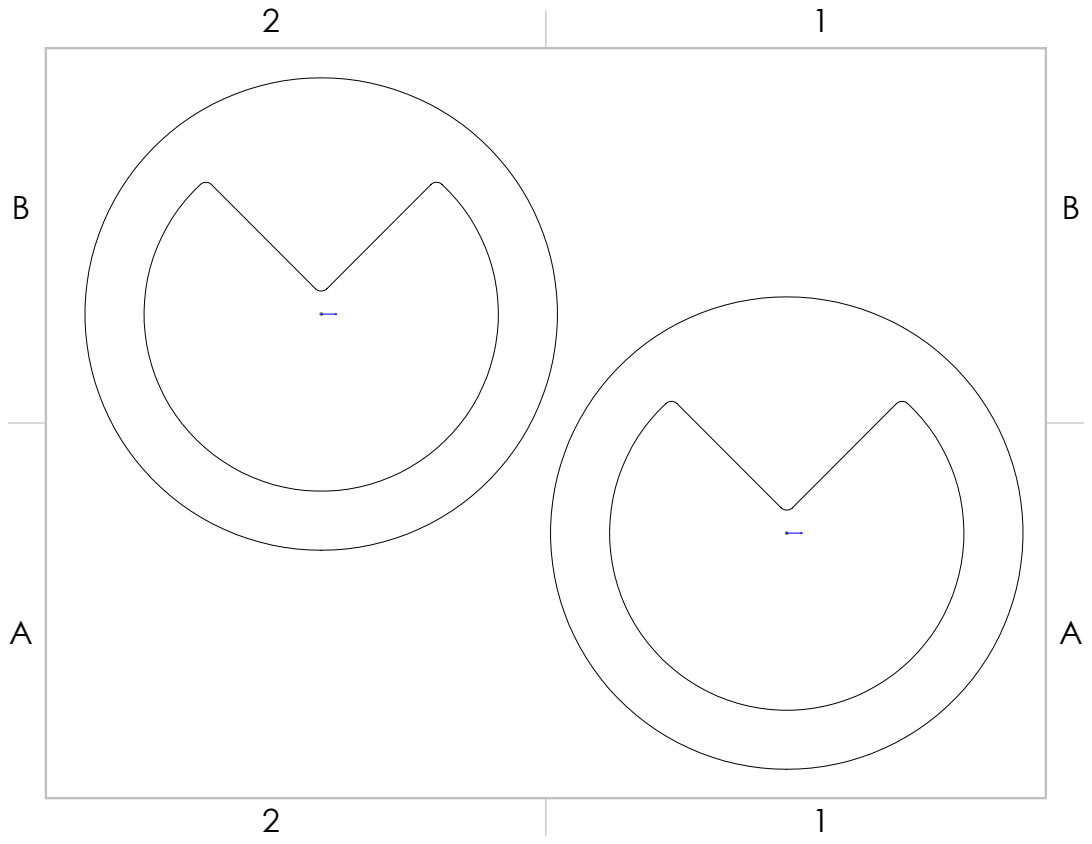
[picture p124: page 1]
