squidlydeadly/projet-5-credits/(commit log)

2020-04-09 -added plan de cours
2020-09-28 added proposition de services
2020-10-01 added estimations selon choix
    [Proposition.xlsx]
2020-10-01 Create Proposistion de servicesRev3.pdf
2020-10-01 Update Proposistion de servicesRev3.pdf
2020-10-02 added matrice décision
    [matrice-de-descision-1.xlsx]
2020-11-05 Added preuve de concepte
2020-11-12 ajout fichier
    ajout fichier
    [Part1.SLDPRT, Part1.STL]
2020-11-20 created MS gant
    [matrice-de-descision-1.xlsx]
2020-11-25 restructuration repo
    [Coût.xlsx, Estimations_architecture.xlsx, Part1.SLDPRT, Part1.STL, Projet.csv, matrice-de-descision-1.xlsx]
2020-12-27 updated gantt
    [Coût.xlsx, matrice-de-descision-1.xlsx]
2020-12-29 sw part
    [Kick_manipulator.SLDASM, Kick_manipulator_base.SLDPRT, Kicker.SLDPRT, Static_Ball_manipulator.SLDPRT, sg90.SLDPRT]
2021-01-28 cad et facture
    [Assem1.SLDASM, Kick_manipulator.SLDASM, Kick_manipulator_base.SLDPRT, Kick_manipulator_base.STL, Kicker.SLDPRT, top_1+base.STL, top_1.SLDPRT]
2021-03-04 pcb and field
    pcb and field
    [Assem1.SLDASM, BALL_END.SLDPRT, CAMERA_HOLDER.SLDPRT, CORNER.SLDPRT, DC Motor Gearbox.SLDASM, DC Motor Gearbox.STEP, FORME_DESSUS.SLDDRW, FORME_DESSUS.SLDPRT]
2021-03-04 pcb
    pcb
2021-03-05 avec parametre de cam
2021-03-05 ajout de sleep
2021-03-08 cad end xvox
    [Assem1.SLDASM, BALL_END.SLDPRT, CORNER.SLDPRT, PFE_ASS.SLDASM, PLANCHE_LARGEUR.SLDPRT, PLANCHE_LONGUEUR.SLDPRT, PLANK_END.SLDPRT, TERRAIN.SLDASM]
2021-03-23 modified cad
    [fabriquation piece.xlsx]
2021-03-31 pcb img
2021-04-07 code
    code
    [facture Alexandre Tremblay.xlsx]
2021-04-18 post détaillé
    [Estimations_architecture.xlsx]
